Pinheirogustavo/Gustavo_TG_biomedica/README.md

# Gustavo_TG_biomedica
Este repositório se destina aos programas desenvolvidos durante a disciplina de Trabalho de Graduação em Engenharia Biomédica na Universidade Federal do ABC (UFABC). O tema do projeto é: Desenvolvimento de equipamento de análise de bioimpedância baseado em STM32
