Pinheirogustavo/Gustavo_TG_biomedica/Projetos das placas de circuito impresso/Kicad/Fonte de corrente monopolar/README.md

# Fonte de corrente monopolar

## Descrição Geral do projeto

Fonte de corrente controlada por tensão monopolar do tipo Howoland aperfeiçoada. O Sistema é excitado por um sinal senoidal e fornece uma corrente alternada de amplitude constante frente uma banda de resistências. Há um sistema de monitoramento da amplitude da corrente (Ampl1) que é implementado com um circuito de condicionamento dedicado.

Estágios Fonte de Corrente: Sinal de entrada(Sin1 ou SinA) &rarr; buffer &rarr; arquitetura fonte Howland &rarr; Resistor Sentinela//Amplificador de Instrumentação &rarr;  corrente I1.

Estágios monitoramento: Amplificador de Instrumentação &rarr; AmpOp &arrar; circuito de condicionamento &rarr; amplitude da corrente Ampl1.

## Componentes do circuito:

- Amplificador Operacional Dual AD826/828: Amplificador operacional duplo implementado como buffer na entrada do sistema e de acordo com a arquitetura da fonte Howland aperfeiçoada.
	>Amplificador 1: buffer.
	
	>Amplificador 2: arquitetura da fonte Howland aperfeiçoada.
- Resistor sentinela: Resistor de baixa resistência em série com a saída da fonte Howland. Implementado para monitorar a corrente gerada.
- Amplificador de Instrumentação INA: Amplificador de Instrumentação verifica a tensão sobre o resistor sentinela e aplica alto ganho fixo. A tensão de saída é condicionada e indica a amplitude da corrente (Ampl1).  Implementado para monitorar a corrente gerada. 
- Circuito de condicionamento: Condiciona o sinal para os limites do ADC do controlador (Selecionado com jumpers nos pinos "Vref" 3.3/5V). 

## Cuidados a serem tomados

## Estágios do circuito

#### Entrada do sinal de controle de corrente:

O sinal de entrada (Vin) determina a amplitude e frequência da corrente gerada. O sistema permite dois sinais de entrada, Sin1 e SinA, que são selecionados por uma chave gangorra kcd1.

A frequência da corrente é a mesma do sinal de entrada Vin. A amplitude da corrente é dada por:

$$ I = \frac{V_{in}}{R_6} $$

#### Buffer:

Buffer implementado na entrada do sistema com o amplificador operacional dual uma vez que o circuito do gerador de sinais foi projetado sem buffer em sua saída.

#### Arquitetura fonte Howland:

Fonte monopolar do tipo Howland aperfeiçoada.

#### Resistor sentinela e amplificador de instrumentação

#### Circuito de condicionamento

## Esquemático

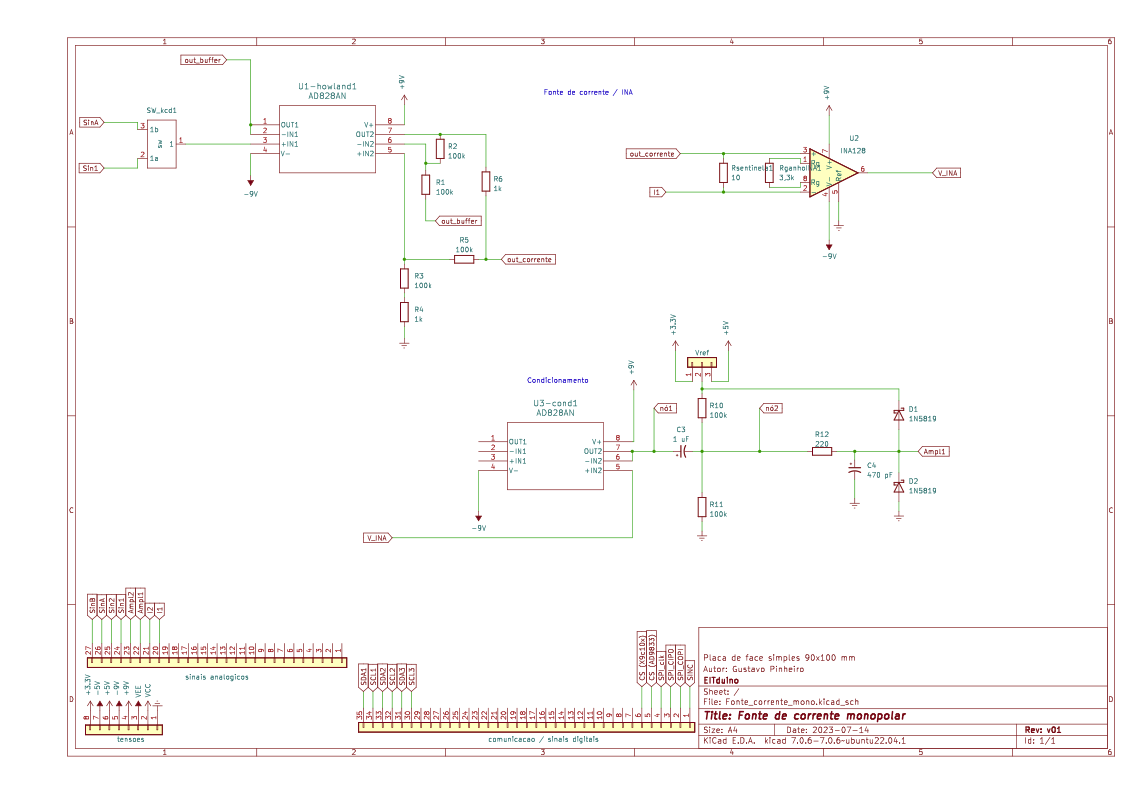
[picture p4: Projetos das placas de circuito impresso/Kicad/Fonte de corrente monopolar/prints/Fonte_corrente_monopolar_esquematico.png]
Fonte de corrente howland aperfeiçoada monopolar - Kicad


## PCB

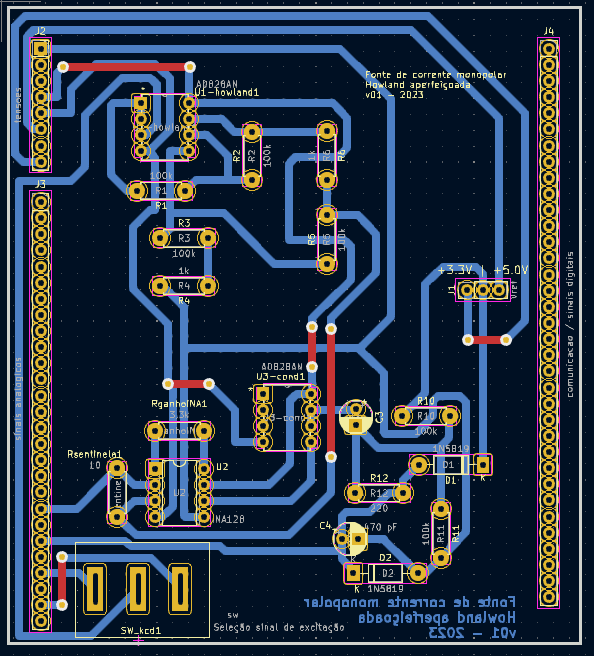
[picture p5: Projetos das placas de circuito impresso/Kicad/Fonte de corrente monopolar/prints/Fonte_corrente_monopolar_esquematico_PCB.png]
Fonte de corrente howland aperfeiçoada monopolar PCB - Kicad


## PCB-3D

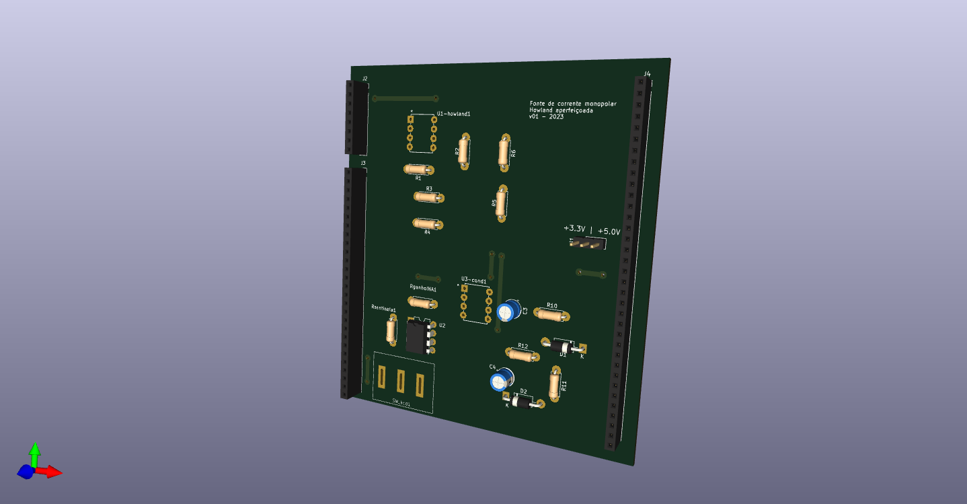
[picture p6: Projetos das placas de circuito impresso/Kicad/Fonte de corrente monopolar/prints/Fonte_corrente_mono_3D.png]
Fonte de corrente howland aperfeiçoada monopolar - PCB 3D Kicad


## PCB máscara

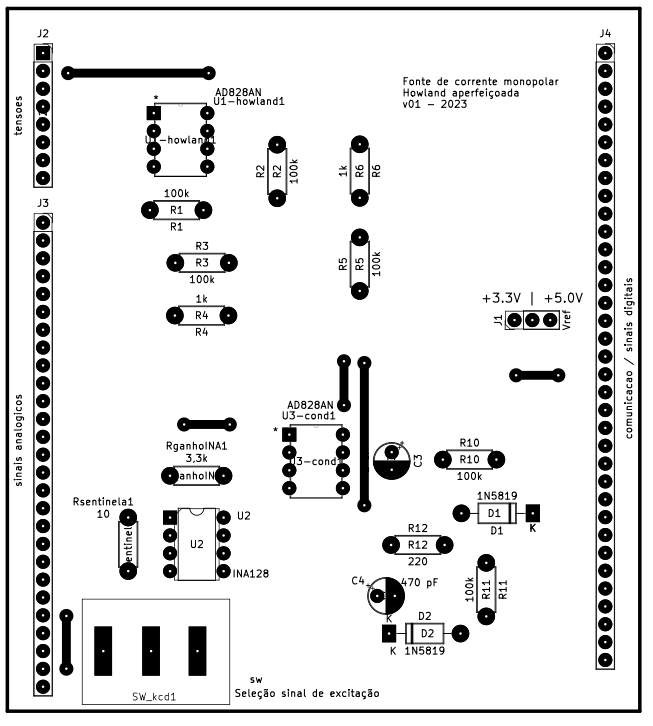
[picture p7: Projetos das placas de circuito impresso/Kicad/Fonte de corrente monopolar/prints/print_legenda.png]
Fonte de corrente howland aperfeiçoada monopolar - PCB máscara Kicad
