Pinheirogustavo/Gustavo_TG_biomedica/Projetos das placas de circuito impresso/Kicad/Gerador de sinais/README.md

# Gerador de Sinais

## Descrição Geral do projeto

Sistema que gera um sinal senoidal com controle de amplitude e frequência.

Estágios: Gerador de sinais ( CA@300mV + DC) &rarr; Filtro  passa-alta &rarr; SinA (CA@300mV) &rarr; buffer &rarr;  amplificador não-inversor &rarr; Sin1(CA@300mV-3V).

## Componentes do circuito:

- Arduino nano: controlador do sistema
- AD9833: gerador de sinais confeccionado em módulo. Gera uma onda senoidal de amplitude fixa de 300mA e offset
- Ad828: Amplificador operacional dedicado ao ganho de sinal. 
	>Amplificador 1 é buffer entre o filtro passa-alta e o circuito de ganho.
	>Amplificador 2 é um amplificador não inversor. Vout = (1+pot/R2)*Vin
- X9c10x: potenciometro digital dedicado ao ganho de sinal

## Cuidados a serem tomados

Para a comunicação SPI, o dispositivo a ser controlado (Chip Select) é selecionado quando o respectivo pino CS está em LOW. Nunca pode-se permitir que dois dispositivos estejam com CS em LOW ao mesmo tempo. Por isso, no programa é preciso garantir que as operações com o AD9833 (select_wave, freq+ e freq-)  após um delay tragam o sinal do CS(AD9833) para LOW e depois devolvam para HIGH. E que as operações com o X9110X (aumento de R, redução de R, guardar R) após um delay tragam o sinal do CS(X9c10X) para LOW e depois devolvam para HIGH.

Assim, primeiramente o programa deve liberar o AD9833 (gerador de sinais) para ocupar a comunicação SPI, após a geração de sinal, desligar sua comunicação (trazer seu CS para HIGH) e liberar a comunicação SPI para ser requisitada a partir dos botões referentes a cada dispositivo. 

## Estágios do circuito

#### Entradas e saídas digitais do arduino nano:

>D2:  cs (X9X104) - Saída digital. Sinal de Chip Select do potenciômetro digital - "The device is selected when the CS input is LOW." 

>D3: storage_R - Usado para armazenar o valor de resistência - Botão 4 - Pressionar o botão faz o sinal X9c10x_INC  ficar em HIGH e o sinal  cs(X9X104) passar de HIGH para LOW e retornar a HIGH

>D4:  cs (AD9833) - Sinal de Chip Select do gerador de sinais

>D5:  Up_pot - Aumenta a resistência do potenciômetro (aumenta o ganho do sistema) - Botão 5 - Pressionar o botão faz com que o sinal de cs(X9X104) passe de HIGH para LOW, que o sinal X9c10x_INC altere de HIGH para LOW e o sinal  X9c10x_U/D fique em HIGH. Ao liberar o botão, o sinal de cs(X9X104) deve retornar para HIGH.
	 
>D6:  Down_pot - Reduz a resistência do potenciômetro (reduz o ganho do sistema) - Botão 6 - Pressionar o botão faz com que o sinal de cs(X9X104) passe de HIGH para LOW, X9c10x_INC altere de HIGH para LOW e o sinal  X9c10x_U/D fique em LOW. Ao liberar o botão, o sinal de cs(X9X104) deve retornar para HIGH.

>D7:  X9c10x_INC - Saída digital. Responsável pelo disparo do sinal que habilita o incremento e o decremento da resistência. Alterado pelos sinais em Up_pot/Down_pot.

>D8:  X9c10x_U/D -  Saída digital. Responsável pela seleção do sinal de incremento ou decremento da resistência. Controlado pelos sinais em Up_pot/Down_pot.

>D9:  freq+   - Incrementa a frequência do sinal (a definir o tamanho do incremento) - Botão 2 - Ainda não implementado no programa.

>D10: freq-   - Decrementa a frequência do sinal (a definir o tamanho do decremento) - Botão 3 - Ainda não implementado no programa.

>D11: SPI_COPI - Saída digital. Sinal de controle do arduino para a entrada SDATA do gerador de sinais.

>D12: S_wave - Seleciona a forma de onda desejada (seno, triangular ou quadrada) - Botão 1 - Ainda não implementado no programa.

>D13: SPI_clk - Saída digital. Sinal de clock entre o arduino e o gerador de sinais

#### O potenciômetro digital

- Programa baseado em: https://www.electroniclinic.com/digital-potentiometer-x9c103s-arduino-circuit-and-programming/

- Pin Descriptions - X9c10x:

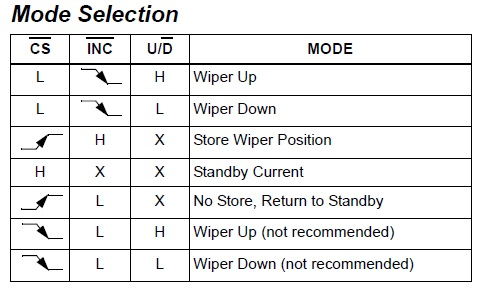
[picture p8: Projetos das placas de circuito impresso/Kicad/Gerador de sinais/Datasheets/Digital-Potentiometer-X9C103s-Mode-selection.jpg]
Pin Descriptions - X9c10x


#### O Gerador de sinais

- Programa baseado em: https://www.electroniclinic.com/ad9833-programmable-waveform-generator-using-arduino/
- Biblioteca necessária: https://github.com/Billwilliams1952/AD9833-Library-Arduino

## Esquemático

Esquemático Gerador de sinais - Kicad

## PCB

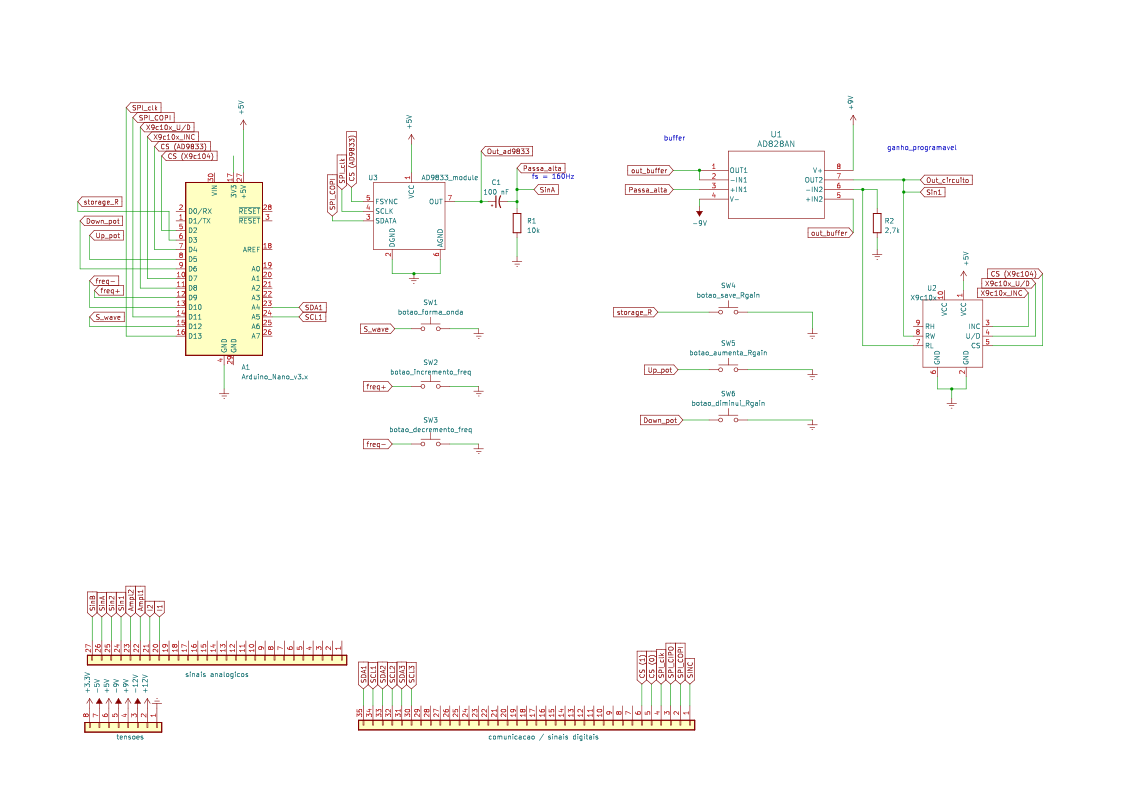
[picture p9: Projetos das placas de circuito impresso/Kicad/Gerador de sinais/print/Gerador_sinais_AD9833_esquematico.png]
Gerador de sinais AD9833 PCB - Kicad


## PCB-3D

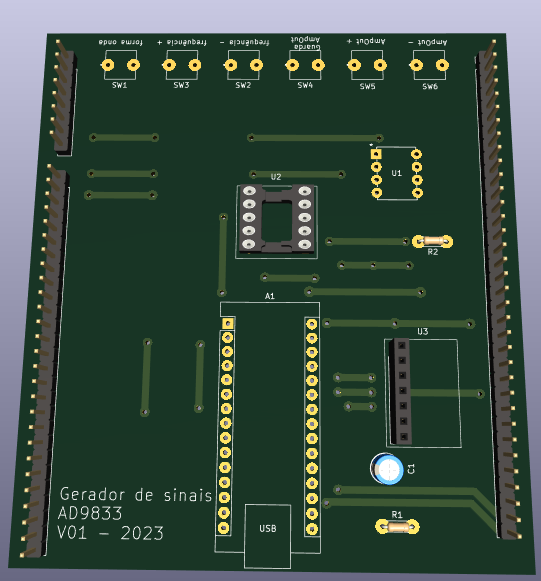
[picture p10: Projetos das placas de circuito impresso/Kicad/Gerador de sinais/print/Gerador_sinais_AD9833_PCB_3D.png]
Gerador de sinais AD9833 PCB 3D - Kicad


## PCB Máscara

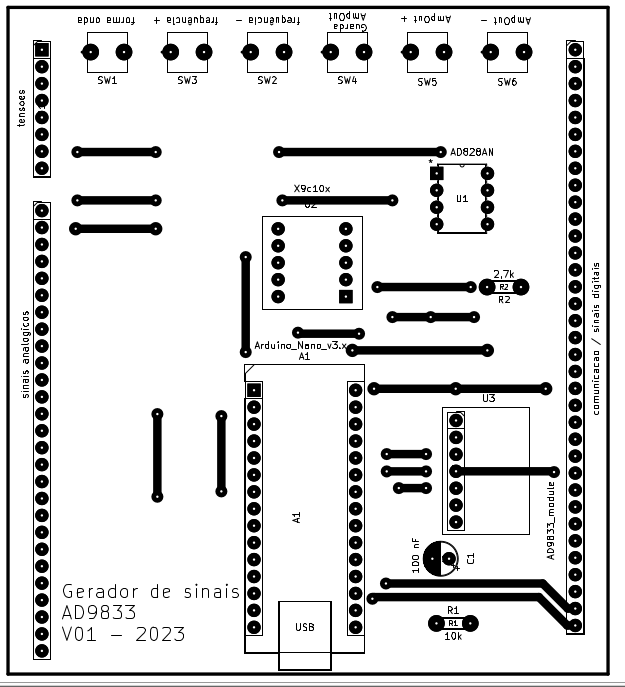
[picture p11: Projetos das placas de circuito impresso/Kicad/Gerador de sinais/print/print_mascara.png]
Gerador de sinais AD9833 PCB Máscara - Kicad
