Pinheirogustavo/Gustavo_TG_biomedica/Projetos das placas de circuito impresso/Kicad/Barramento/V03/README.md

# V02

- Diversos pontos de terras, separados em terras dos sinais analógicos (AGND) e terras dos sinais digitais (DGND).
- As alimentações dos circuitos analógicos foram separadas das alimentações dos circuitos digitais.

# Esquemático

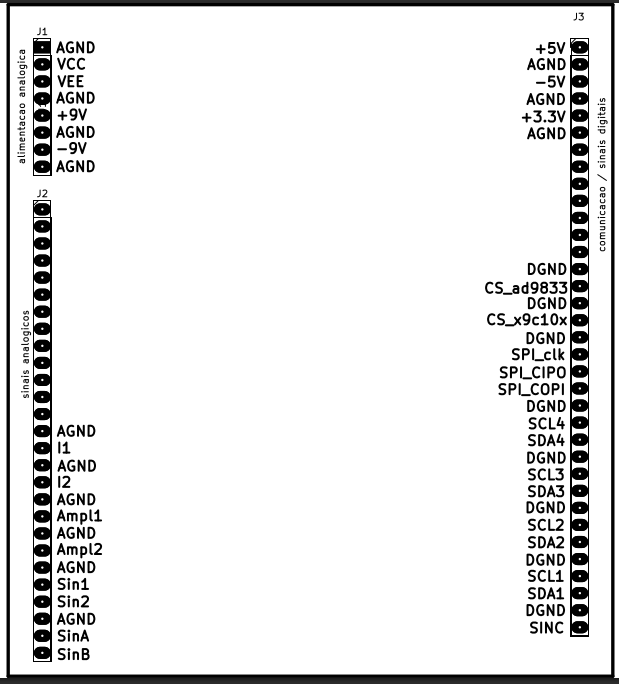
[picture p12: Projetos das placas de circuito impresso/Kicad/Barramento/V03/print/barramento_v02.png]
Barramento EITduino V02 preto e branco - Kicad


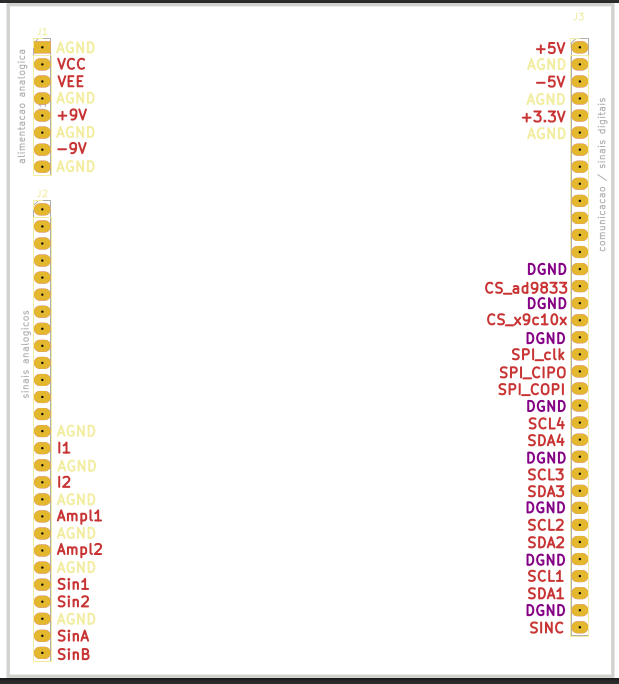
[picture p13: Projetos das placas de circuito impresso/Kicad/Barramento/V03/print/barramento_v02_colorido.png]
Barramento EITduino V02 colorido - Kicad
