Pinheirogustavo/Gustavo_TG_biomedica/Projetos das placas de circuito impresso/Kicad/Fonte de tensão/Fonte_tensao_LM675_v03/README.md

# Fonte de tensão - Versão 03

## Esquemático

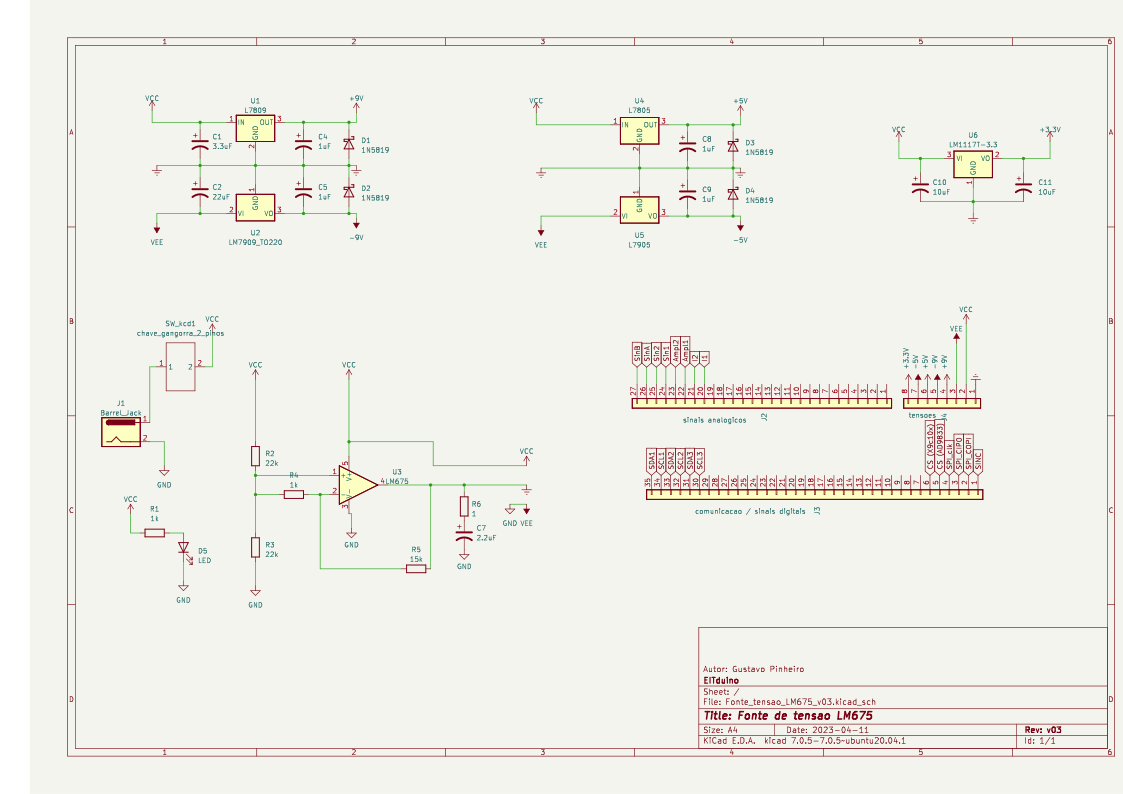
[picture p14: Projetos das placas de circuito impresso/Kicad/Fonte de tensão/Fonte_tensao_LM675_v03/print/Fonte_tensao_v03_esquematico.png]
Legenda Esquematico- Kicad


## PCB

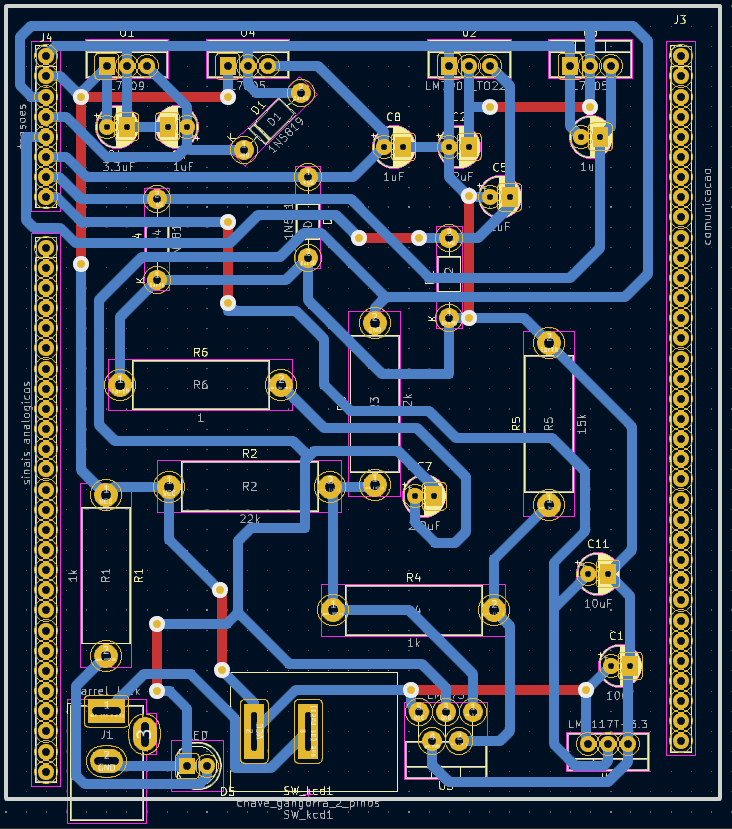
[picture p15: Projetos das placas de circuito impresso/Kicad/Fonte de tensão/Fonte_tensao_LM675_v03/print/Fonte_tensao_PCB_v03.png]
Legenda PCB- Kicad


## PCB-3D

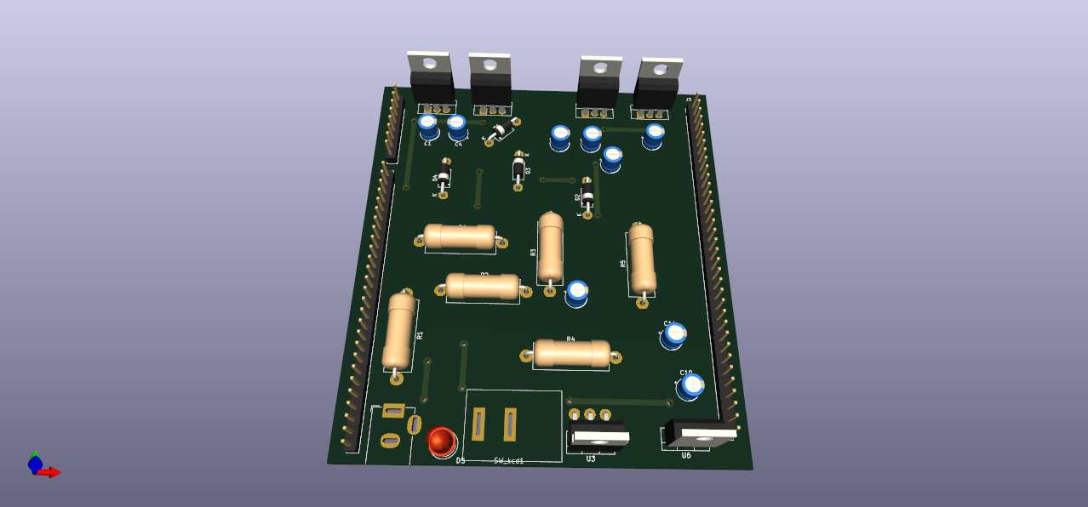
[picture p16: Projetos das placas de circuito impresso/Kicad/Fonte de tensão/Fonte_tensao_LM675_v03/print/Fonte_tensao_PCB_3D_v03.png]
legenda PCB 3D - Kicad


## PCB Máscara

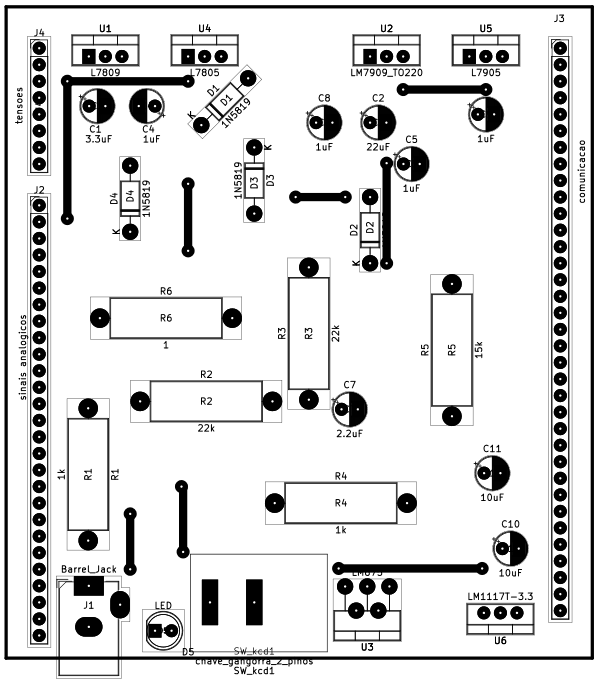
[picture p17: Projetos das placas de circuito impresso/Kicad/Fonte de tensão/Fonte_tensao_LM675_v03/print/Fonte_tensao_PCB_Mascara_v03.png]
legenda PCB Máscara - Kicad
