Pinheirogustavo/Gustavo_TG_biomedica/Projetos das placas de circuito impresso/Kicad/Barramento/V01/README.md

# V01

Único ponto de terra.

# Esquemático

Barramento EITduino V01 preto e branco- Kicad

---------------------------------------------------------------------------------------------------------

Barramento EITduino V01 colorido- Kicad
