Pinheirogustavo/Gustavo_TG_biomedica/Projetos das placas de circuito impresso/Kicad/Fonte de tensão/Fonte_tensao_LM675_v01/README.md

# Fonte de tensão

## Descrição Geral do projeto

XXX.

Estágios:

## Componentes do circuito:

- xx
- xx
	>xx
	
##Cuidados a serem tomados

xx
## Estágios do circuito

#### xx

>xx

>xx

#### xx

- xx

- xx

## Esquemático

Legenda Esquematico- Kicad

## PCB

Legenda PCB- Kicad

## PCB-3D

legenda PCB 3D - Kicad

## PCB Máscara

legenda PCB Máscara - Kicad
