Pinheirogustavo/Gustavo_TG_biomedica/apresentacao/barramento.png

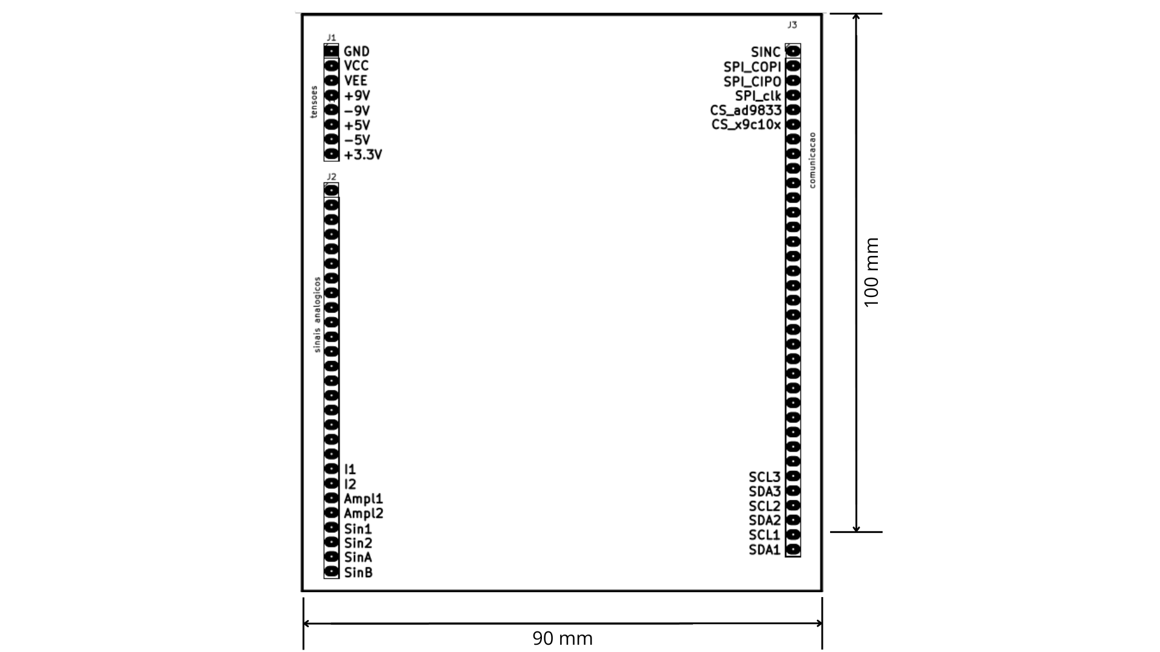
apresentacao/barramento.png
