Pinheirogustavo/Gustavo_TG_biomedica/apresentacao/Completo_1.jpeg

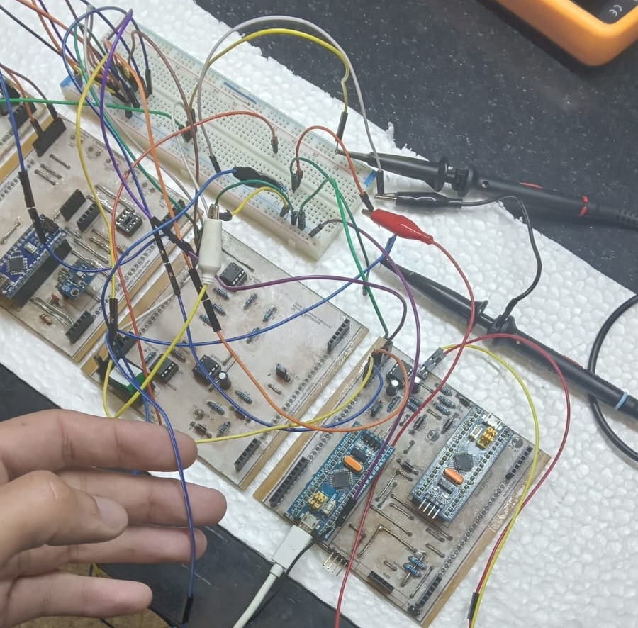
apresentacao/Completo_1.jpeg
