Pinheirogustavo/Gustavo_TG_biomedica/apresentacao/Completo_2.jpeg

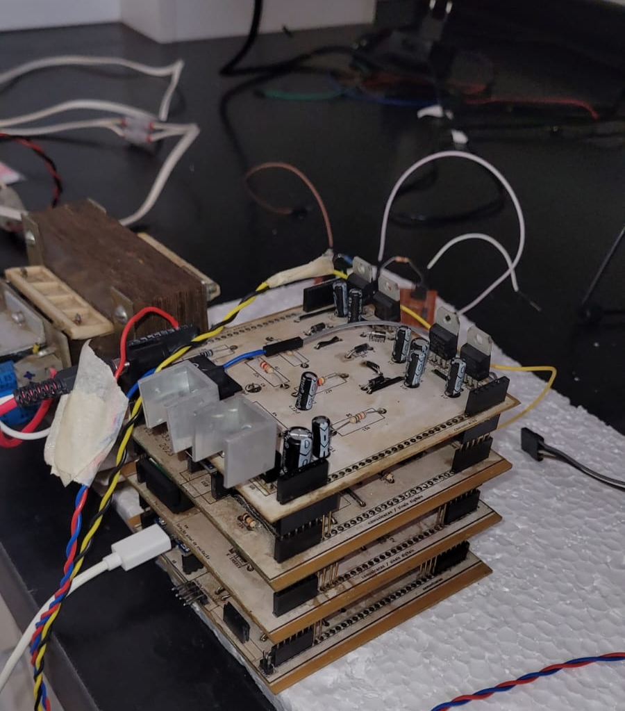
apresentacao/Completo_2.jpeg
