Pinheirogustavo/Gustavo_TG_biomedica/apresentacao/Completo_3.jpeg

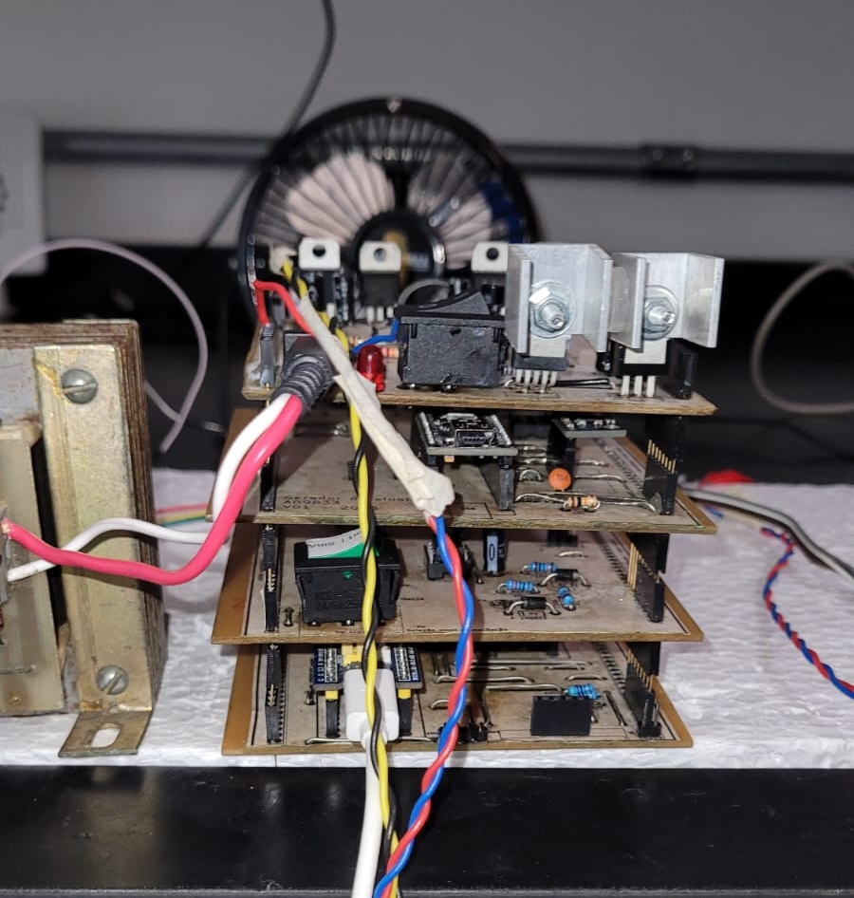
apresentacao/Completo_3.jpeg
