Pinheirogustavo/Gustavo_TG_biomedica/apresentacao/Completo_4.jpeg

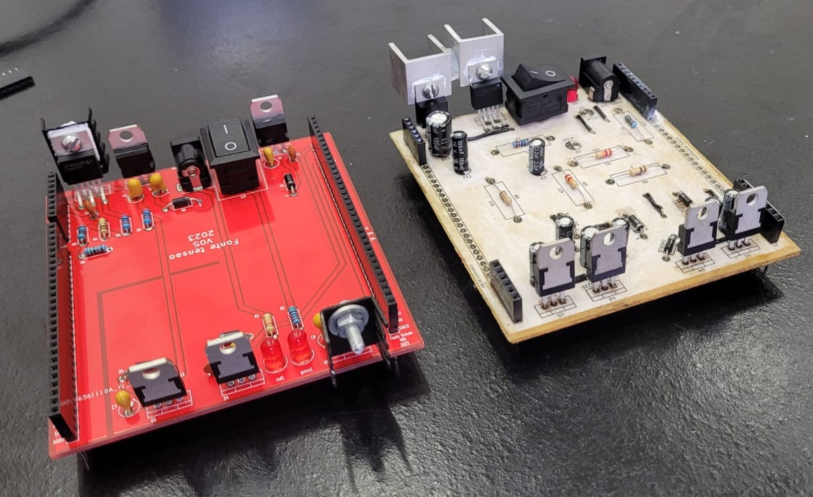
apresentacao/Completo_4.jpeg
