Pinheirogustavo/Gustavo_TG_biomedica/apresentacao/CompletoX.png

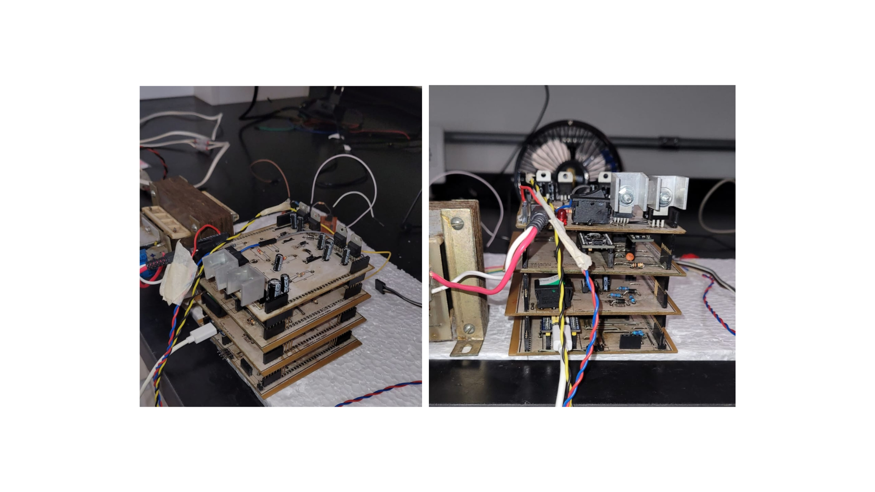
apresentacao/CompletoX.png
