Pinheirogustavo/Gustavo_TG_biomedica/apresentacao/FFM_1.png

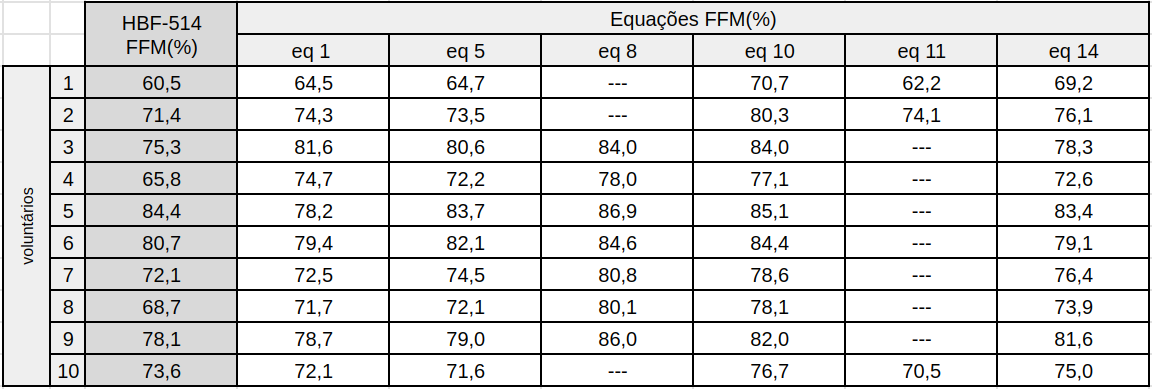
apresentacao/FFM_1.png
