Pinheirogustavo/Gustavo_TG_biomedica/apresentacao/FFM_homens.png

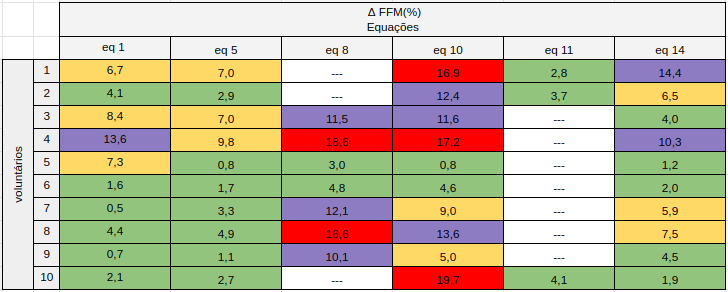
apresentacao/FFM_homens.png
