Pinheirogustavo/Gustavo_TG_biomedica/apresentacao/FFM_mulheres.png

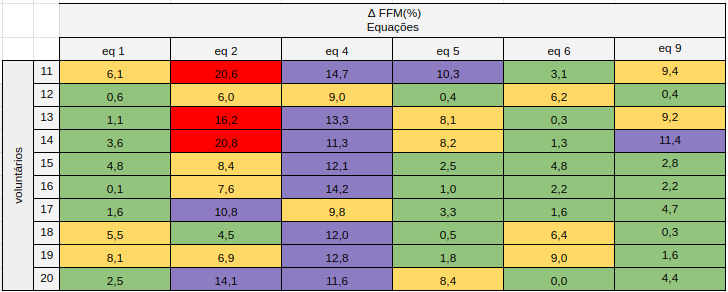
apresentacao/FFM_mulheres.png
