Pinheirogustavo/Gustavo_TG_biomedica/apresentacao/Fonte_tensao_comparacao_baixo.jpeg

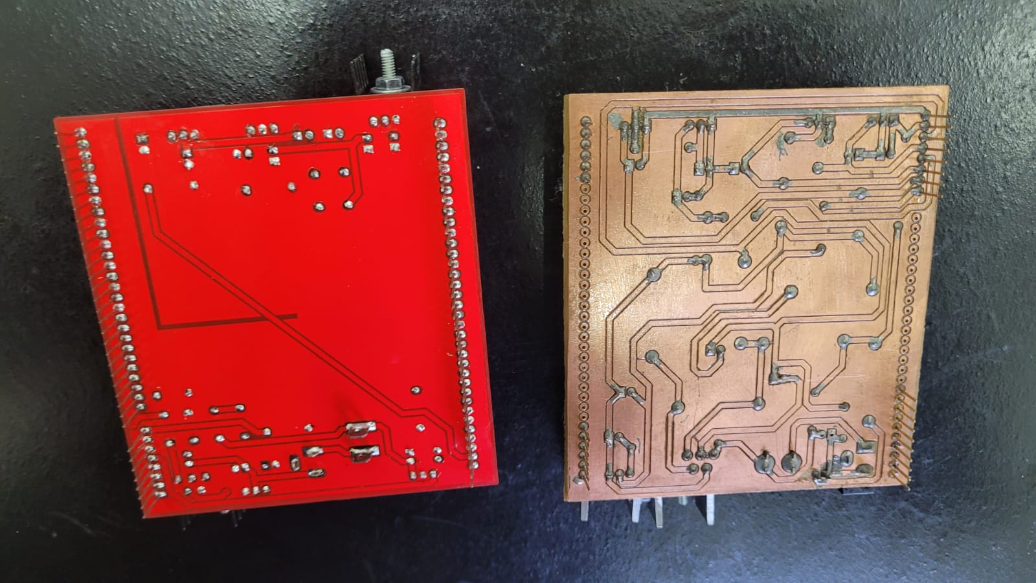
apresentacao/Fonte_tensao_comparacao_baixo.jpeg
