Pinheirogustavo/Gustavo_TG_biomedica/apresentacao/Fonte_tensao_comparacao_cima.jpeg

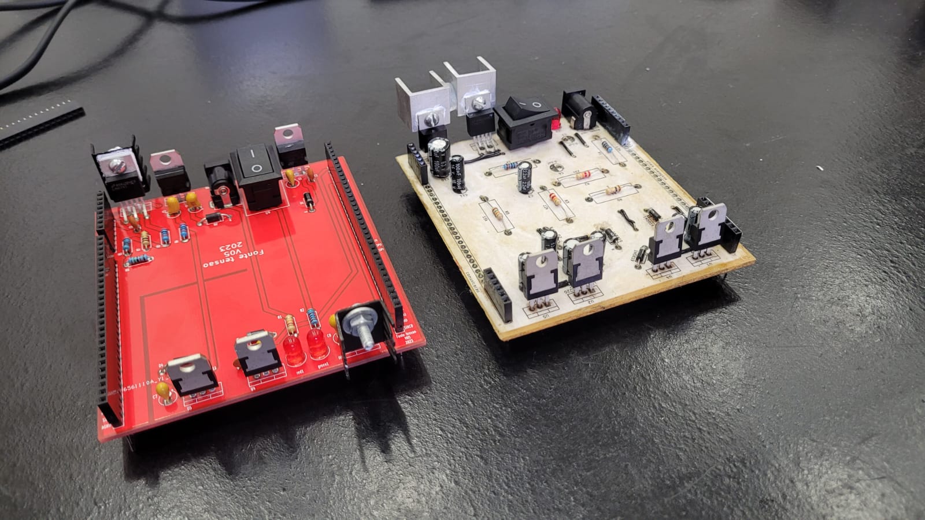
apresentacao/Fonte_tensao_comparacao_cima.jpeg
