Pinheirogustavo/Gustavo_TG_biomedica/apresentacao/largura_banda_ampOps.png

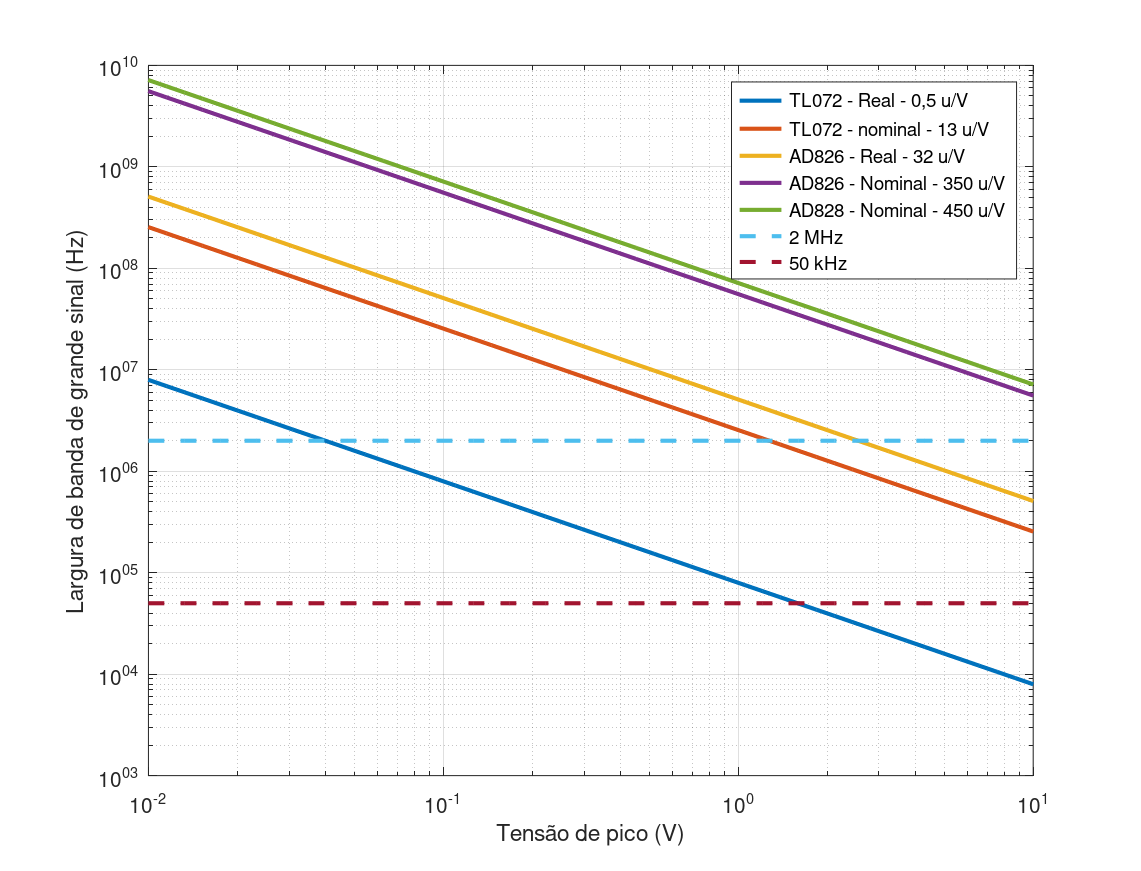
apresentacao/largura_banda_ampOps.png
