Pinheirogustavo/Gustavo_TG_biomedica/apresentacao/largura_banda_sr.jpg

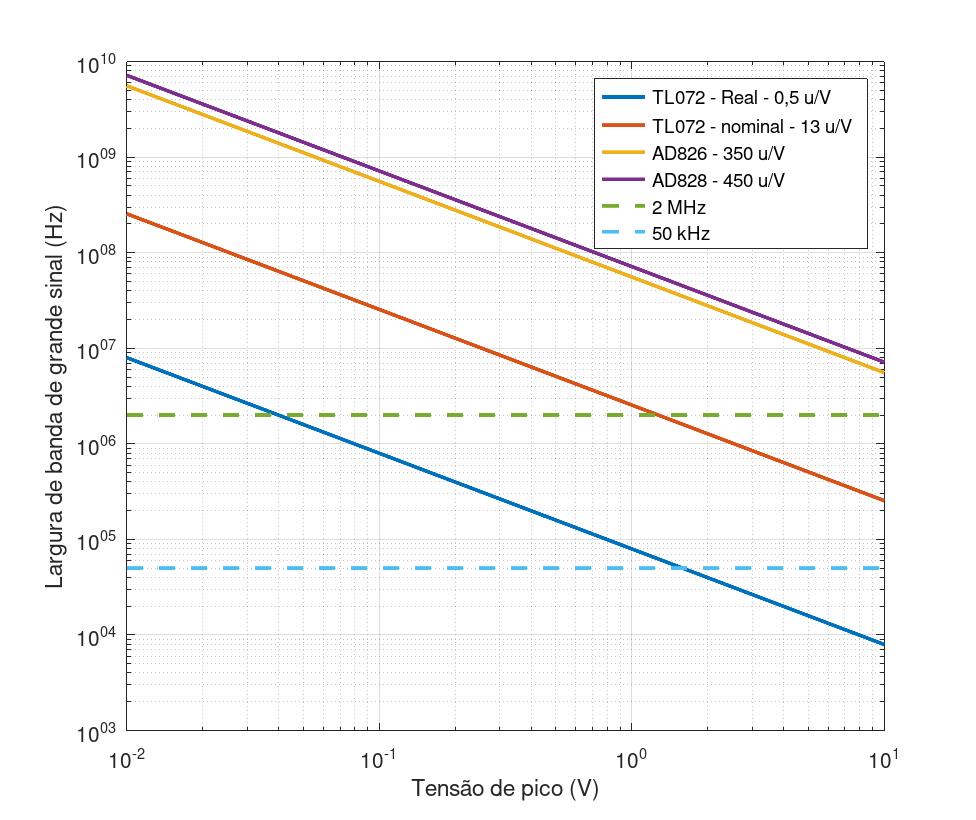
apresentacao/largura_banda_sr.jpg
