Pinheirogustavo/Gustavo_TG_biomedica/apresentacao/resumo.jpg

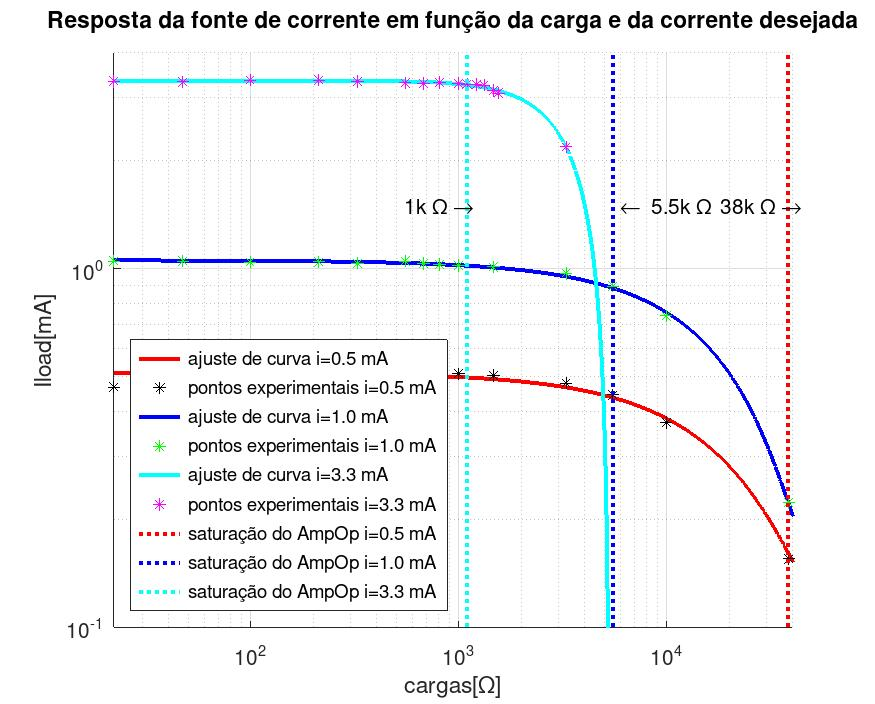
apresentacao/resumo.jpg
