Pinheirogustavo/Gustavo_TG_biomedica/apresentacao/TBW_2.png

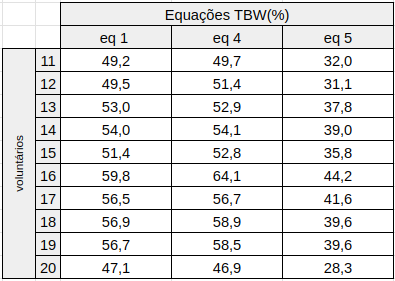
apresentacao/TBW_2.png
