Pinheirogustavo/Gustavo_TG_biomedica/apresentacao/temp/Condicionamento_geral.png

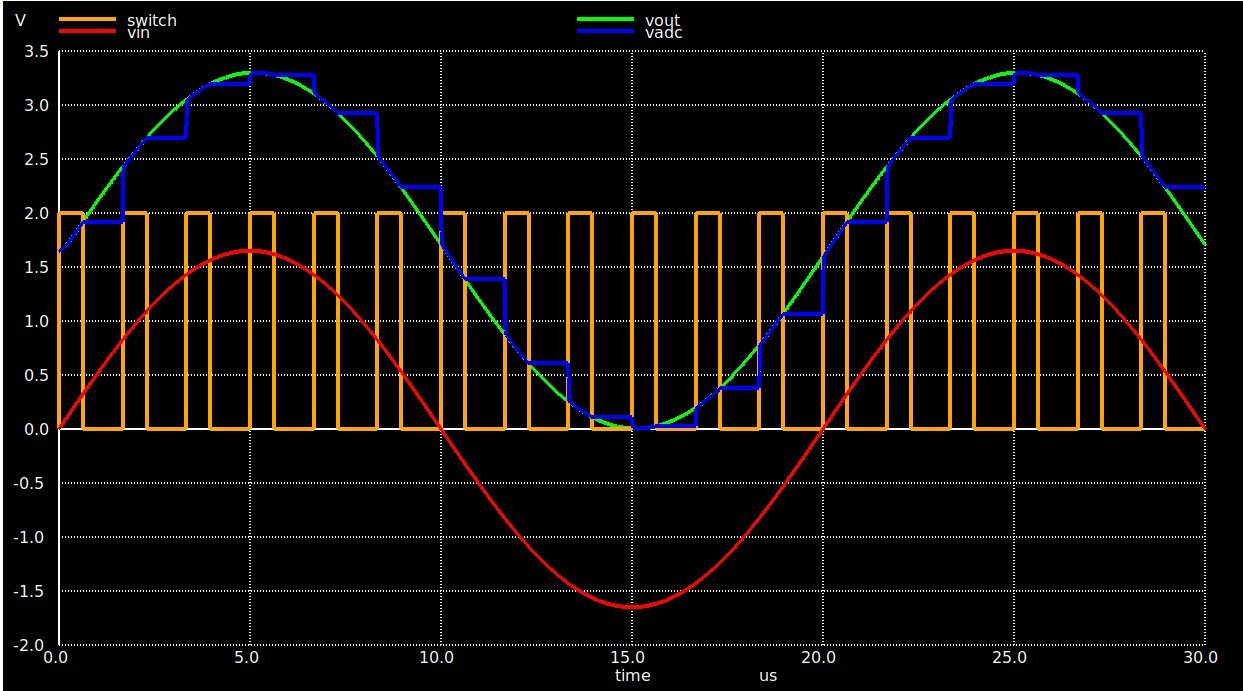
apresentacao/temp/Condicionamento_geral.png
