Pinheirogustavo/Gustavo_TG_biomedica/apresentacao/temp/Condicionamento_geral_invertido.png

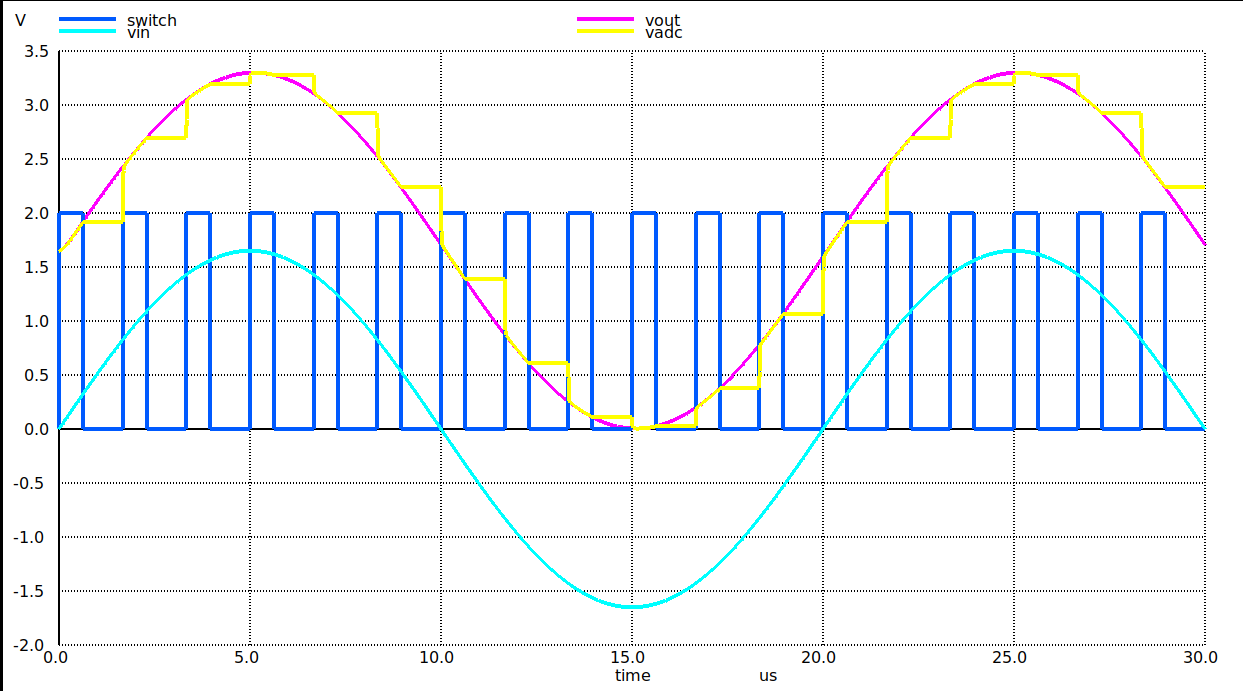
apresentacao/temp/Condicionamento_geral_invertido.png
