Pinheirogustavo/Gustavo_TG_biomedica/apresentacao/temp/Erro_adc.png

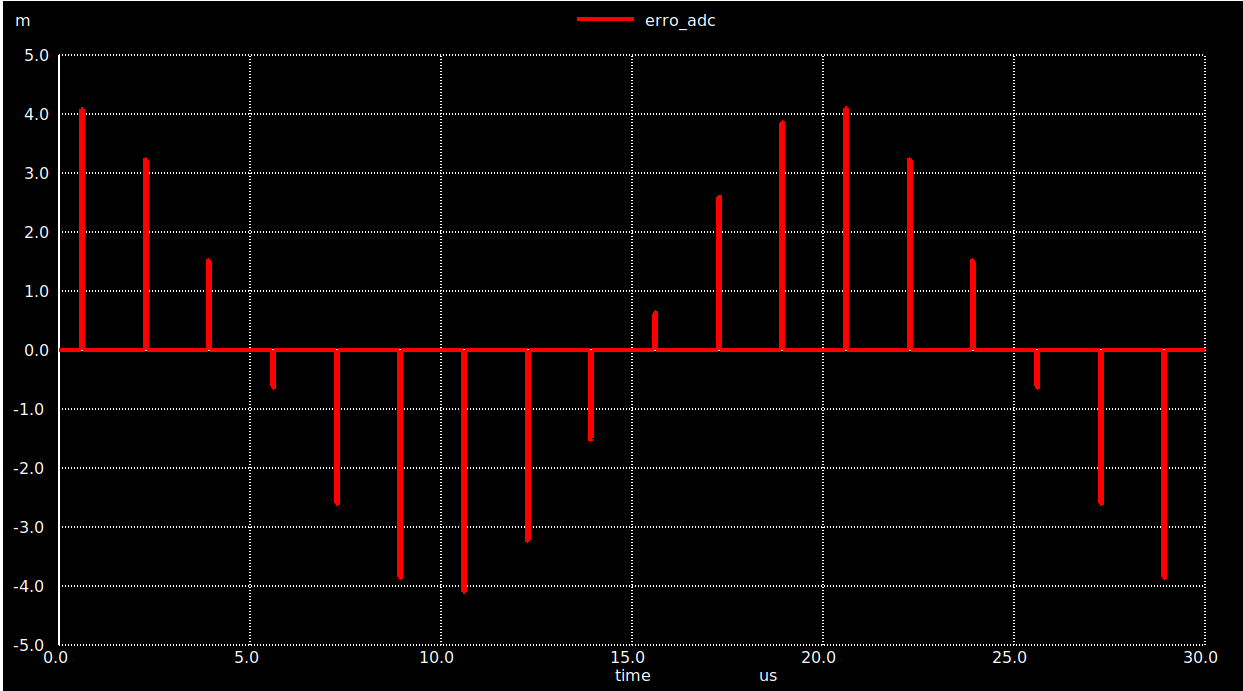
apresentacao/temp/Erro_adc.png
