Pinheirogustavo/Gustavo_TG_biomedica/apresentacao/temp/Erro_buffer.png

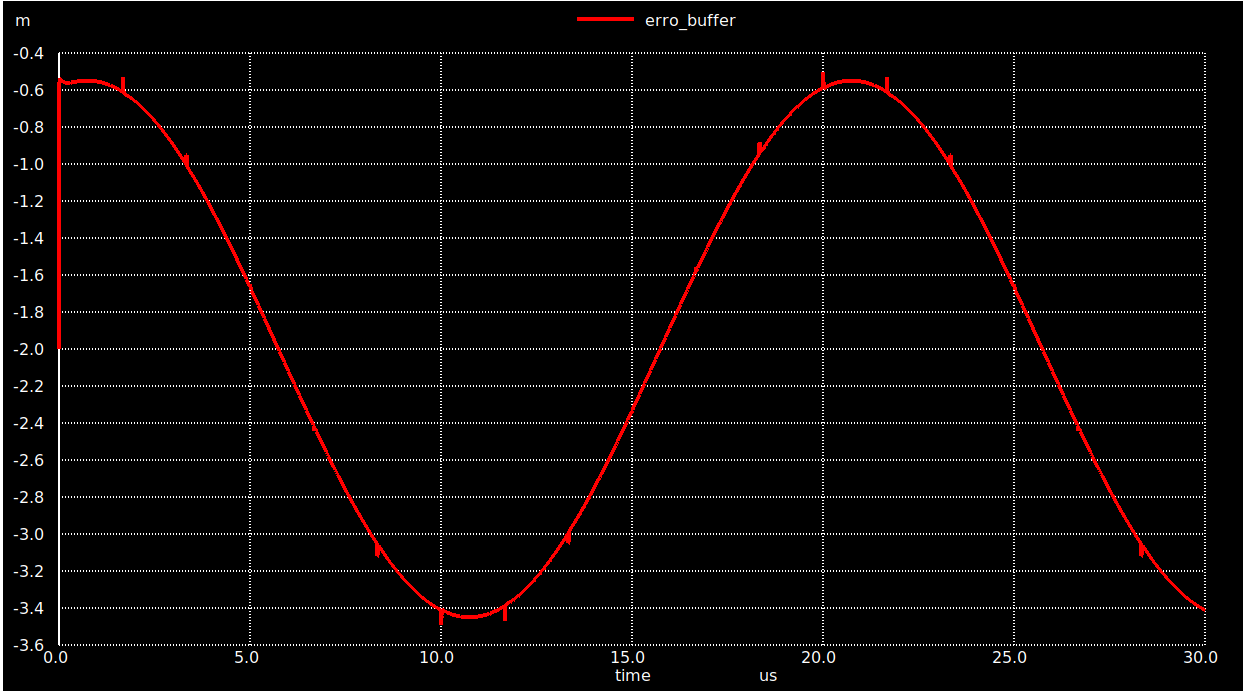
apresentacao/temp/Erro_buffer.png
