Pinheirogustavo/Gustavo_TG_biomedica/apresentacao/temp/Erro_fpb.png

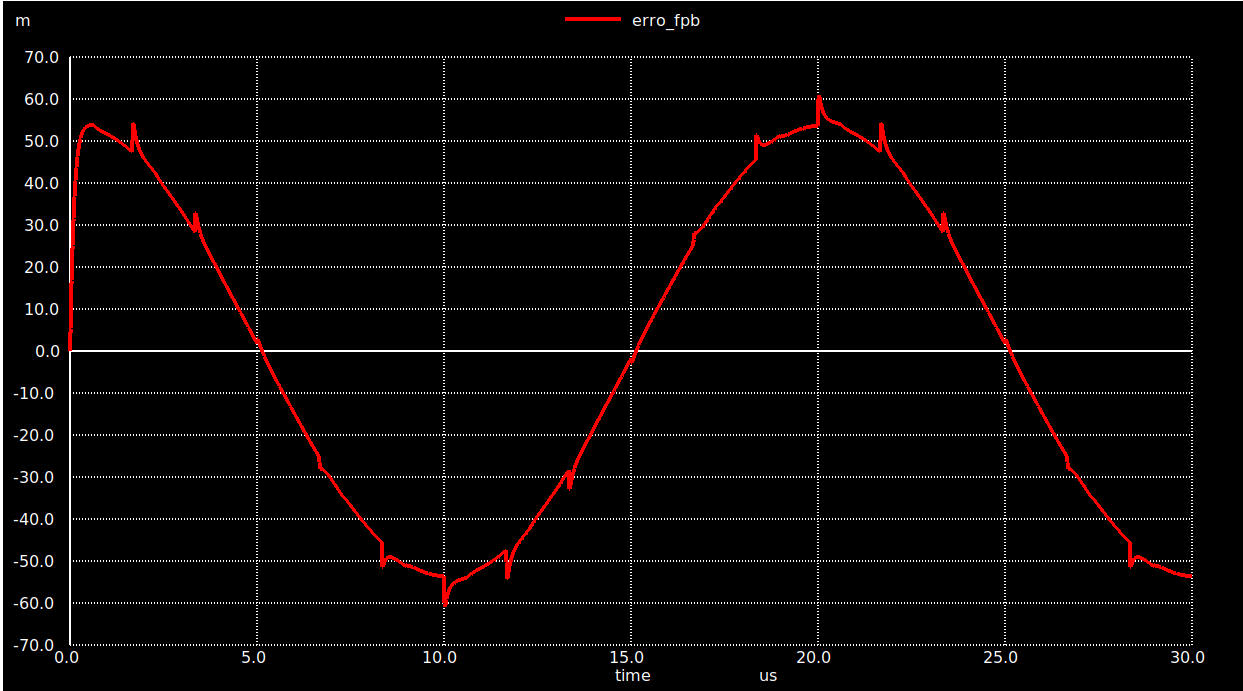
apresentacao/temp/Erro_fpb.png
