Pinheirogustavo/Gustavo_TG_biomedica/apresentacao/temp/Erro_os.png

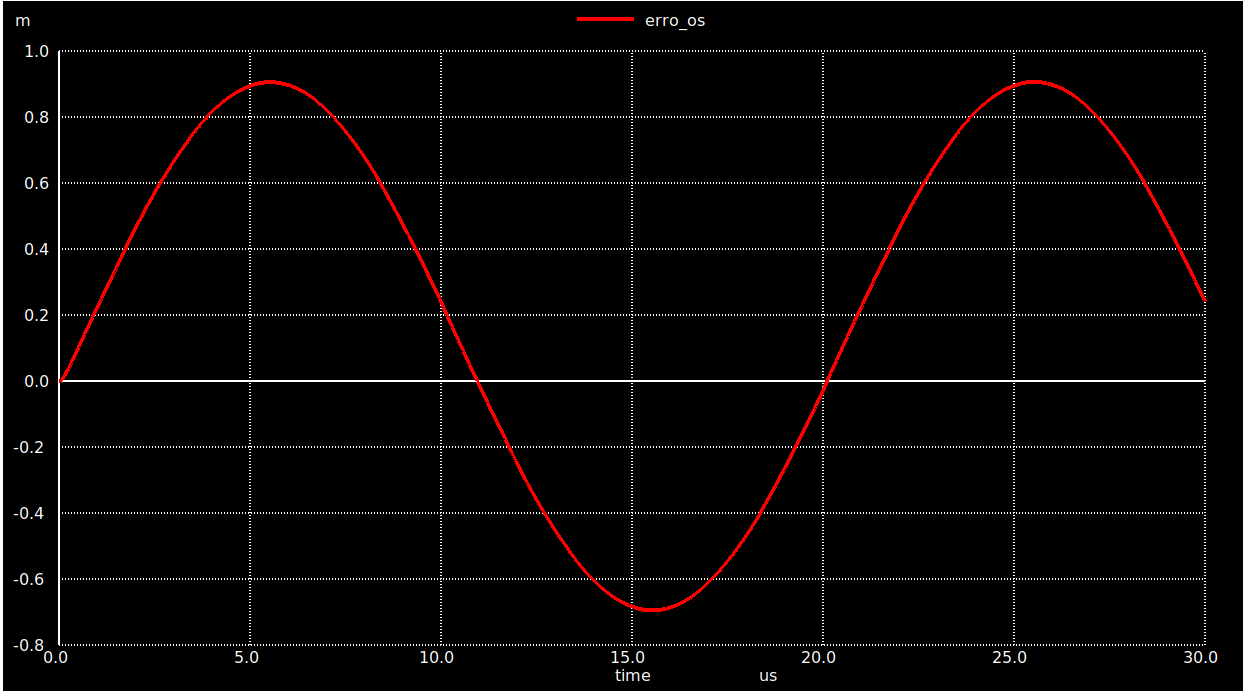
apresentacao/temp/Erro_os.png
