Pinheirogustavo/Gustavo_TG_biomedica/apresentacao/temp/Erros_todos.png

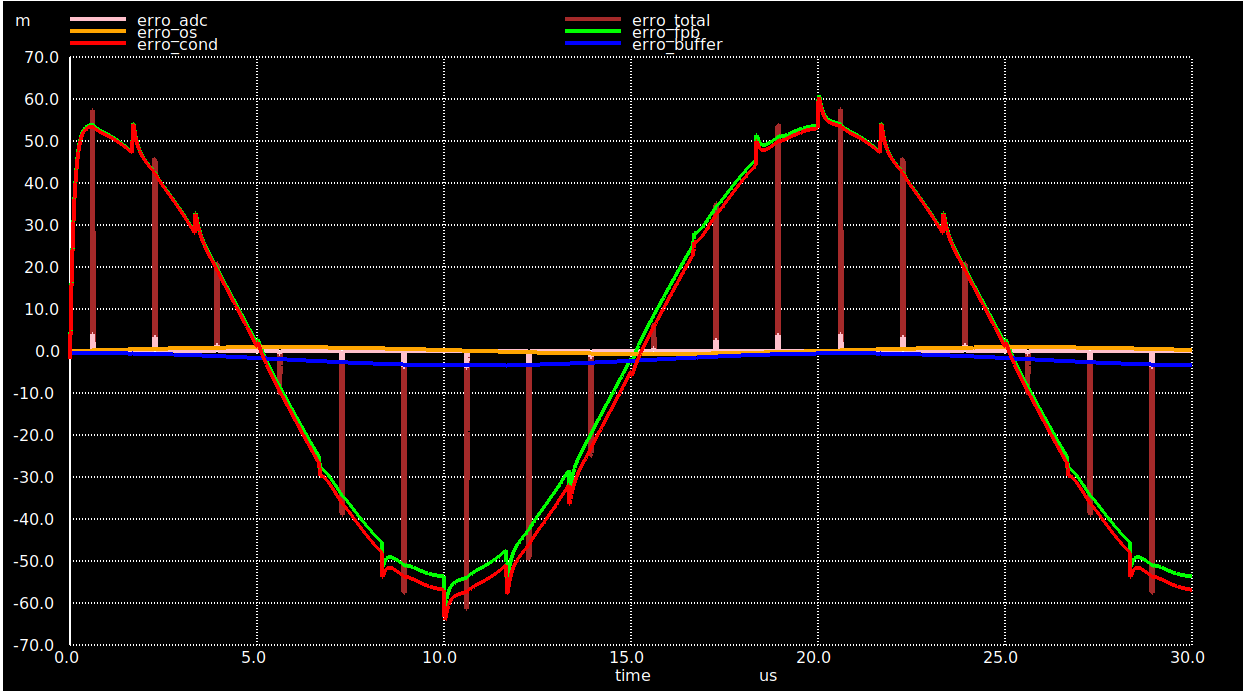
apresentacao/temp/Erros_todos.png
