Pinheirogustavo/Gustavo_TG_biomedica/apresentacao/temp/invertido/Condicionamento_geral.png

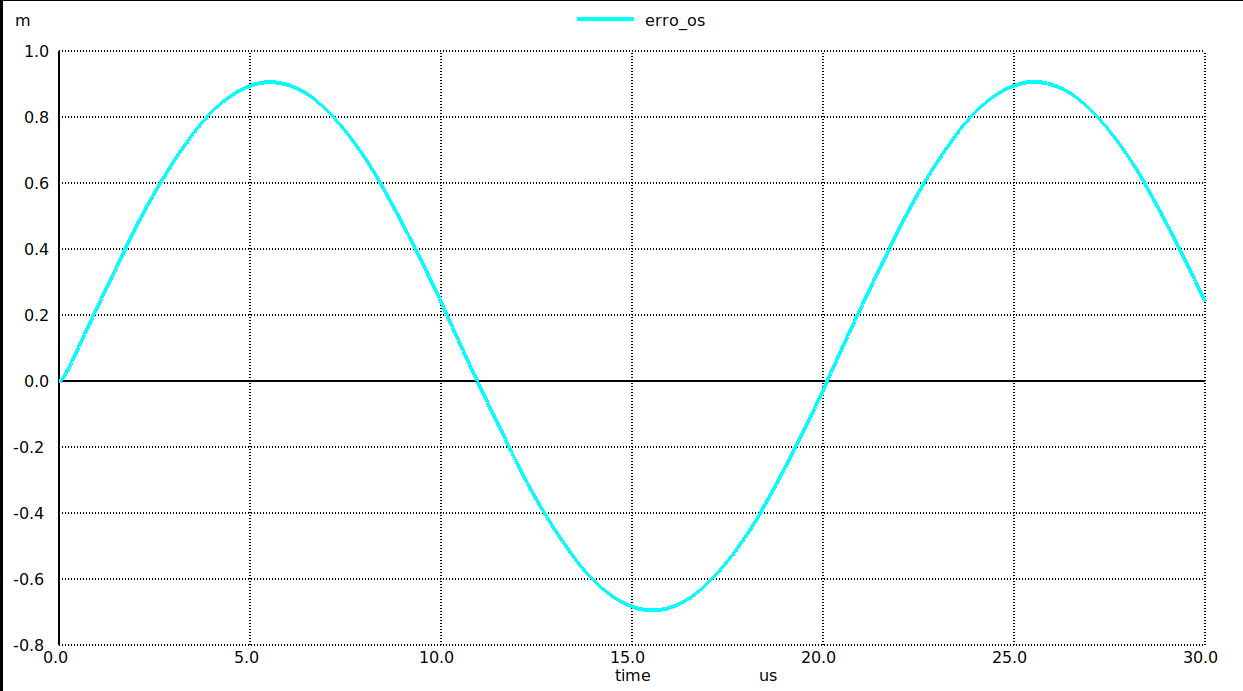
apresentacao/temp/invertido/Condicionamento_geral.png
