Pinheirogustavo/Gustavo_TG_biomedica/apresentacao/temp/invertido/Erro_adc.png

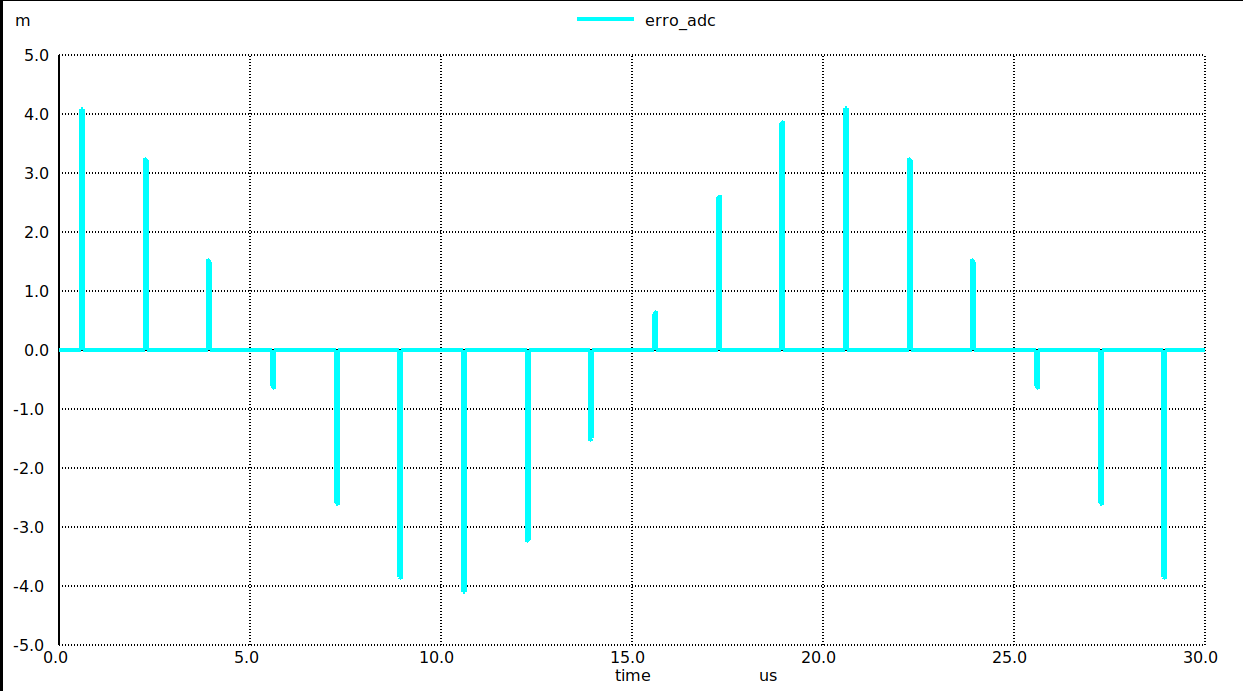
apresentacao/temp/invertido/Erro_adc.png
