Pinheirogustavo/Gustavo_TG_biomedica/apresentacao/temp/invertido/Erro_buffer.png

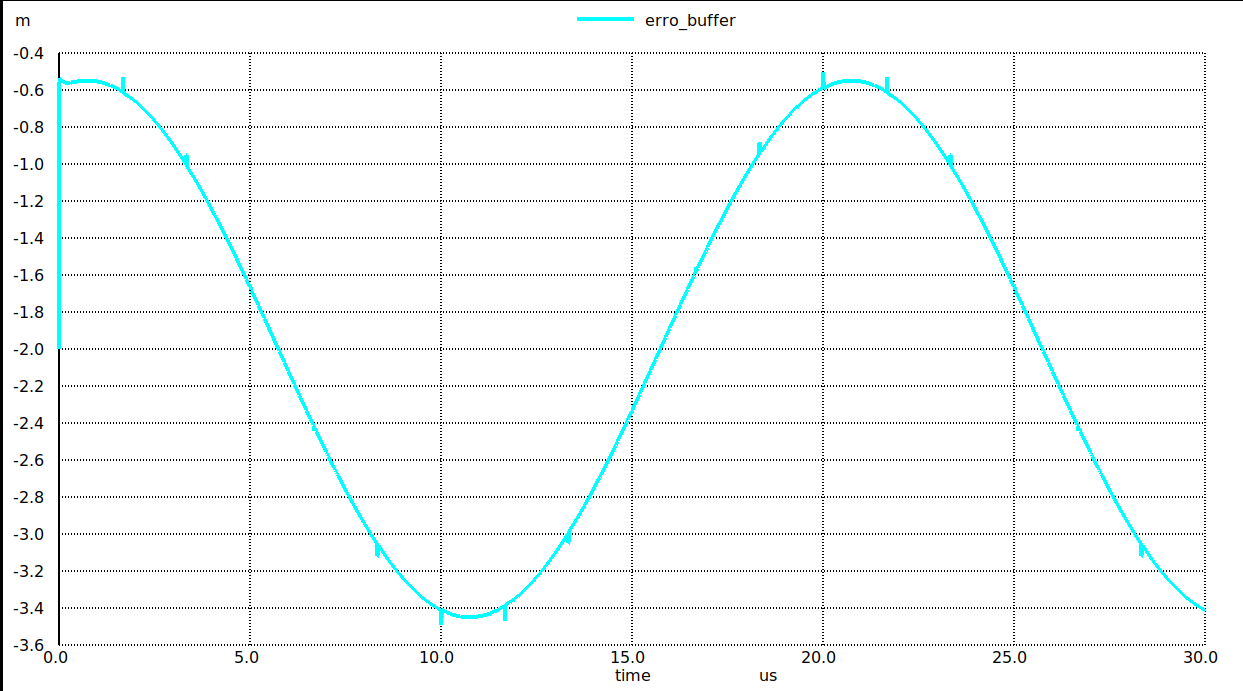
apresentacao/temp/invertido/Erro_buffer.png
