Pinheirogustavo/Gustavo_TG_biomedica/apresentacao/temp/invertido/Erro_fpb.png

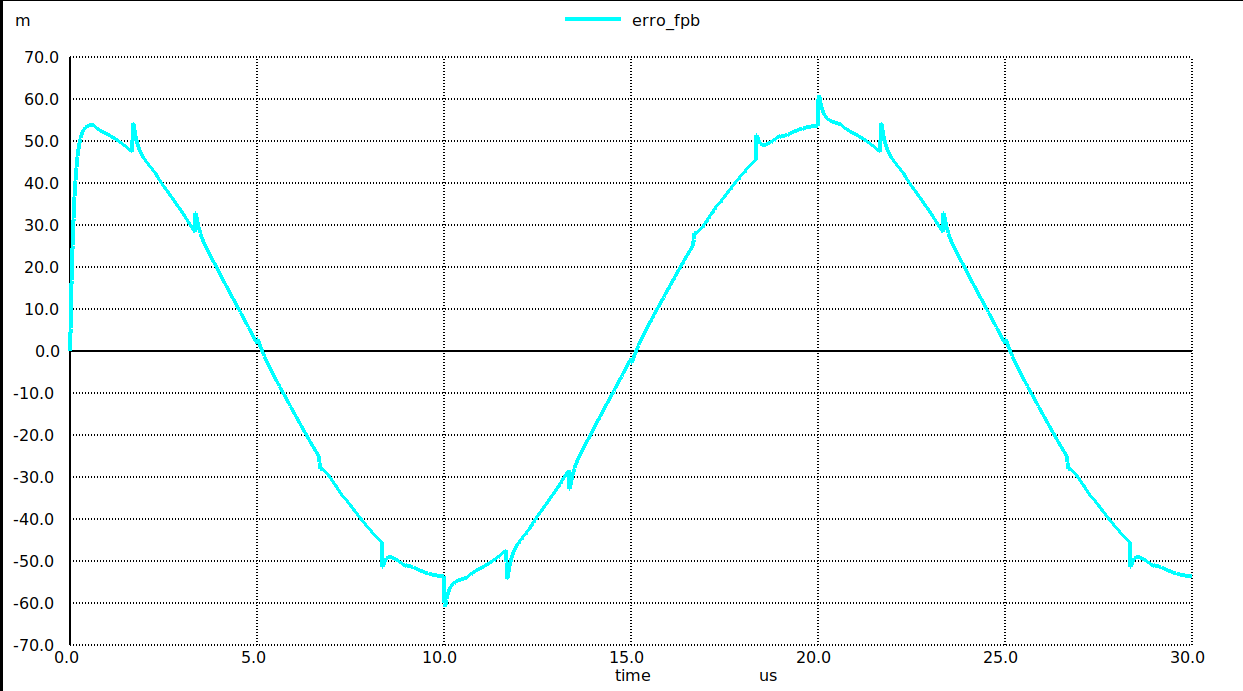
apresentacao/temp/invertido/Erro_fpb.png
