Pinheirogustavo/Gustavo_TG_biomedica/apresentacao/temp/invertido/Erro_total.png

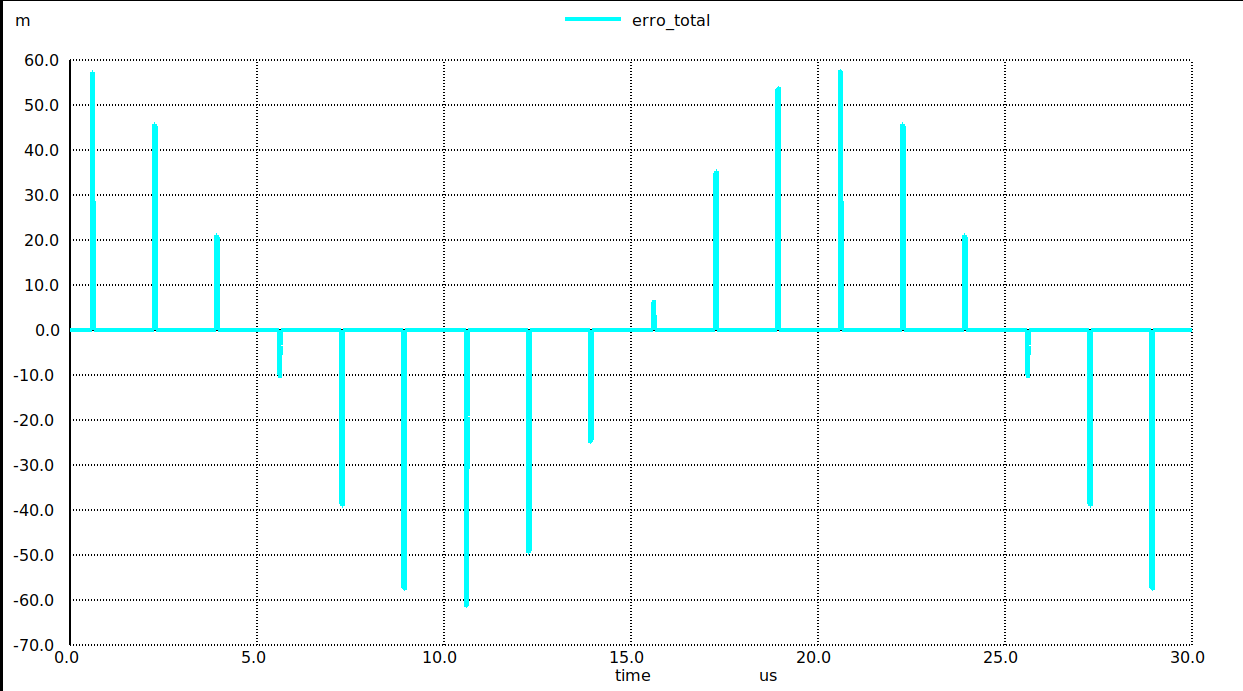
apresentacao/temp/invertido/Erro_total.png
