Pinheirogustavo/Gustavo_TG_biomedica/apresentacao/temp/invertido/Erros_todos.png

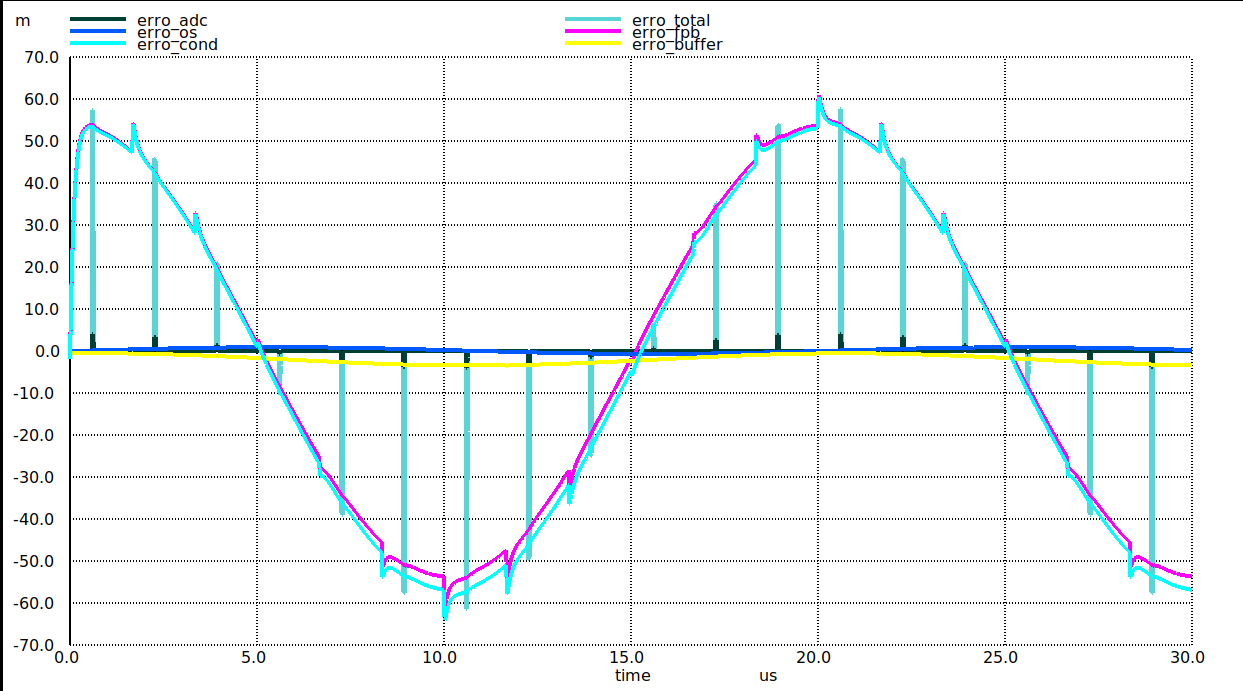
apresentacao/temp/invertido/Erros_todos.png
