Pinheirogustavo/Gustavo_TG_biomedica/Dados/correlacao_FFM_homens.png

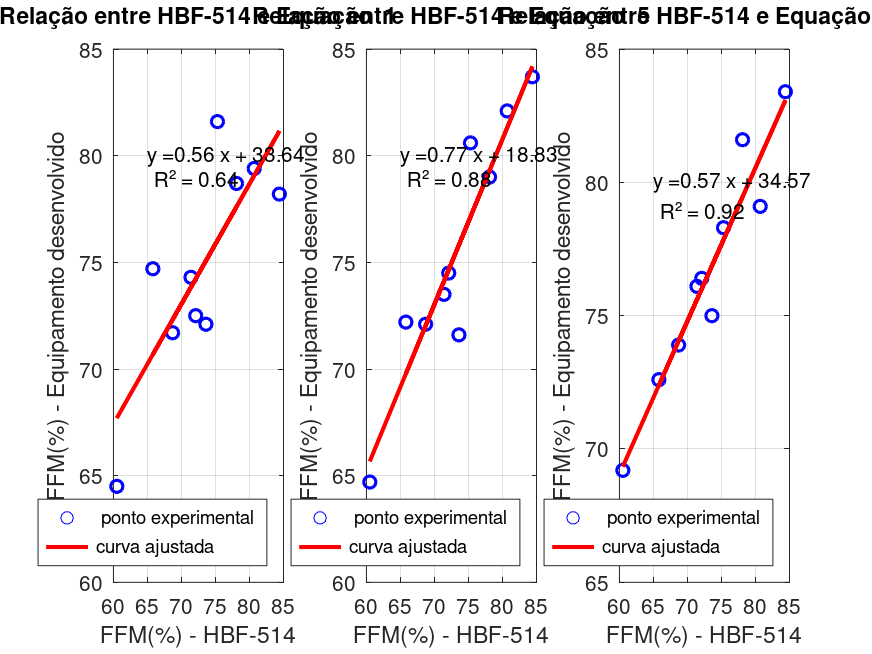
Dados/correlacao_FFM_homens.png
