Pinheirogustavo/Gustavo_TG_biomedica/Dados/correlacao_FFM_mulheres.png

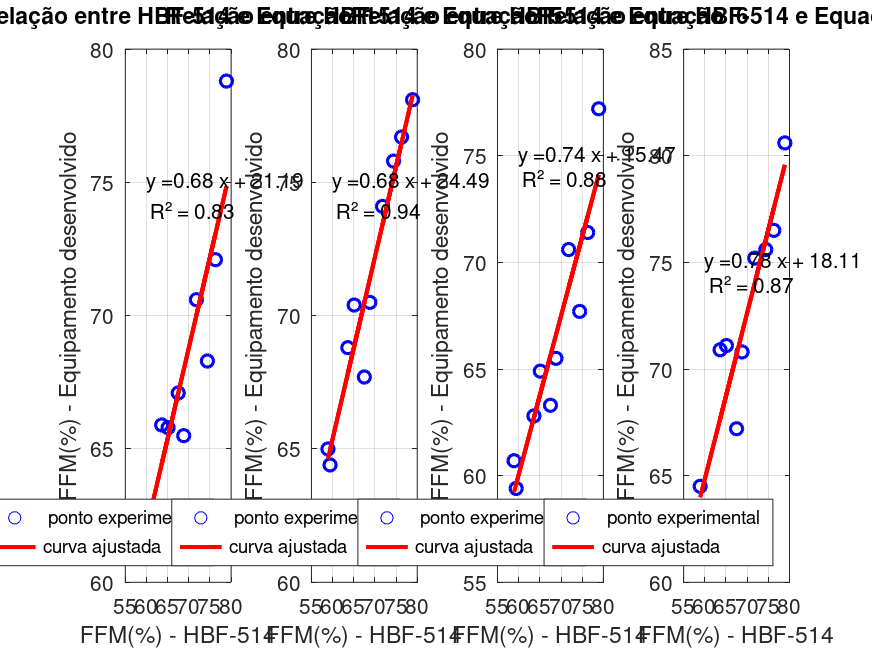
Dados/correlacao_FFM_mulheres.png
