Pinheirogustavo/Gustavo_TG_biomedica/Dados/Zc.png

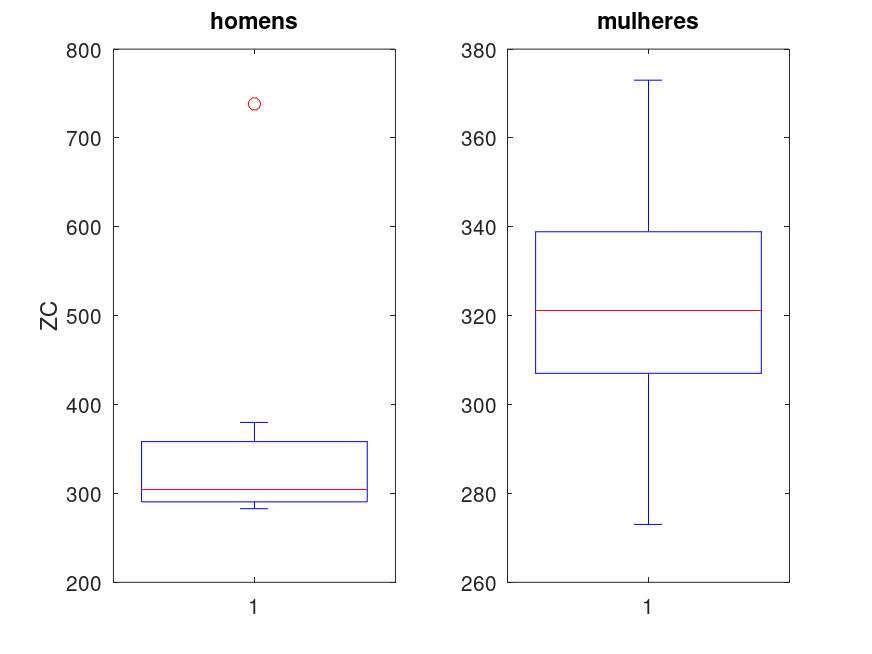
Dados/Zc.png
