Pinheirogustavo/Gustavo_TG_biomedica/hardware/condicionamento/Condicionamento_entrada_unica_741/Simulação/condicionamento_circuito_segmentos.png

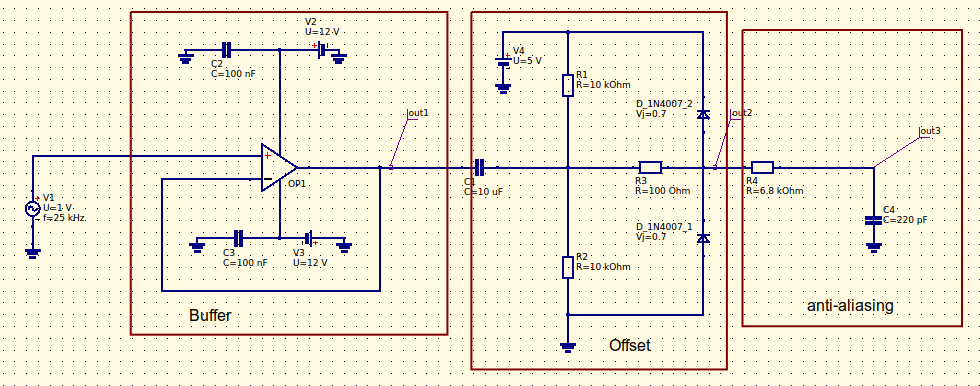
hardware/condicionamento/Condicionamento_entrada_unica_741/Simulação/condicionamento_circuito_segmentos.png
