Pinheirogustavo/Gustavo_TG_biomedica/hardware/condicionamento/Condicionamento_entrada_unica_741/Simulação/condicionamento_resposta_tempo_offset.png

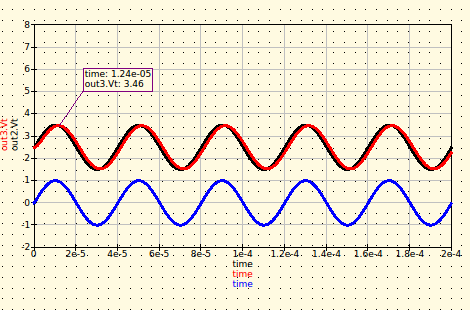
hardware/condicionamento/Condicionamento_entrada_unica_741/Simulação/condicionamento_resposta_tempo_offset.png
