Pinheirogustavo/Gustavo_TG_biomedica/hardware/fonte de corrente monopolar/simulação/circuito_fonte_corrente_circuito.png

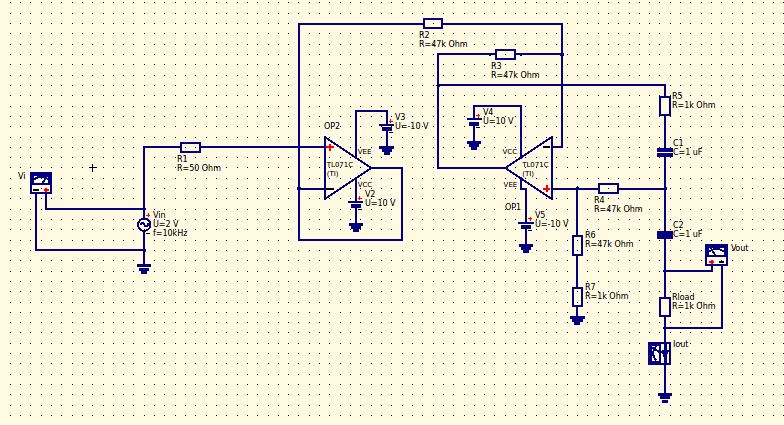
hardware/fonte de corrente monopolar/simulação/circuito_fonte_corrente_circuito.png
