Pinheirogustavo/Gustavo_TG_biomedica/hardware/fonte de corrente monopolar/simulação/fonte_corrente_2_4mA.png

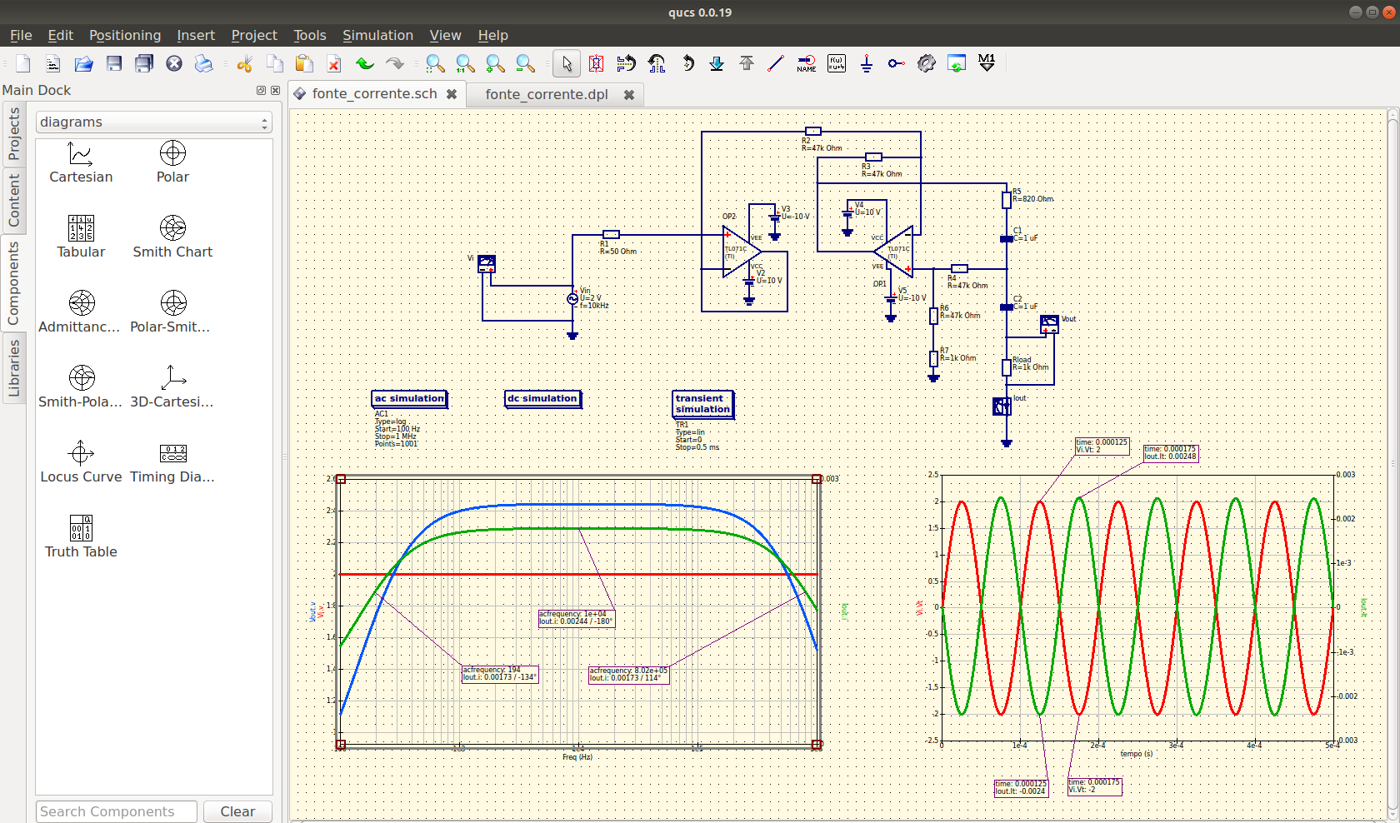
hardware/fonte de corrente monopolar/simulação/fonte_corrente_2_4mA.png
