Pinheirogustavo/Gustavo_TG_biomedica/hardware/fonte de corrente monopolar/simulação/fonte_corrente_resposta_frequencia.png

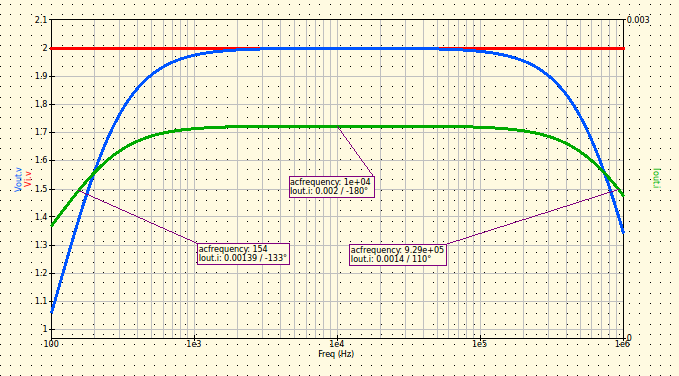
hardware/fonte de corrente monopolar/simulação/fonte_corrente_resposta_frequencia.png
