Pinheirogustavo/Gustavo_TG_biomedica/hardware/fonte de tensão simétrica/Terra_virtual_AmpOp/Simulação/vg.png

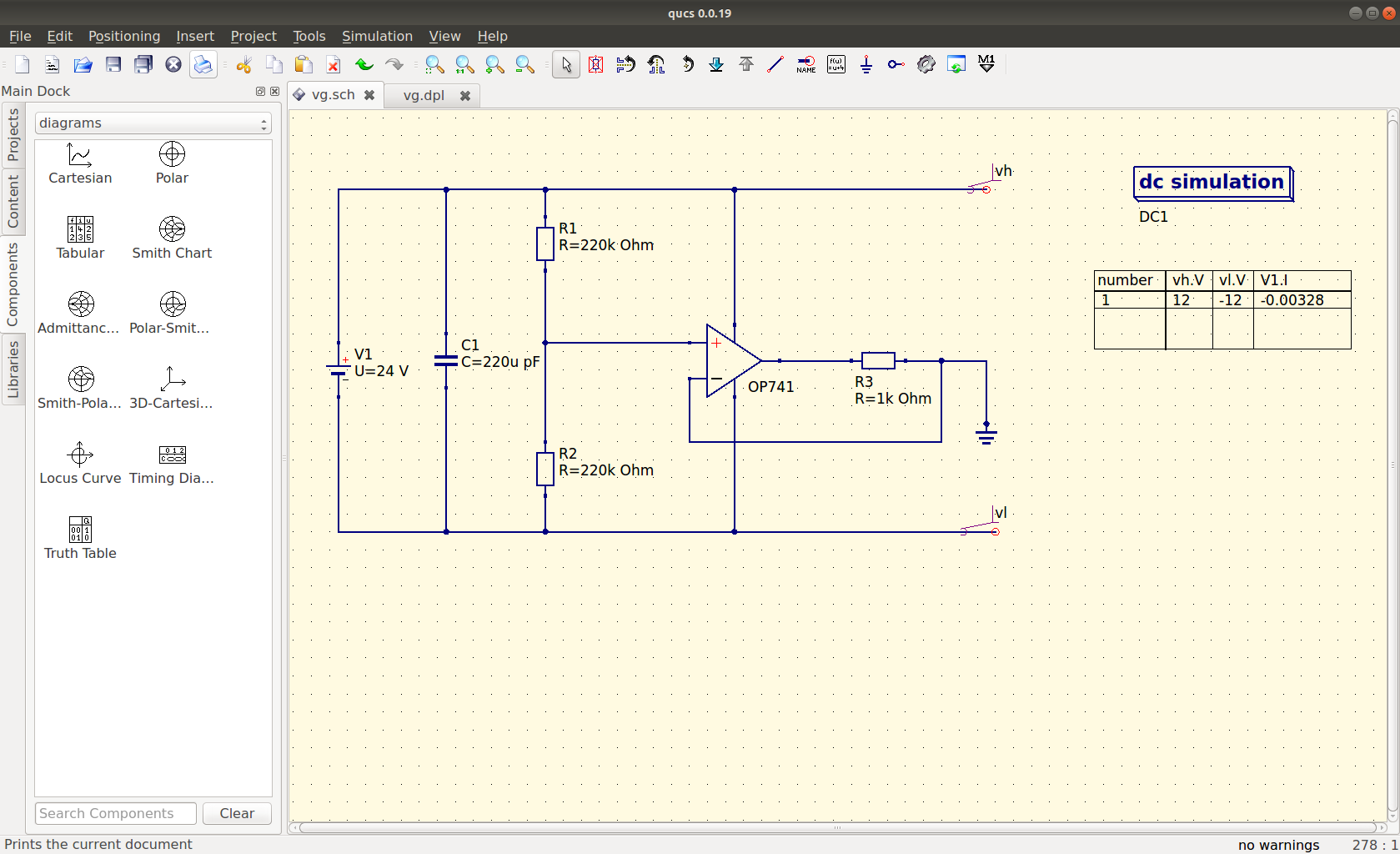
hardware/fonte de tensão simétrica/Terra_virtual_AmpOp/Simulação/vg.png
