Pinheirogustavo/Gustavo_TG_biomedica/hardware/suporte stm32/PCB/print/SMT32_etch_copper_bottom.pdf

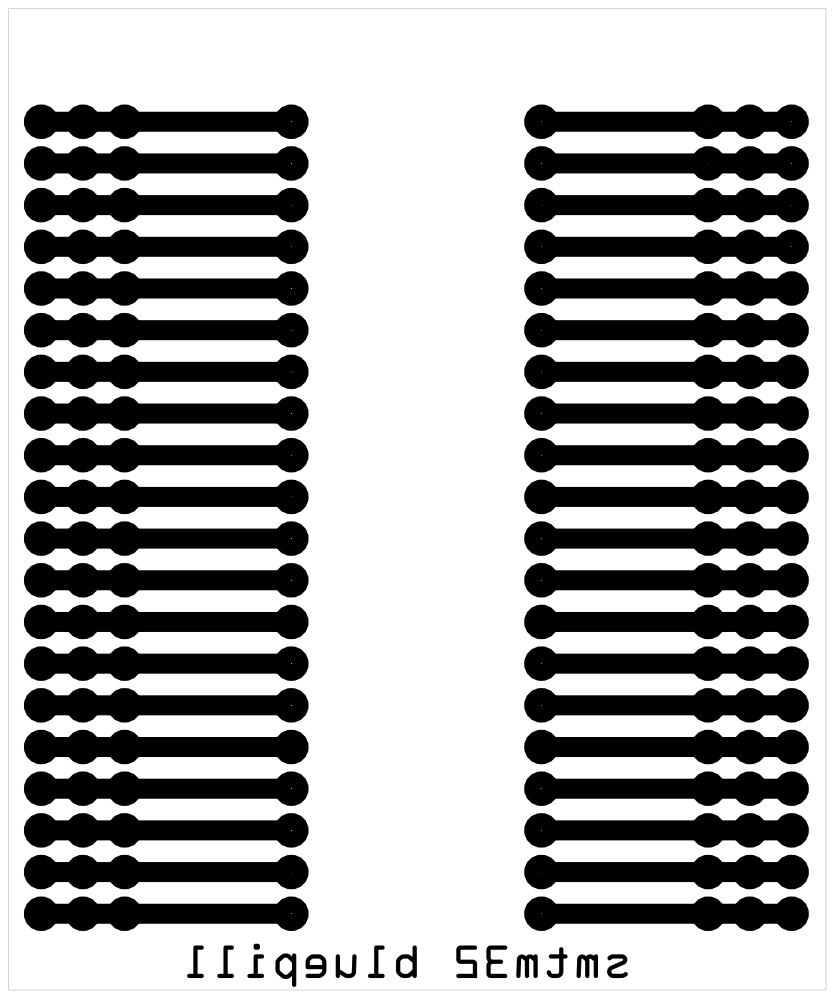
[picture p62: page 1]
