Pinheirogustavo/Gustavo_TG_biomedica/hardware/suporte stm32/PCB/print/SMT32_etch_copper_bottom_mirror.pdf

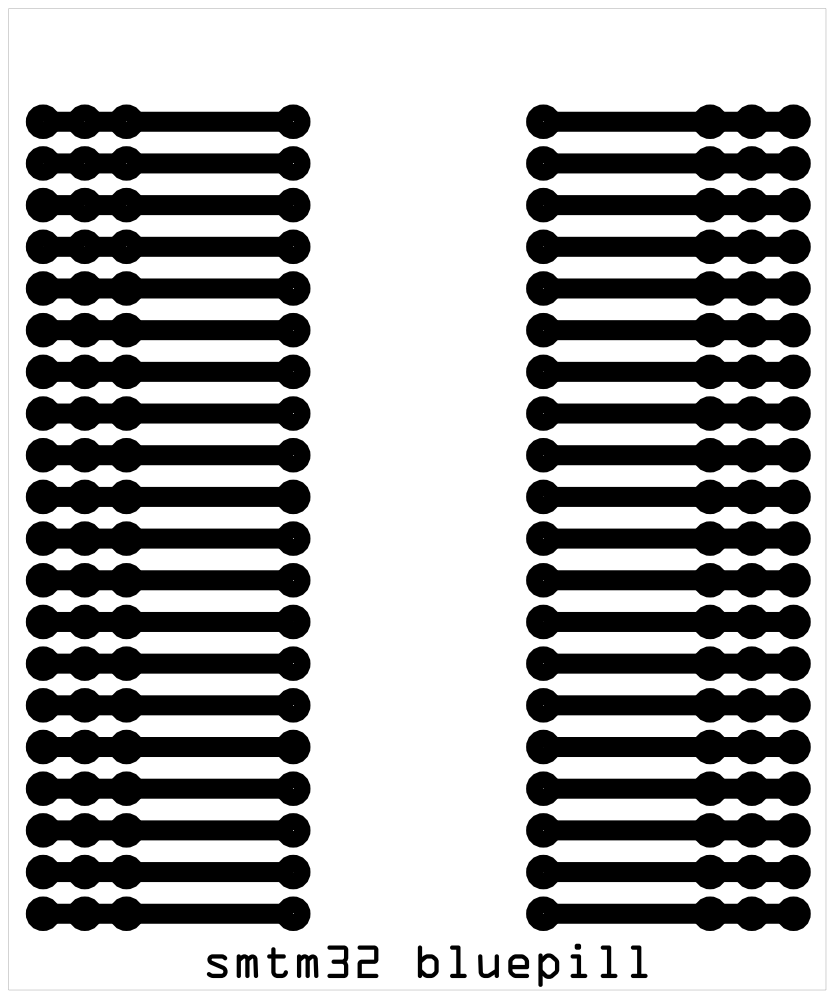
[picture p63: page 1]
