Pinheirogustavo/Gustavo_TG_biomedica/hardware/suporte stm32/PCB/print/SMT32_etch_mask_bottom.pdf

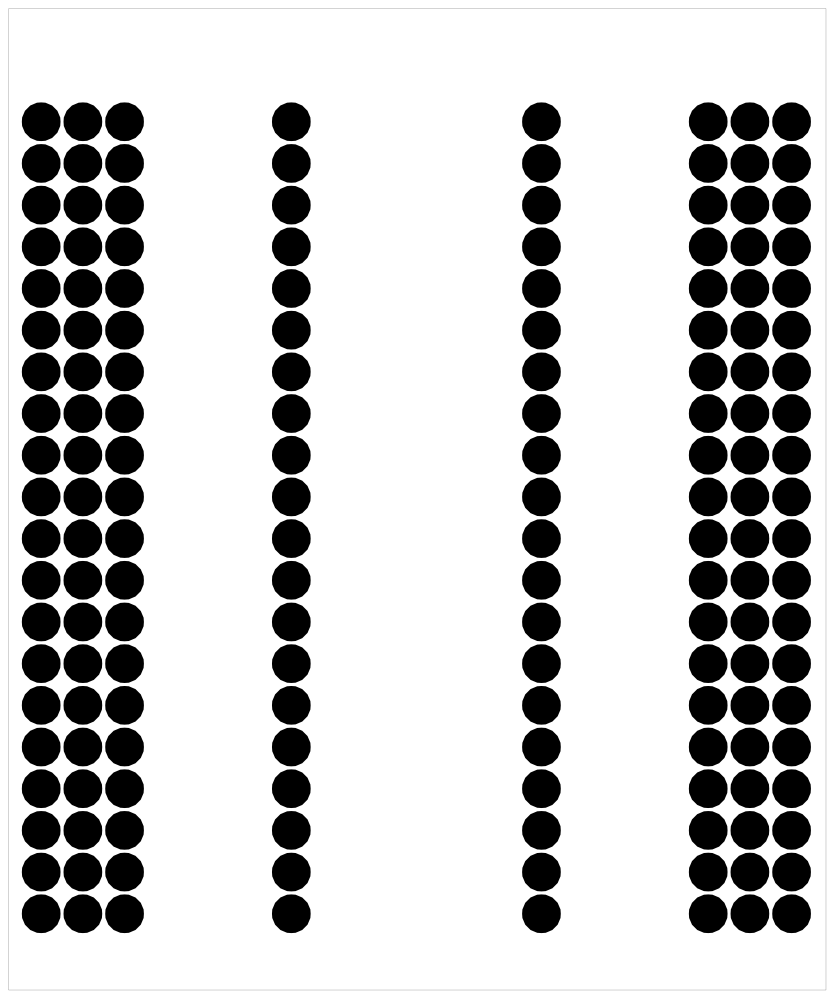
[picture p64: page 1]
