Pinheirogustavo/Gustavo_TG_biomedica/hardware/suporte stm32/PCB/print/SMT32_etch_mask_bottom_mirror.pdf

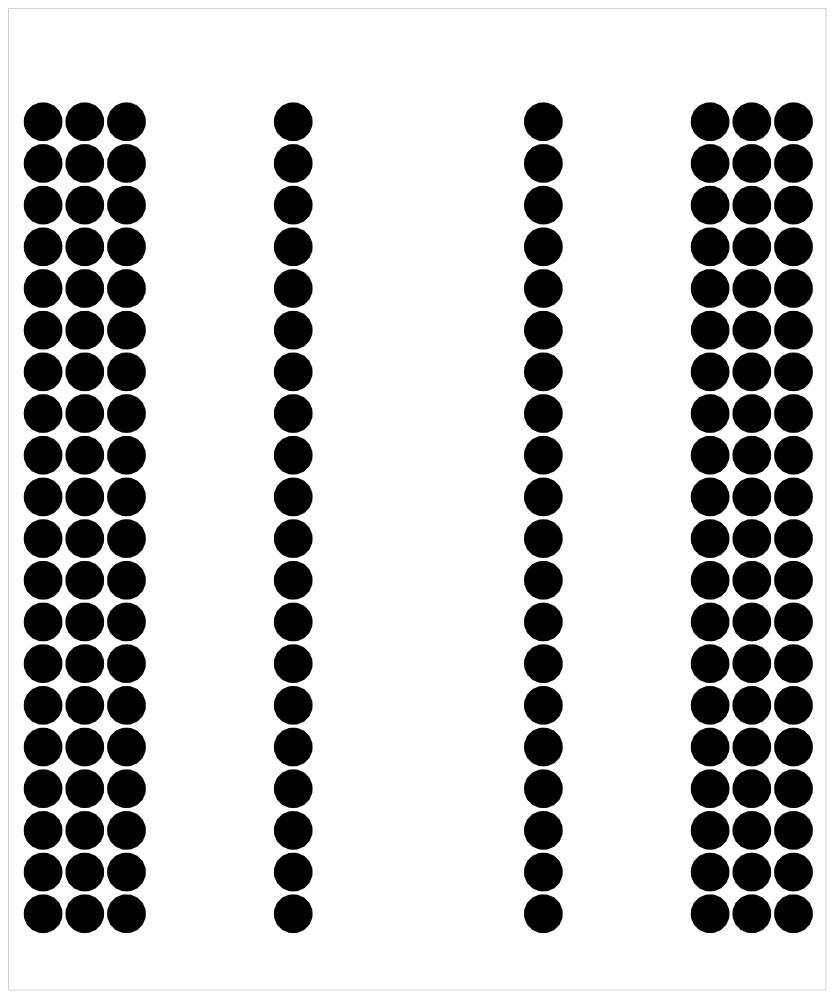
[picture p65: page 1]
