Pinheirogustavo/Gustavo_TG_biomedica/hardware/suporte stm32/PCB/print/SMT32_etch_silk_bottom.pdf

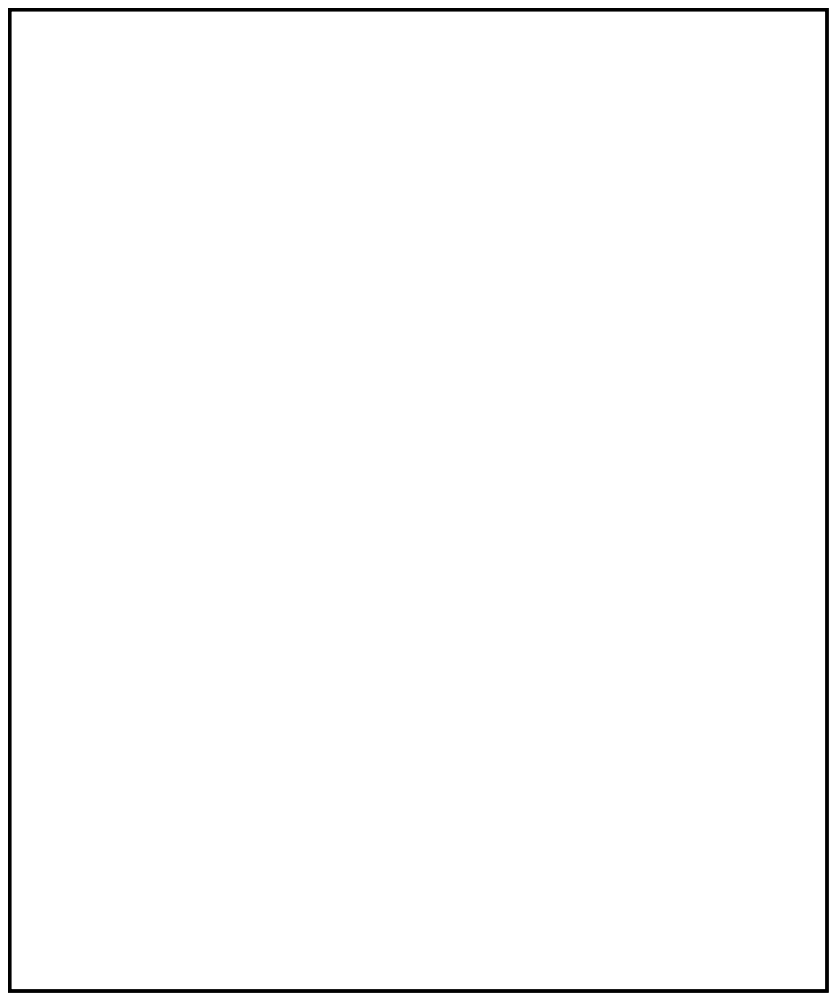
[picture p66: page 1]
