Pinheirogustavo/Gustavo_TG_biomedica/hardware/fonte de tensão simétrica/Terra_virtual_LM_675/PCB/Print_Fonte_tensao_baseado_lm675/tensao_baseado_lm675_etch_copper_bottom_mirror.pdf

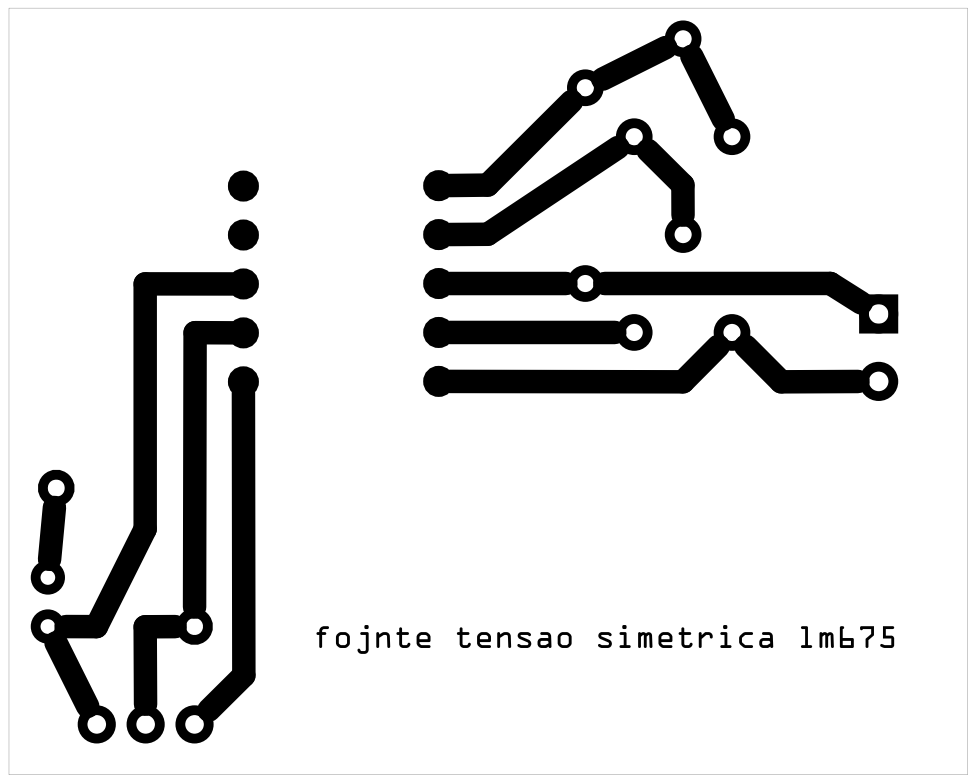
[picture p68: page 1]
