Pinheirogustavo/Gustavo_TG_biomedica/hardware/condicionamento/Condicionamento_entrada_unica_741/PCB/Print_Condicionamento_entrada_unica_741/condicionamento_pcb_etch_mask_bottom_mirror.pdf

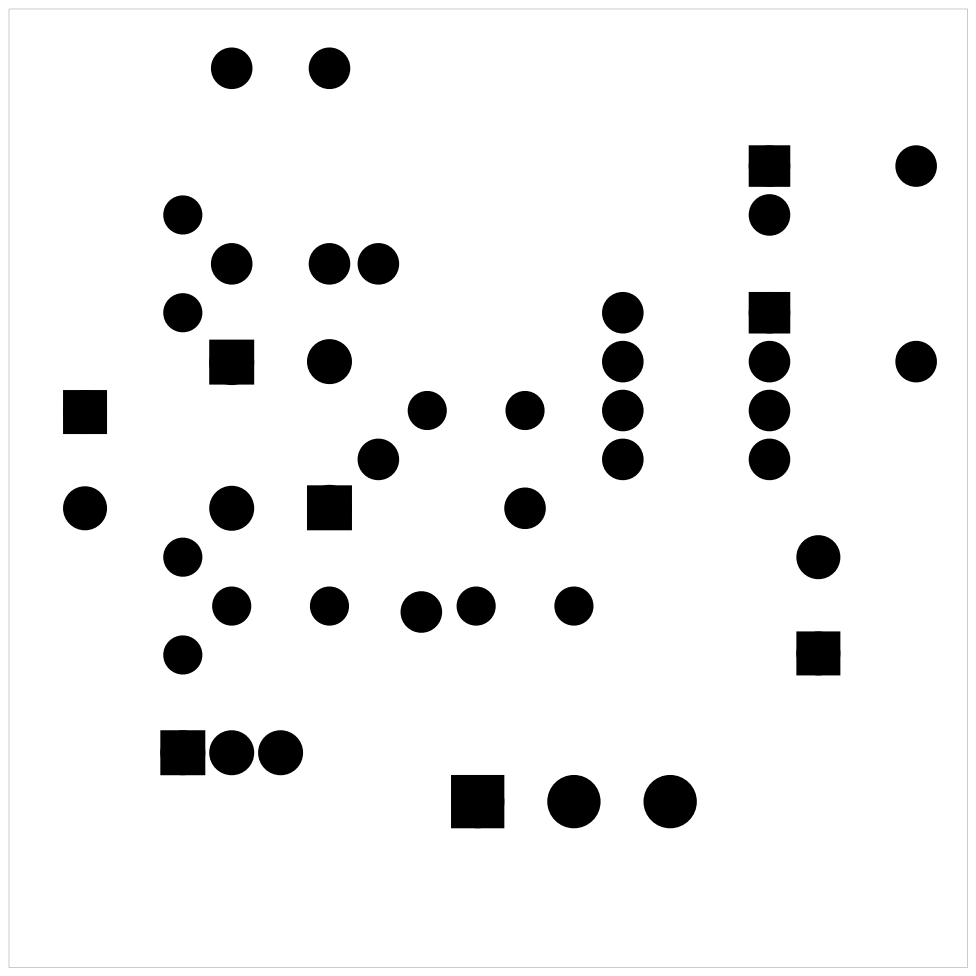
[picture p79: page 1]
