Pinheirogustavo/Gustavo_TG_biomedica/hardware/fonte de corrente monopolar/PCB/Print_fonte_corrente/plano_terra/fonte_corrente (copy)_etch_copper_bottom.pdf

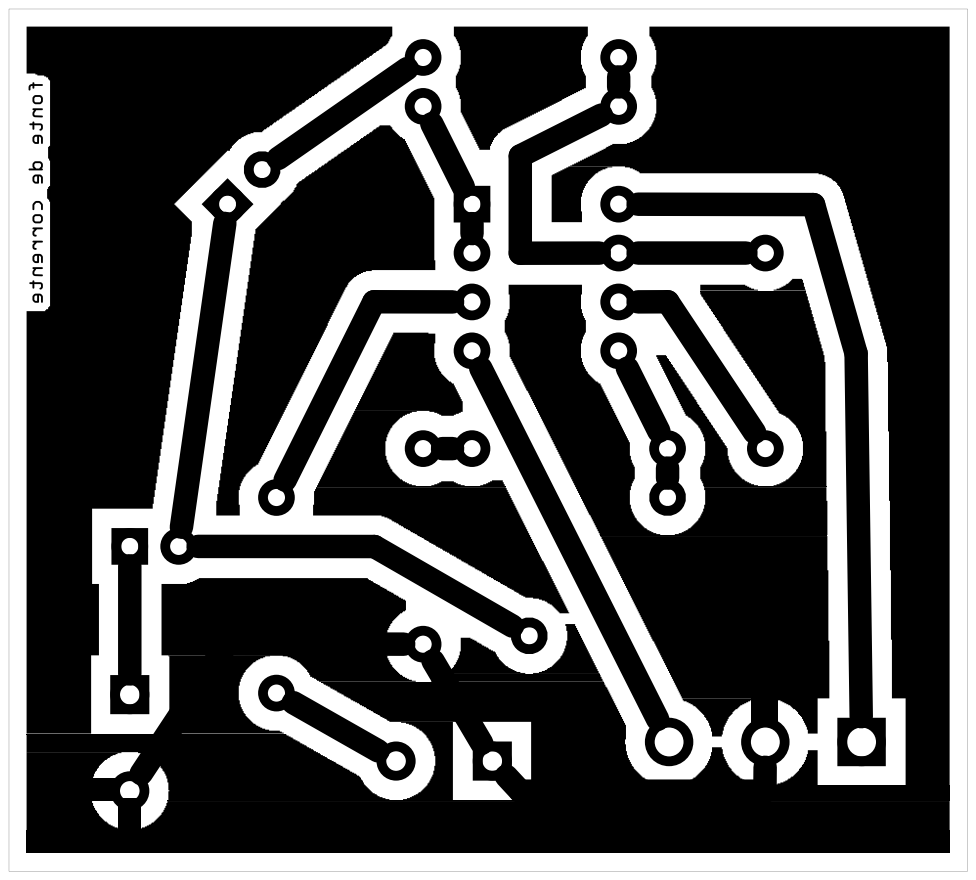
[picture p82: page 1]
