Pinheirogustavo/Gustavo_TG_biomedica/hardware/fonte de corrente monopolar/PCB/Print_fonte_corrente/plano_terra/fonte_corrente (copy)_etch_mask_bottom_mirror.pdf

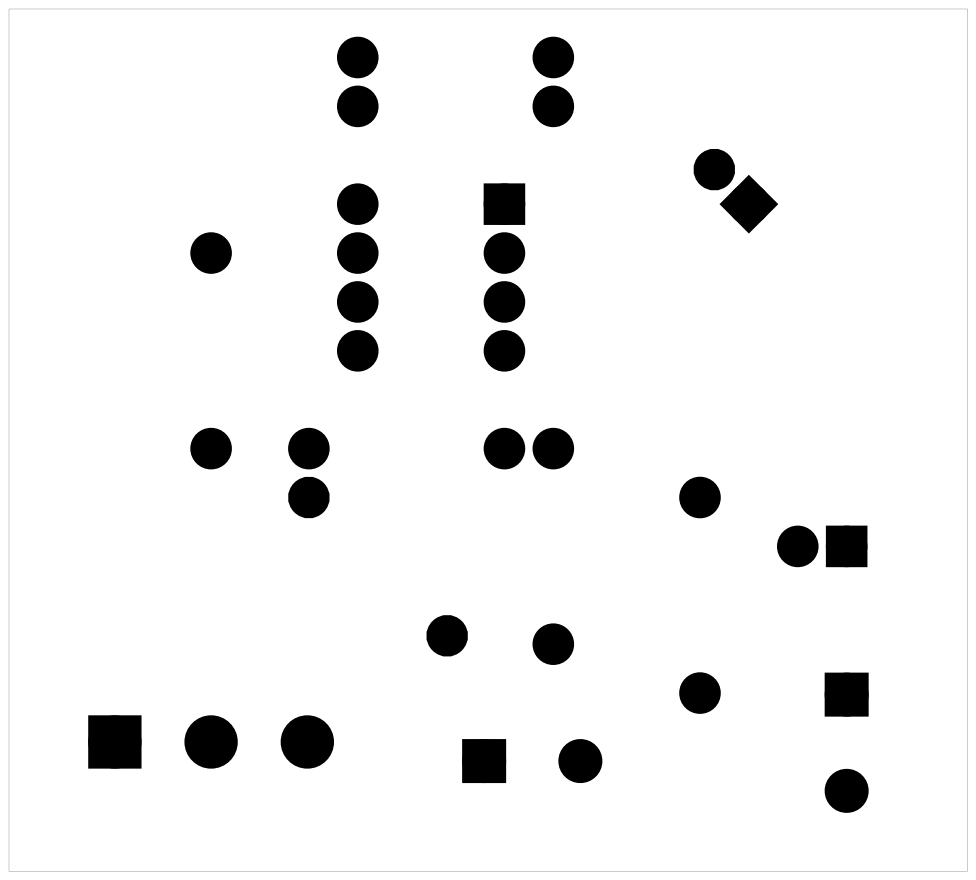
[picture p85: page 1]
