Pinheirogustavo/Gustavo_TG_biomedica/hardware/fonte de corrente monopolar/PCB/Print_fonte_corrente/plano_terra/fonte_corrente (copy)_etch_silk_bottom.pdf

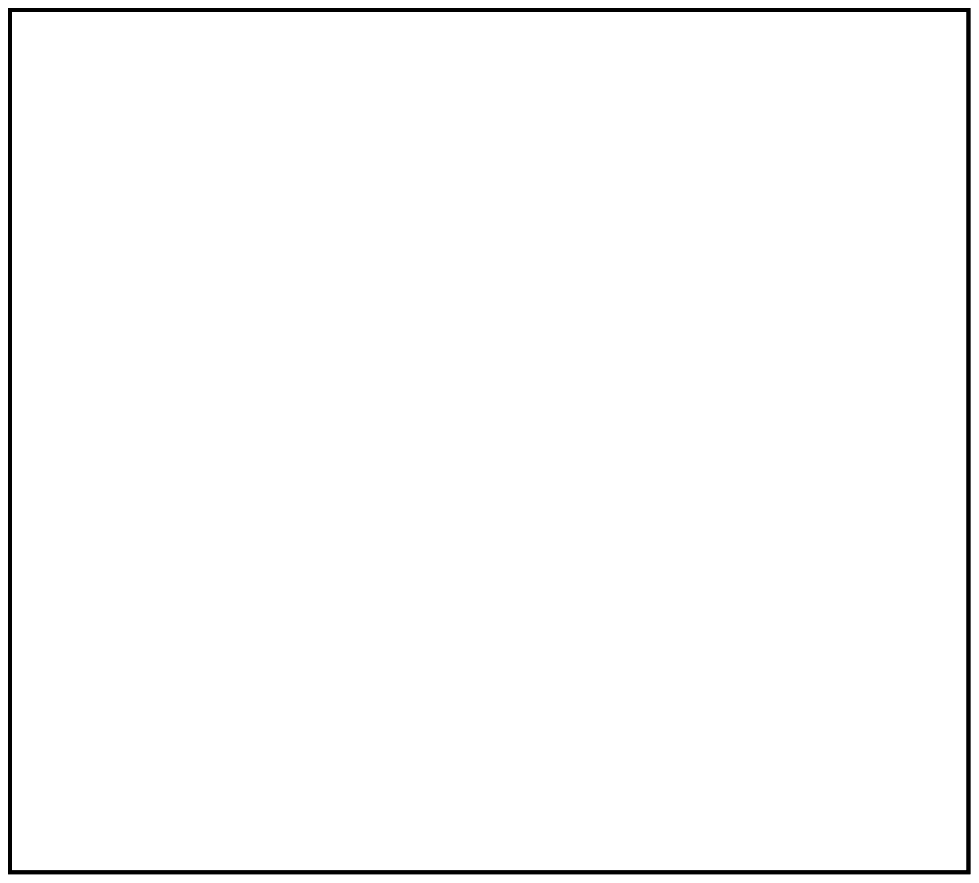
[picture p86: page 1]
