Pinheirogustavo/Gustavo_TG_biomedica/hardware/fonte de corrente monopolar/PCB/Print_fonte_corrente/trilha/fonte_corrente (copy)_etch_copper_bottom.pdf

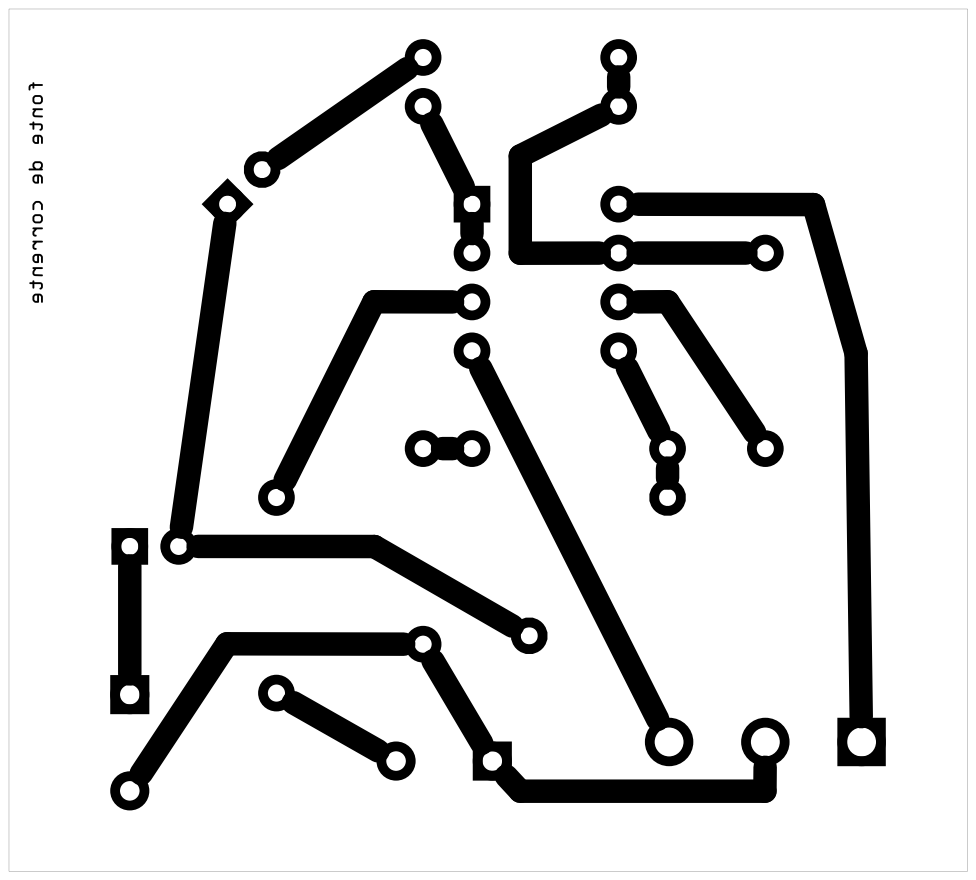
[picture p88: page 1]
