Pinheirogustavo/Gustavo_TG_biomedica/hardware/fonte de corrente monopolar/PCB/Print_fonte_corrente/trilha/fonte_corrente (copy)_etch_copper_bottom_mirror.pdf

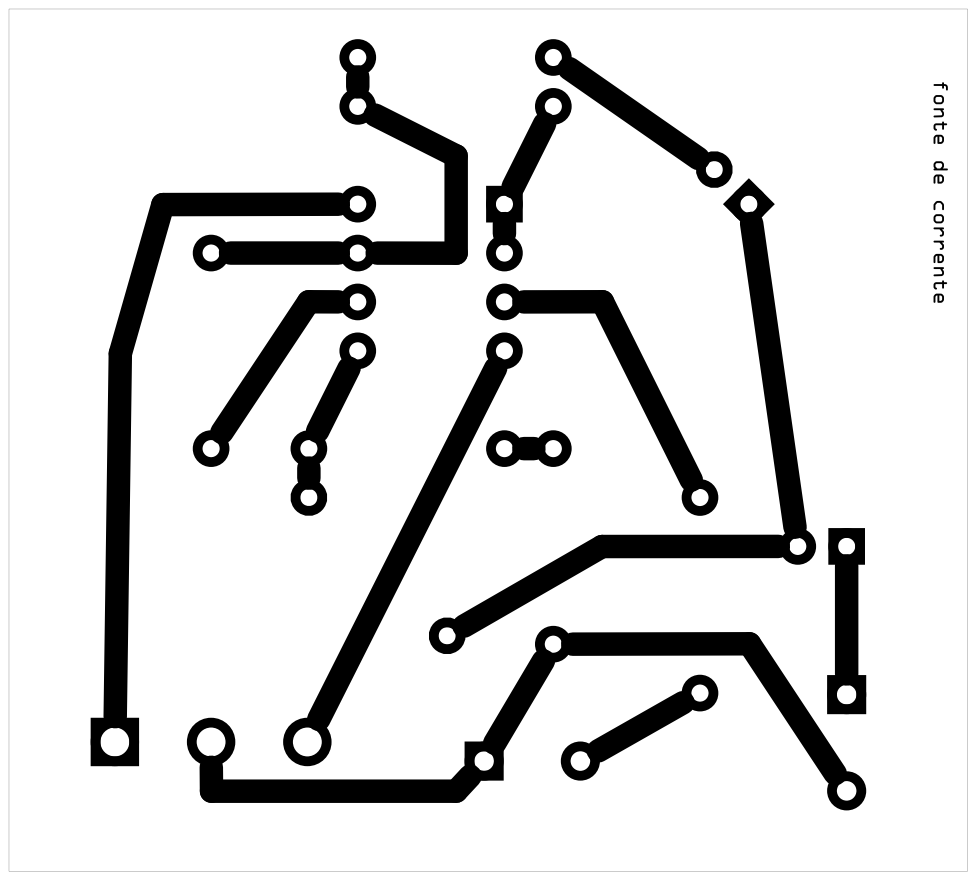
[picture p89: page 1]
