Pinheirogustavo/Gustavo_TG_biomedica/hardware/condicionamento/Condicionamento_entrada_dupla_AD826/PCB/Print_Condicionamento_entrada_dupla_AD826/pdf/condicionamento_pcb_baseado_ad826_etch_mask_bottom.pdf

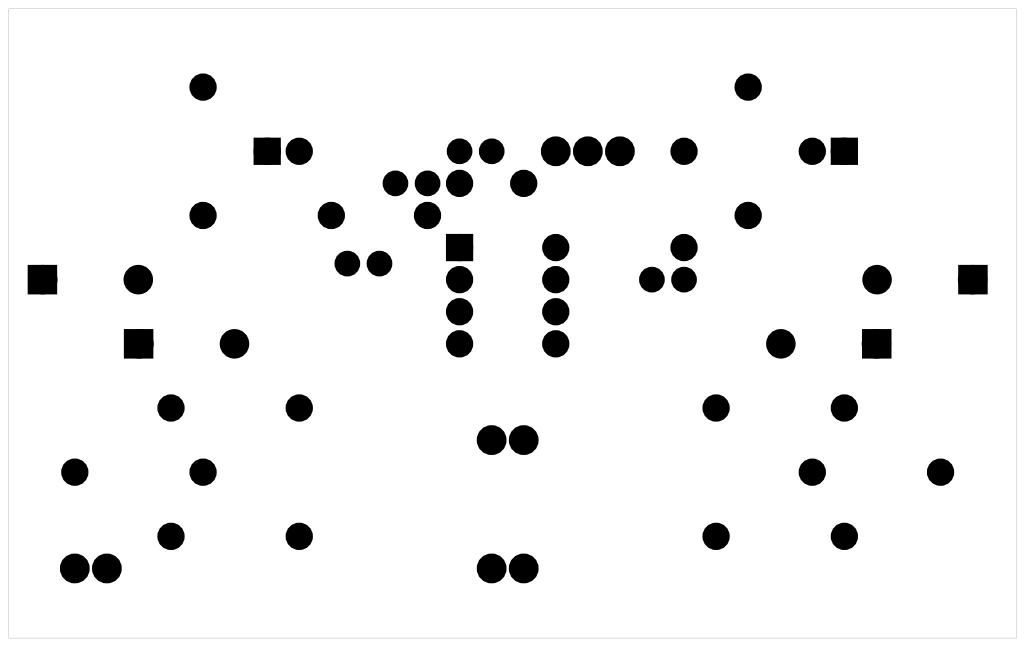
[picture p94: page 1]
