Pinheirogustavo/Gustavo_TG_biomedica/hardware/fonte de tensão simétrica/Terra_virtual_AmpOp/PCB/Print_fonte_tensao_741/ground/fonte_tensão (copy)_etch_copper_bottom.pdf

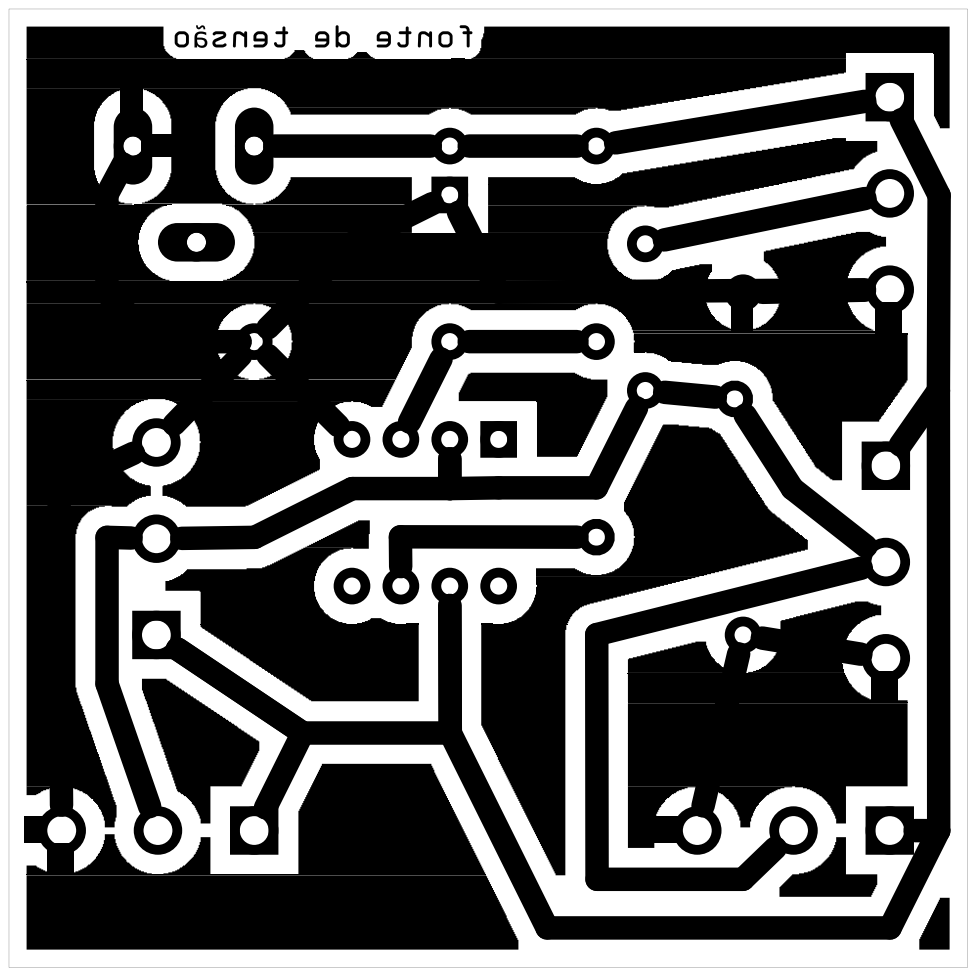
[picture p100: page 1]
