Pinheirogustavo/Gustavo_TG_biomedica/hardware/fonte de tensão simétrica/Terra_virtual_AmpOp/PCB/Print_fonte_tensao_741/ground/fonte_tensão (copy)_etch_copper_bottom_mirror.pdf

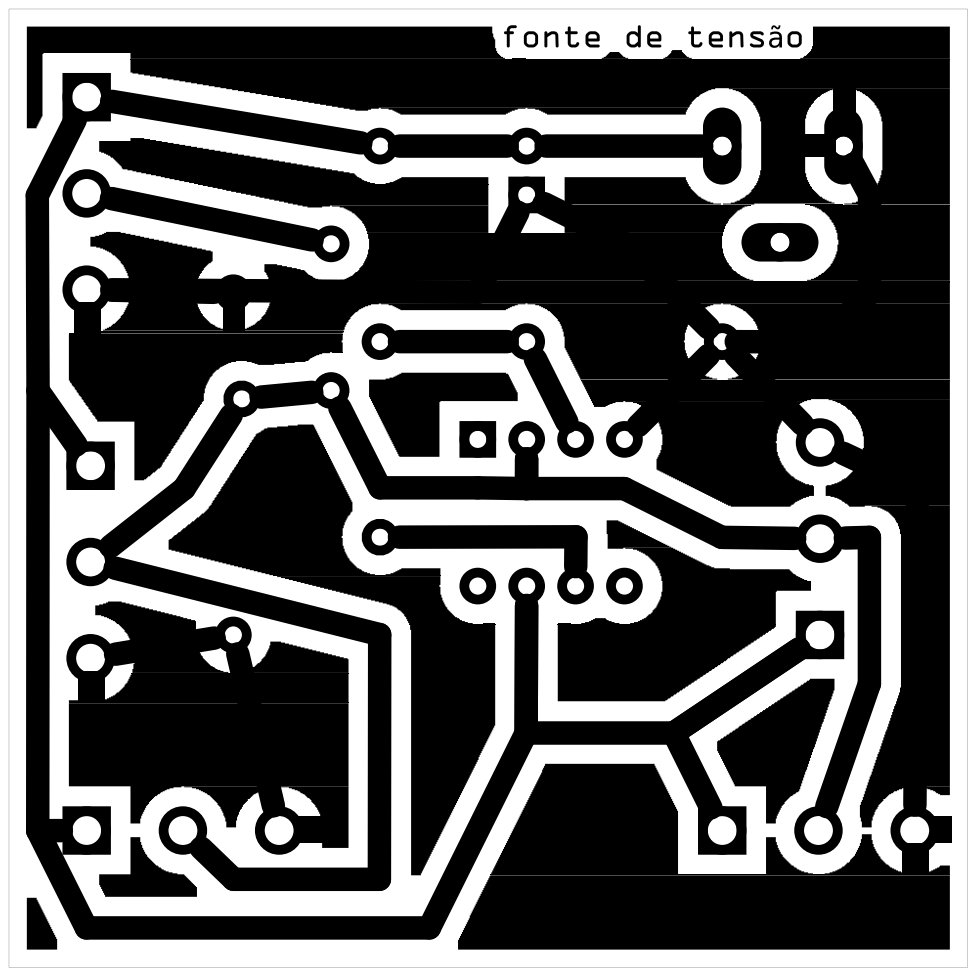
[picture p101: page 1]
