Pinheirogustavo/Gustavo_TG_biomedica/(list of files, drawings)

Other design files:
hardware/condicionamento/Condicionamento_entrada_dupla_AD826/PCB/Condicionamento_entrada_dupla_AD826.fzz
hardware/condicionamento/Condicionamento_entrada_unica_741/PCB/Condicionamento_entrada_unica_741.fzz
hardware/fonte de corrente monopolar/PCB/fonte_corrente.fzz
hardware/fonte de tensão simétrica/Suporte_para_diversas_saidas/PCB/Suporte_para_diversas_saidas.fzz
hardware/fonte de tensão simétrica/Suporte_para_diversas_saidas/PCB/Suporte_para_diversas_saidas_compacto.fzz
hardware/fonte de tensão simétrica/Terra_virtual_AmpOp/PCB/fonte_tensao_741.fzz
hardware/fonte de tensão simétrica/Terra_virtual_LM_675/PCB/Fonte_tensao_baseado_lm675.fzz
hardware/gerador de sinais baseado em ad9833/Gerador_AD9833_ganho_trimpot/PCB/Gerador_AD9833_ganho_trimpot.fzz
hardware/gerador de sinais baseado em ad9833/Gerador_ad9833_sem_ganho/PCB/gerador_ad9833_sem_ganho.fzz
hardware/resistor sentinela/PCB/resistor_sentinela.fzz
hardware/suporte stm32/PCB/SMT32.fzz
old/hardware/condicionamento/Condicionamento_entrada_dupla_AD826/PCB/Condicionamento_entrada_dupla_AD826.fzz
old/hardware/condicionamento/Condicionamento_entrada_unica_741/PCB/Condicionamento_entrada_unica_741.fzz
old/hardware/fonte de corrente monopolar/PCB/fonte_corrente.fzz
old/hardware/fonte de tensão simétrica/Suporte_para_diversas_saidas/PCB/Suporte_para_diversas_saidas.fzz
old/hardware/fonte de tensão simétrica/Suporte_para_diversas_saidas/PCB/Suporte_para_diversas_saidas_compacto.fzz
old/hardware/fonte de tensão simétrica/Terra_virtual_AmpOp/PCB/fonte_tensao_741.fzz
old/hardware/fonte de tensão simétrica/Terra_virtual_LM_675/PCB/Fonte_tensao_baseado_lm675.fzz
old/hardware/gerador de sinais baseado em ad9833/Gerador_AD9833_ganho_trimpot/PCB/Gerador_AD9833_ganho_trimpot.fzz
old/hardware/gerador de sinais baseado em ad9833/Gerador_ad9833_sem_ganho/PCB/gerador_ad9833_sem_ganho.fzz
old/hardware/resistor sentinela/PCB/resistor_sentinela.fzz
old/hardware/suporte stm32/PCB/SMT32.fzz
