Pinheirogustavo/Gustavo_TG_biomedica/Projetos das placas de circuito impresso/Kicad/Barramento/V02/Barramento_EITduino_V02.kicad_pcb

## KiCad design Projetos das placas de circuito impresso/Kicad/Barramento/V02/Barramento_EITduino_V02.kicad_pcb (2023-11-22, an earlier design)

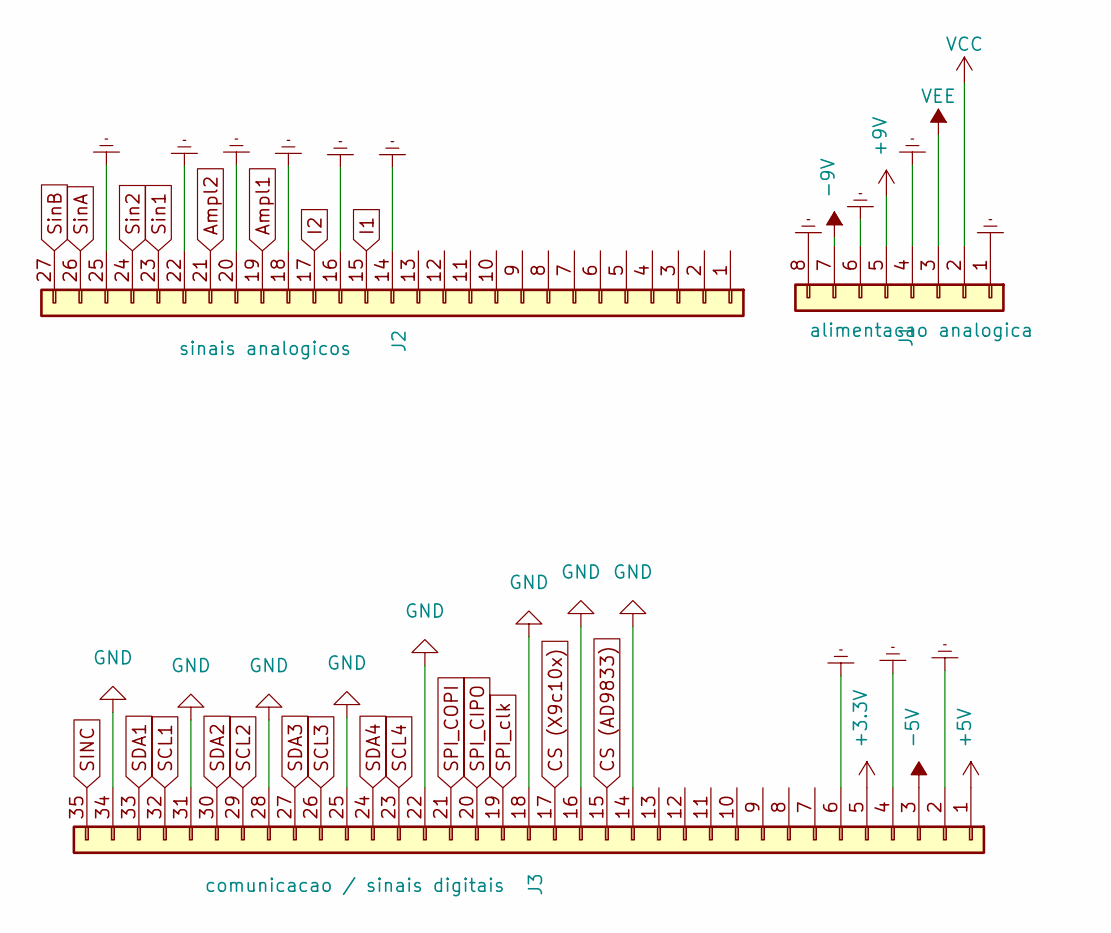
[picture p103: schematic Barramento_EITduino_V02.kicad_sch, Fonte de tensao LM675]

Parts:
J1: alimentacao analogica; PinHeader_1x08_P2.54mm_Vertical
J2: sinais analogicos; PinHeader_1x27_P2.54mm_Vertical
J3: comunicacao / sinais digitais; PinHeader_1x35_P2.54mm_Vertical

Connections:
+3.3V: J3.5
+5V: J3.1
+9V: J1.5
-5V: J3.3
-9V: J1.7
Ampl1: J2.19
Ampl2: J2.21
CS (AD9833): J3.15
CS (X9c10x): J3.17
Earth: J1.1, J1.4, J1.6, J1.8, J2.14, J2.16, J2.18, J2.20, J2.22, J2.25, J3.2, J3.4, J3.6
GND: J3.14, J3.16, J3.18, J3.22, J3.25, J3.28, J3.31, J3.34
I1: J2.15
I2: J2.17
SCL1: J3.32
SCL2: J3.29
SCL3: J3.26
SCL4: J3.23
SDA1: J3.33
SDA2: J3.30
SDA3: J3.27
SDA4: J3.24
SINC: J3.35
SPI_CIPO: J3.20
SPI_COPI: J3.21
SPI_clk: J3.19
Sin1: J2.23
Sin2: J2.24
SinA: J2.26
SinB: J2.27
VCC: J1.2
VEE: J1.3

Board: 2 copper layers, 3 parts (0 on the bottom side), 2 nets, no tracks yet.
