Pinheirogustavo/Gustavo_TG_biomedica/Projetos das placas de circuito impresso/Kicad/Barramento/V03/Barramento_EITduino_V03.kicad_pcb

## KiCad design Projetos das placas de circuito impresso/Kicad/Barramento/V03/Barramento_EITduino_V03.kicad_pcb (2023-11-22)

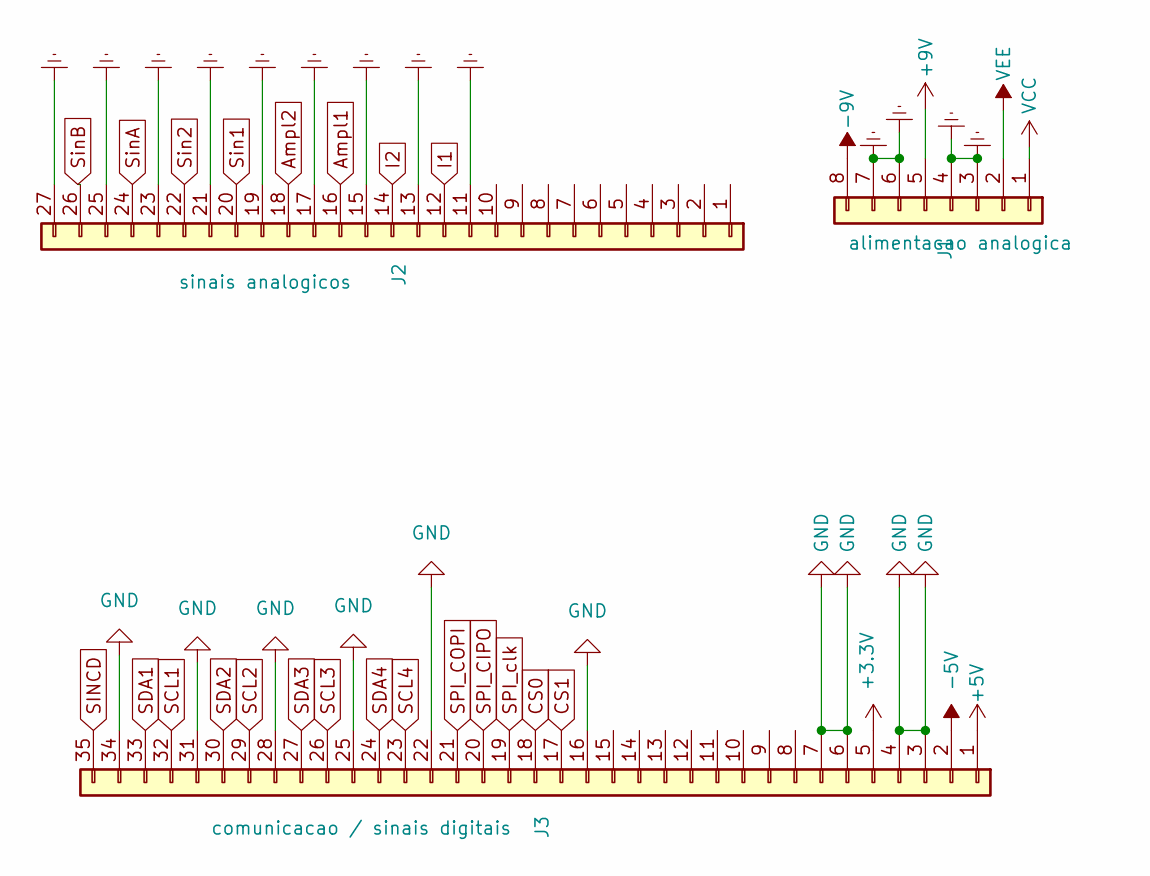
[picture p104: schematic Barramento_EITduino_V03.kicad_sch, Fonte de tensao LM675]

Parts:
J1: alimentacao analogica; PinHeader_1x08_P2.54mm_Vertical
J2: sinais analogicos; PinHeader_1x27_P2.54mm_Vertical
J3: comunicacao / sinais digitais; PinHeader_1x35_P2.54mm_Vertical

Connections:
+3.3V: J3.5
+5V: J3.1
+9V: J1.5
-5V: J3.2
-9V: J1.8
Ampl1: J2.16
Ampl2: J2.18
CS0: J3.18
CS1: J3.17
Earth: J1.3, J1.4, J1.6, J1.7, J2.11, J2.13, J2.15, J2.17, J2.19, J2.21, J2.23, J2.25, J2.27
GND: J3.3, J3.4, J3.6, J3.7, J3.16, J3.22, J3.25, J3.28, J3.31, J3.34
I1: J2.12
I2: J2.14
SCL1: J3.32
SCL2: J3.29
SCL3: J3.26
SCL4: J3.23
SDA1: J3.33
SDA2: J3.30
SDA3: J3.27
SDA4: J3.24
SINCD: J3.35
SPI_CIPO: J3.20
SPI_COPI: J3.21
SPI_clk: J3.19
Sin1: J2.20
Sin2: J2.22
SinA: J2.24
SinB: J2.26
VCC: J1.1
VEE: J1.2

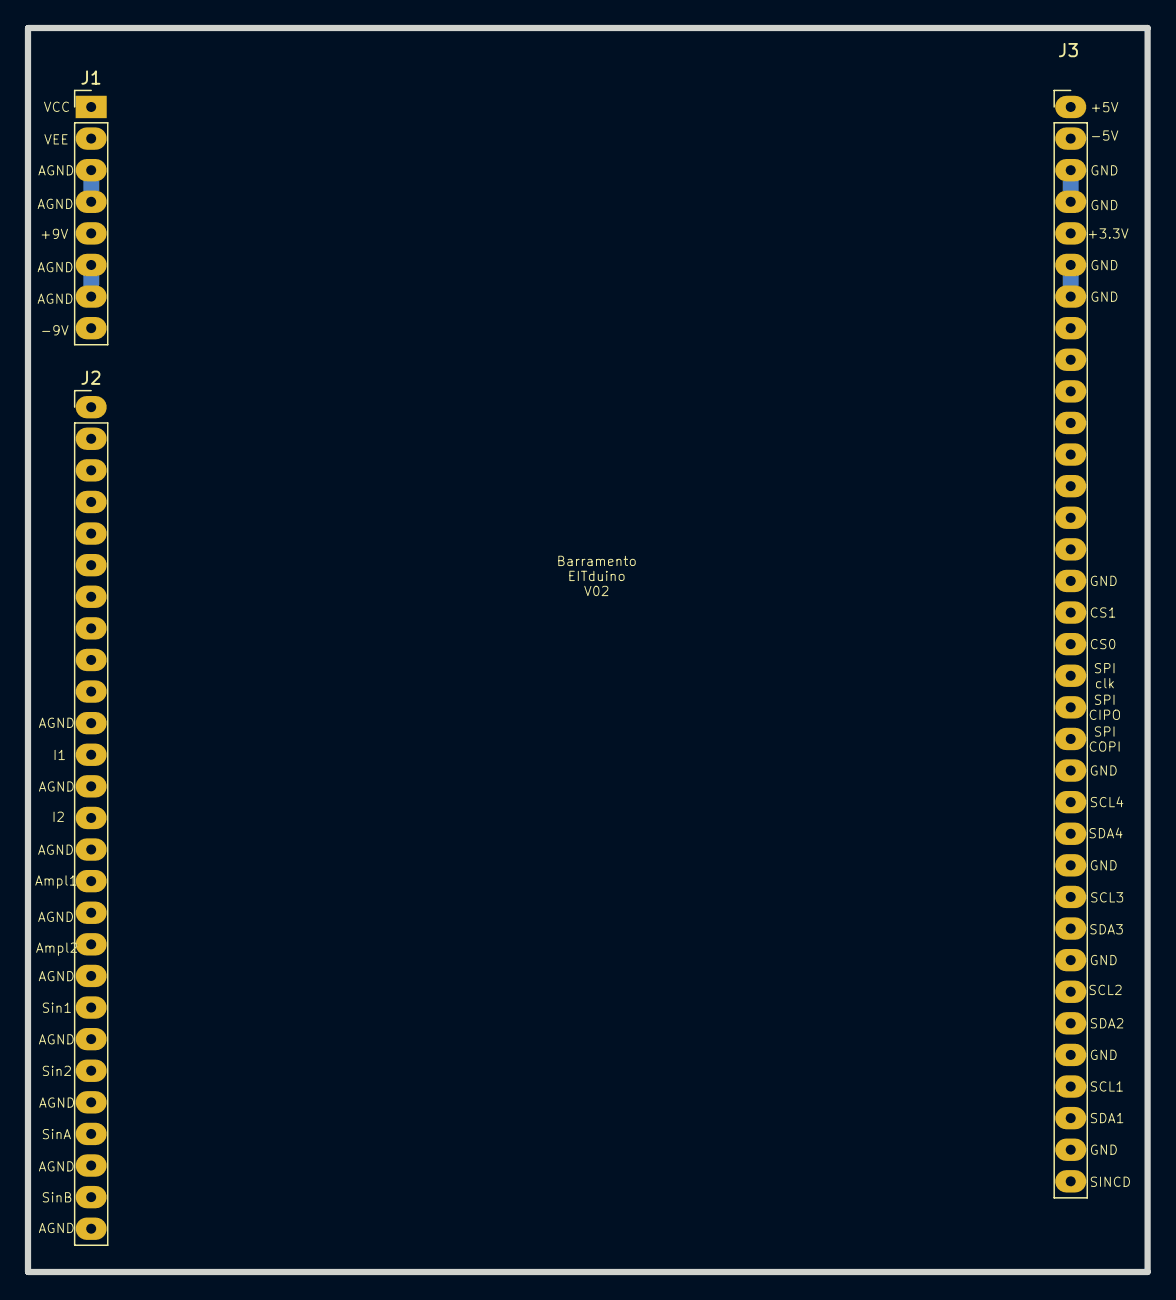
[picture p105: board Barramento_EITduino_V03.kicad_pcb from above]

Board: 2 copper layers, 90.0 x 100.0 mm, 3 parts (0 on the bottom side), 2 nets.
