Pinheirogustavo/Gustavo_TG_biomedica/Projetos das placas de circuito impresso/Kicad/Condicionamento de sinais e integração dos microcontroladores/condicionamento_BIA_v01.kicad_pcb

## KiCad design Projetos das placas de circuito impresso/Kicad/Condicionamento de sinais e integração dos microcontroladores/condicionamento_BIA_v01.kicad_pcb (2023-11-22)

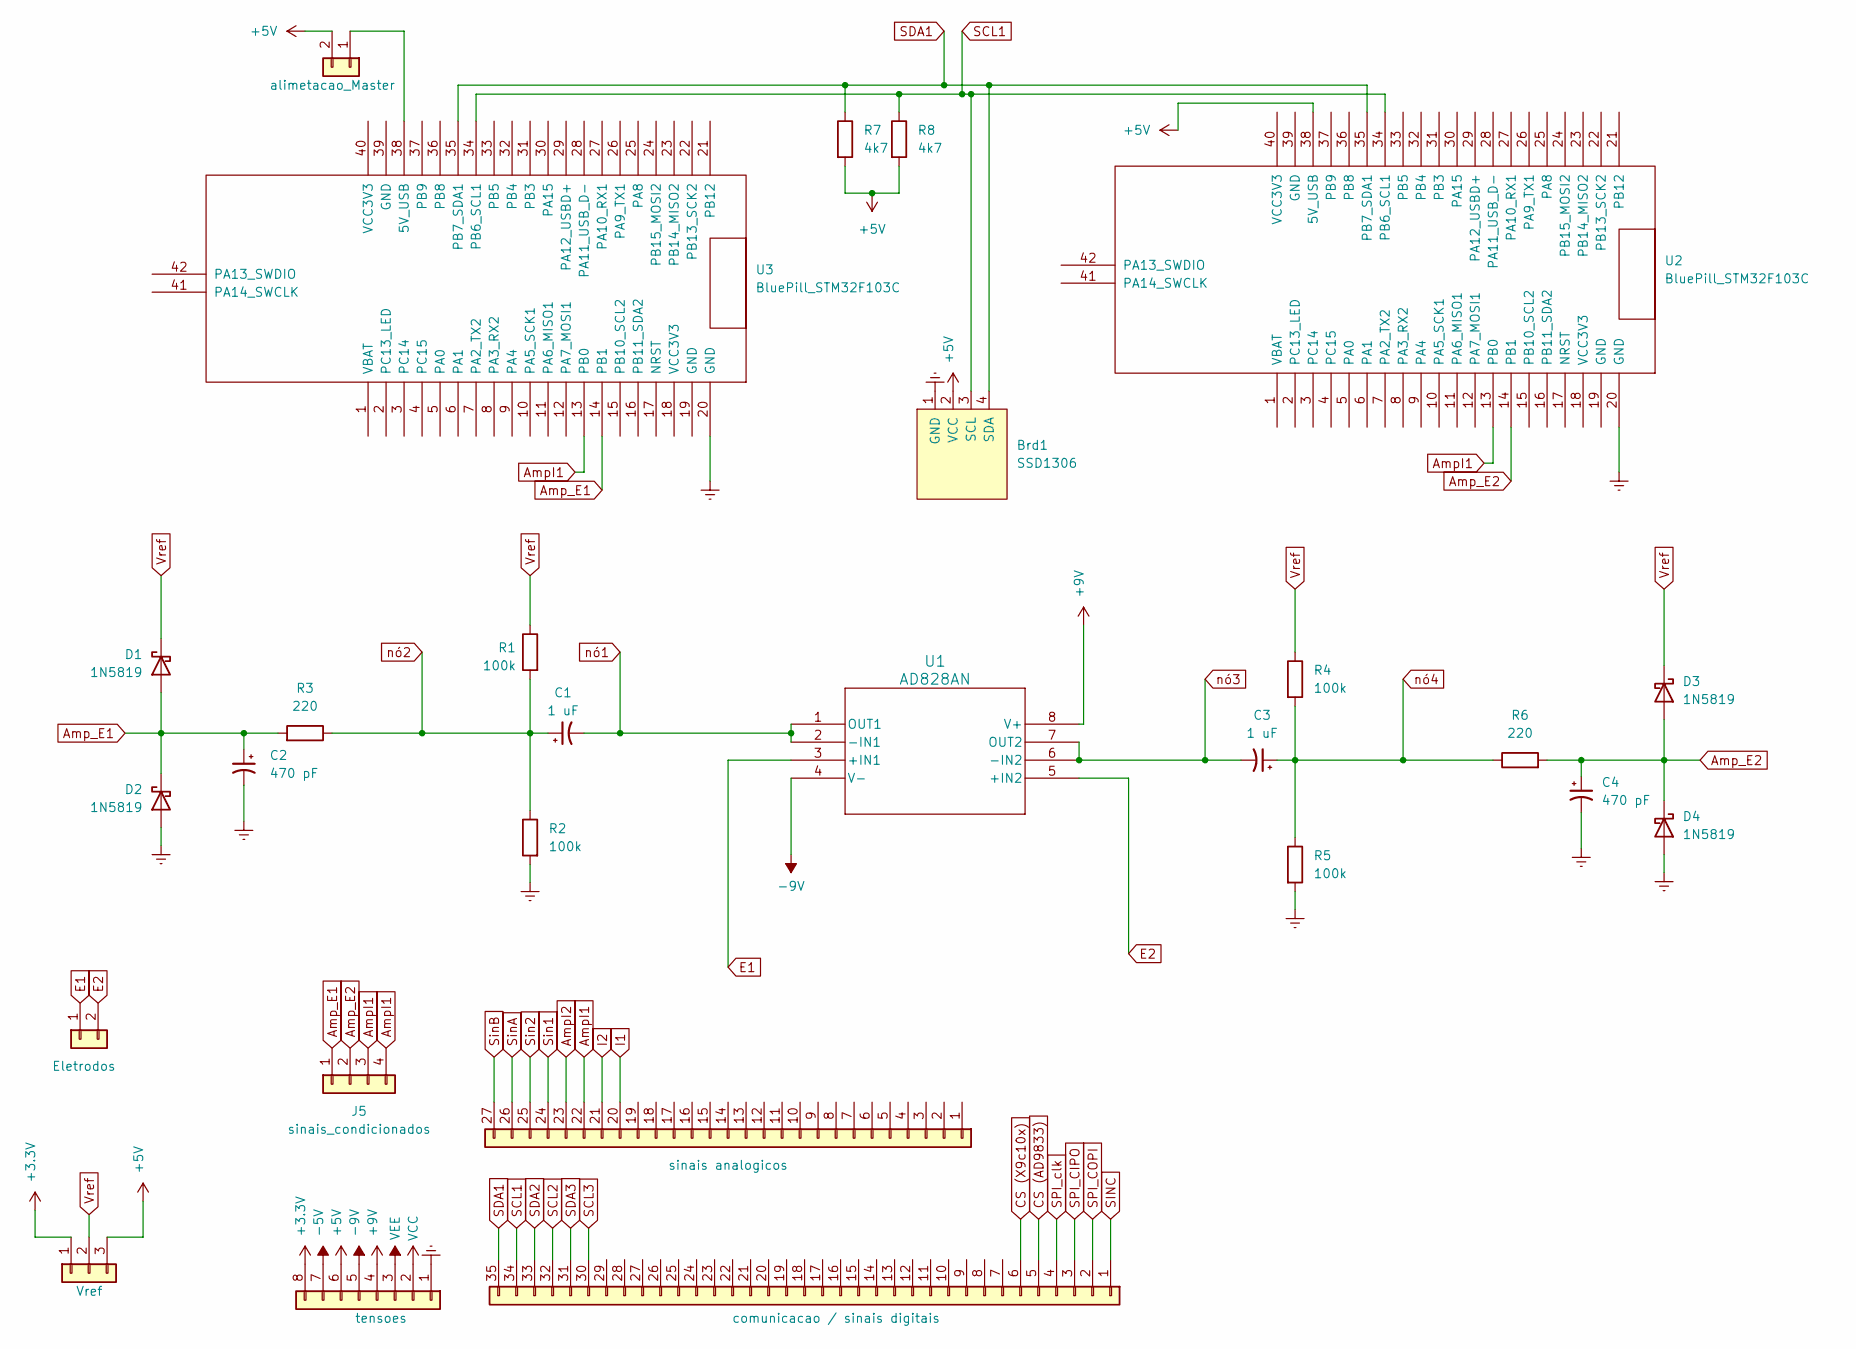
[picture p106: schematic condicionamento_BIA_v01.kicad_sch, Condicionamento 2 canais]

Parts:
Brd1: SSD1306; 128x64OLED
C1, C3: 1 uF; CP_Radial_D5.0mm_P2.50mm
C2, C4: 470 pF; CP_Radial_D5.0mm_P2.50mm
D1, D2, D3, D4: 1N5819; D_DO-41_SOD81_P10.16mm_Horizontal
J1: Vref; PinHeader_1x03_P2.54mm_Vertical
J2: tensoes; PinHeader_1x08_P2.54mm_Vertical
J3: sinais analogicos; PinHeader_1x27_P2.54mm_Vertical
J4: comunicacao / sinais digitais; PinHeader_1x35_P2.54mm_Vertical
J5: sinais_condicionados; PinHeader_1x04_P2.54mm_Horizontal
J6: alimetacao_Master; PinHeader_1x02_P2.54mm_Vertical
J7: Eletrodos; PinHeader_1x02_P2.54mm_Horizontal
R1, R2, R4, R5: 100k; R_Axial_DIN0207_L6.3mm_D2.5mm_P7.62mm_Horizontal
R3, R6: 220; R_Axial_DIN0207_L6.3mm_D2.5mm_P7.62mm_Horizontal
R7, R8: 4k7; R_Axial_DIN0207_L6.3mm_D2.5mm_P7.62mm_Horizontal
U1: AD828AN; N_8_ADI
U2, U3: BluePill_STM32F103C

Connections:
+3.3V: J1.1, J2.8
+5V: Brd1.2 (VCC), J1.3, J2.6, J6.2, R7.2, R8.2, U2.38 (5V_USB)
+9V: J2.4, U1.8 (V+)
-5V: J2.7
-9V: J2.5, U1.4 (V-)
AmpI1: J3.22, J5.3, J5.4, U2.13 (PB0), U3.13 (PB0)
AmpI2: J3.23
Amp_E1: C2.1, D1.2 (A), D2.1 (K), J5.1, R3.2, U3.14 (PB1)
Amp_E2: C4.1, D3.2 (A), D4.1 (K), J5.2, R6.2, U2.14 (PB1)
CS (AD9833): J4.5
CS (X9c10x): J4.6
E1: J7.1, U1.3 (+IN1)
E2: J7.2, U1.5 (+IN2)
Earth: Brd1.1 (GND), C2.2, C4.2, D2.2 (A), D4.2 (A), J2.1, R2.2, R5.2, U2.20 (GND), U3.20 (GND)
I1: J3.20
I2: J3.21
unnamed: J6.1, U3.38 (5V_USB)
SCL1: Brd1.3 (SCL), J4.34, R8.1, U2.34 (PB6_SCL1), U3.34 (PB6_SCL1)
SCL2: J4.32
SCL3: J4.30
SDA1: Brd1.4 (SDA), J4.35, R7.1, U2.35 (PB7_SDA1), U3.35 (PB7_SDA1)
SDA2: J4.33
SDA3: J4.31
SINC: J4.1
SPI_CIPO: J4.3
SPI_COPI: J4.2
SPI_clk: J4.4
Sin1: J3.24
Sin2: J3.25
SinA: J3.26
SinB: J3.27
VCC: J2.2
VEE: J2.3
Vref: D1.1 (K), D3.1 (K), J1.2, R1.1, R4.1
nó1: C1.2, U1.1 (OUT1), U1.2 (-IN1)
nó2: C1.1, R1.2, R2.1, R3.1
nó3: C3.2, U1.6 (-IN2), U1.7 (OUT2)
nó4: C3.1, R4.2, R5.1, R6.1

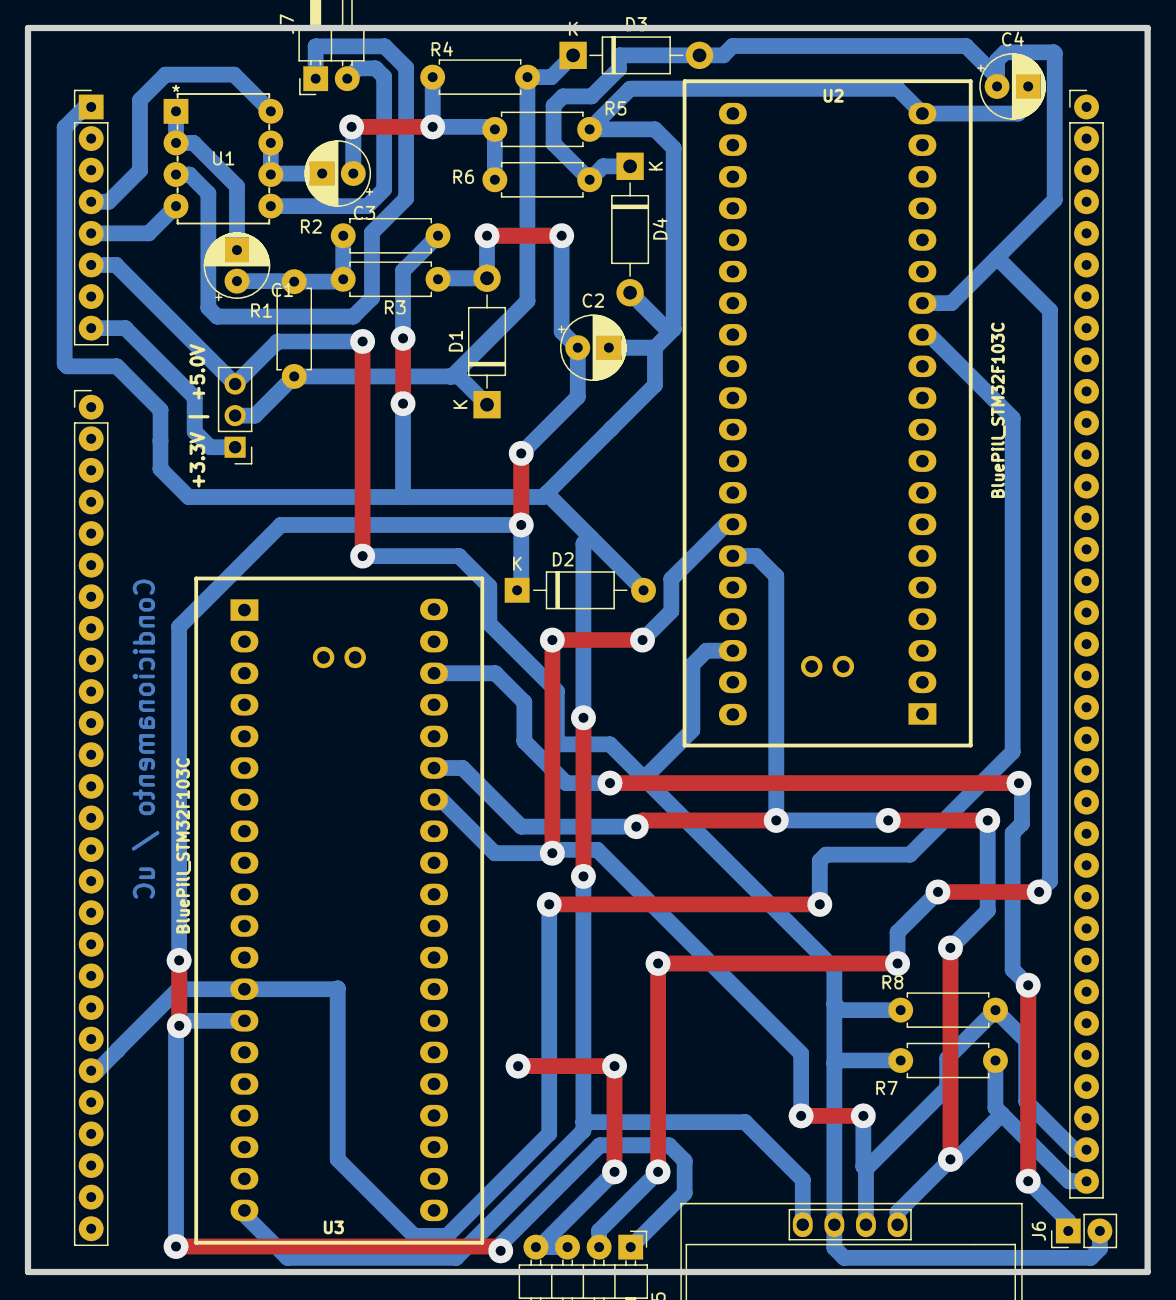
[picture p107: board condicionamento_BIA_v01.kicad_pcb from above]

Board: 2 copper layers, 90.0 x 100.0 mm, 27 parts (0 on the bottom side), 18 nets.
