Pinheirogustavo/Gustavo_TG_biomedica/Projetos das placas de circuito impresso/Kicad/Fonte de corrente monopolar/Fonte_corrente_mono.kicad_pcb

## KiCad design Projetos das placas de circuito impresso/Kicad/Fonte de corrente monopolar/Fonte_corrente_mono.kicad_pcb (2023-11-22)

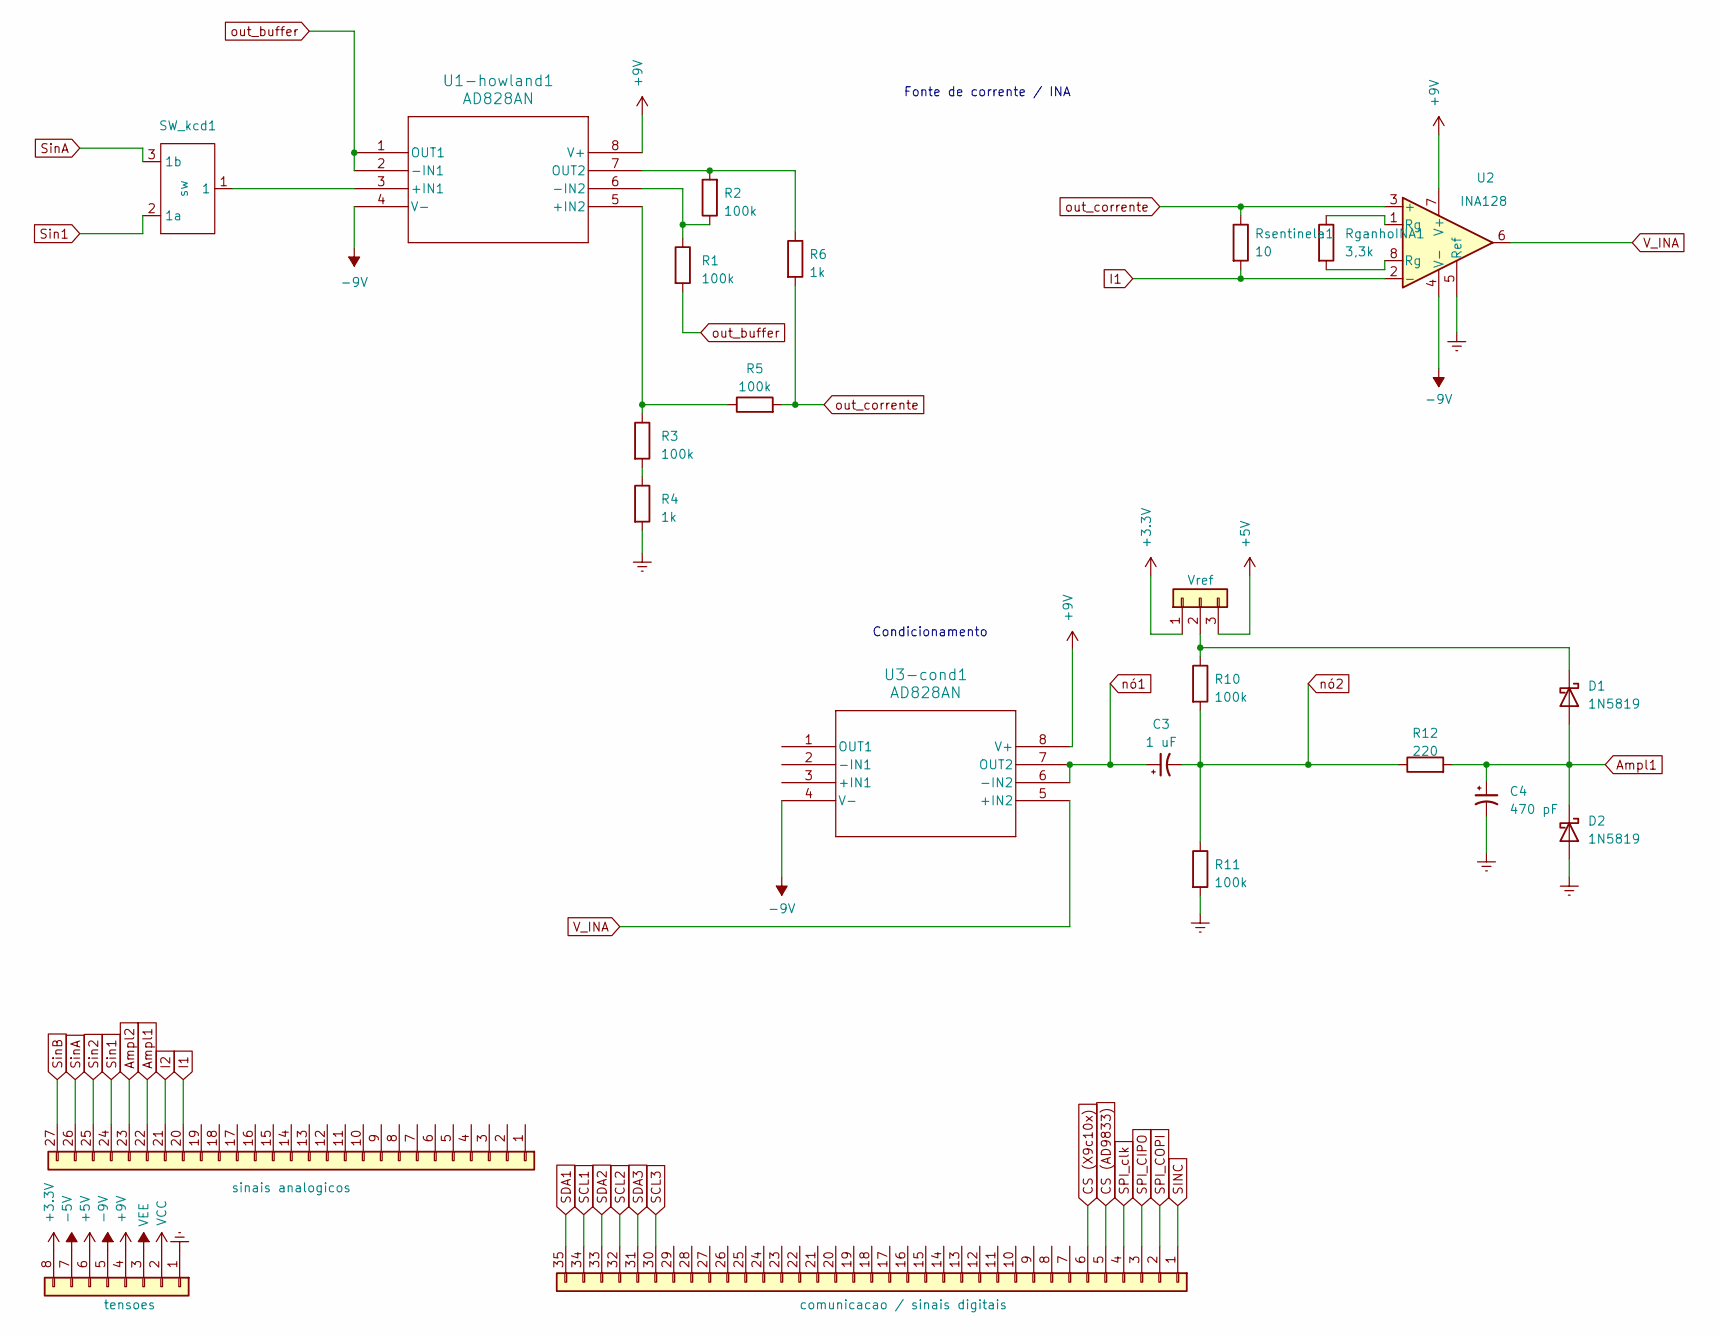
[picture p108: schematic Fonte_corrente_mono.kicad_sch, Fonte de corrente monopolar]

Parts:
C3: 1 uF; CP_Radial_D5.0mm_P2.50mm
C4: 470 pF; CP_Radial_D5.0mm_P2.50mm
D1, D2: 1N5819; D_DO-41_SOD81_P10.16mm_Horizontal
J1: Vref; PinHeader_1x03_P2.54mm_Vertical
J2: tensoes; PinSocket_1x08_P2.54mm_Vertical
J3: sinais analogicos; PinSocket_1x27_P2.54mm_Vertical
J4: comunicacao / sinais digitais; PinSocket_1x35_P2.54mm_Vertical
R1, R2, R3, R5, R10, R11: 100k; R_Axial_DIN0207_L6.3mm_D2.5mm_P7.62mm_Horizontal
R4, R6: 1k; R_Axial_DIN0207_L6.3mm_D2.5mm_P7.62mm_Horizontal
R12: 220; R_Axial_DIN0207_L6.3mm_D2.5mm_P7.62mm_Horizontal
RganhoINA1: 3,3k; R_Axial_DIN0207_L6.3mm_D2.5mm_P7.62mm_Horizontal
Rsentinela1: 10; R_Axial_DIN0207_L6.3mm_D2.5mm_P7.62mm_Horizontal
SW_kcd1: sw; chave gangorra 3 pinos
U1-howland1, U3-cond1: AD828AN; N_8_ADI
U2: INA128; DIP-8_W7.62mm

Connections:
+3.3V: J1.1, J2.8
+5V: J1.3, J2.6
+9V: J2.4, U1-howland1.8 (V+), U2.7 (V+), U3-cond1.8 (V+)
-5V: J2.7
-9V: J2.5, U1-howland1.4 (V-), U2.4 (V-), U3-cond1.4 (V-)
Ampl1: C4.1, D1.2 (A), D2.1 (K), J3.22, R12.2
Ampl2: J3.23
CS (AD9833): J4.5
CS (X9c10x): J4.6
Earth: C4.2, D2.2 (A), J2.1, R4.2, R11.2, U2.5 (Ref)
I1: J3.20, Rsentinela1.2, U2.2 (-)
I2: J3.21
unnamed: D1.1 (K), J1.2, R10.1
unnamed: R3.2, R4.1
unnamed: RganhoINA1.1, U2.1 (Rg)
unnamed: RganhoINA1.2, U2.8 (Rg)
unnamed: SW_kcd1.1, U1-howland1.3 (+IN1)
unnamed: R3.1, R5.1, U1-howland1.5 (+IN2)
unnamed: R1.1, R2.1, U1-howland1.6 (-IN2)
unnamed: R2.2, R6.1, U1-howland1.7 (OUT2)
SCL1: J4.34
SCL2: J4.32
SCL3: J4.30
SDA1: J4.35
SDA2: J4.33
SDA3: J4.31
SINC: J4.1
SPI_CIPO: J4.3
SPI_COPI: J4.2
SPI_clk: J4.4
Sin1: J3.24, SW_kcd1.2 (1a)
Sin2: J3.25
SinA: J3.26, SW_kcd1.3 (1b)
SinB: J3.27
VCC: J2.2
VEE: J2.3
V_INA: U2.6, U3-cond1.5 (+IN2)
nó1: C3.1, U3-cond1.6 (-IN2), U3-cond1.7 (OUT2)
nó2: C3.2, R10.2, R11.1, R12.1
out_buffer: R1.2, U1-howland1.1 (OUT1), U1-howland1.2 (-IN1)
out_corrente: R5.2, R6.2, Rsentinela1.1, U2.3 (+)

Notes on the sheet:
Fonte de corrente / INA
Condicionamento

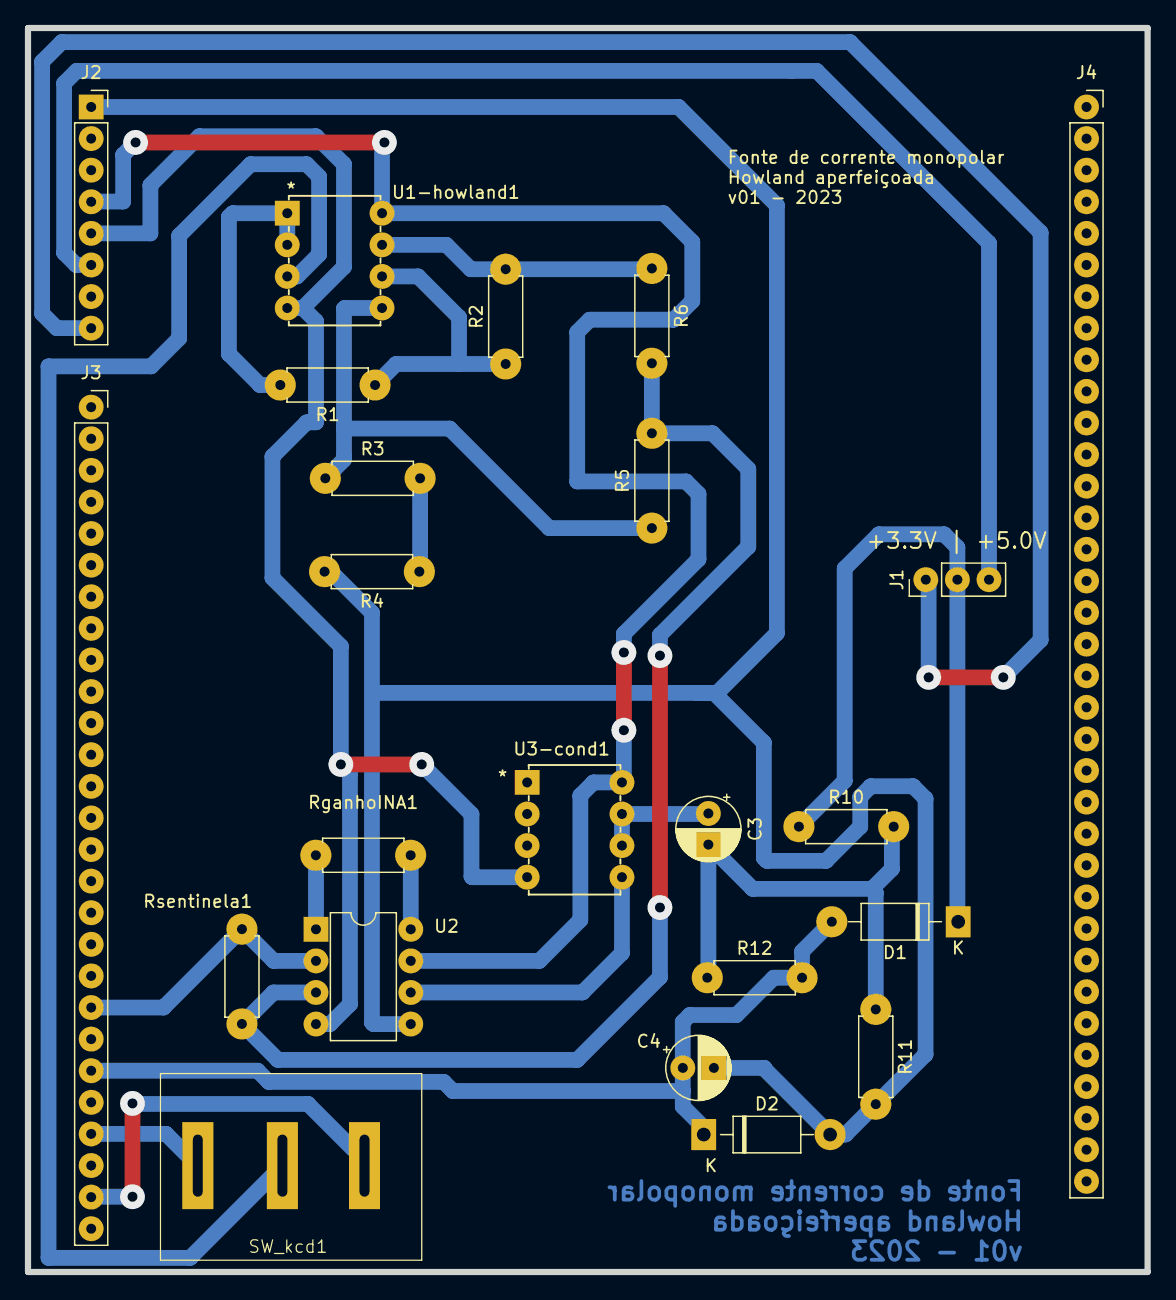
[picture p109: board Fonte_corrente_mono.kicad_pcb from above]

Board: 2 copper layers, 90.0 x 100.0 mm, 23 parts (0 on the bottom side), 22 nets.
