Pinheirogustavo/Gustavo_TG_biomedica/Projetos das placas de circuito impresso/Kicad/Fonte de tensão/Fonte_tensao_LM675_v03/Fonte_tensao_LM675_v03.kicad_pcb

## KiCad design Projetos das placas de circuito impresso/Kicad/Fonte de tensão/Fonte_tensao_LM675_v03/Fonte_tensao_LM675_v03.kicad_pcb (2023-11-22)

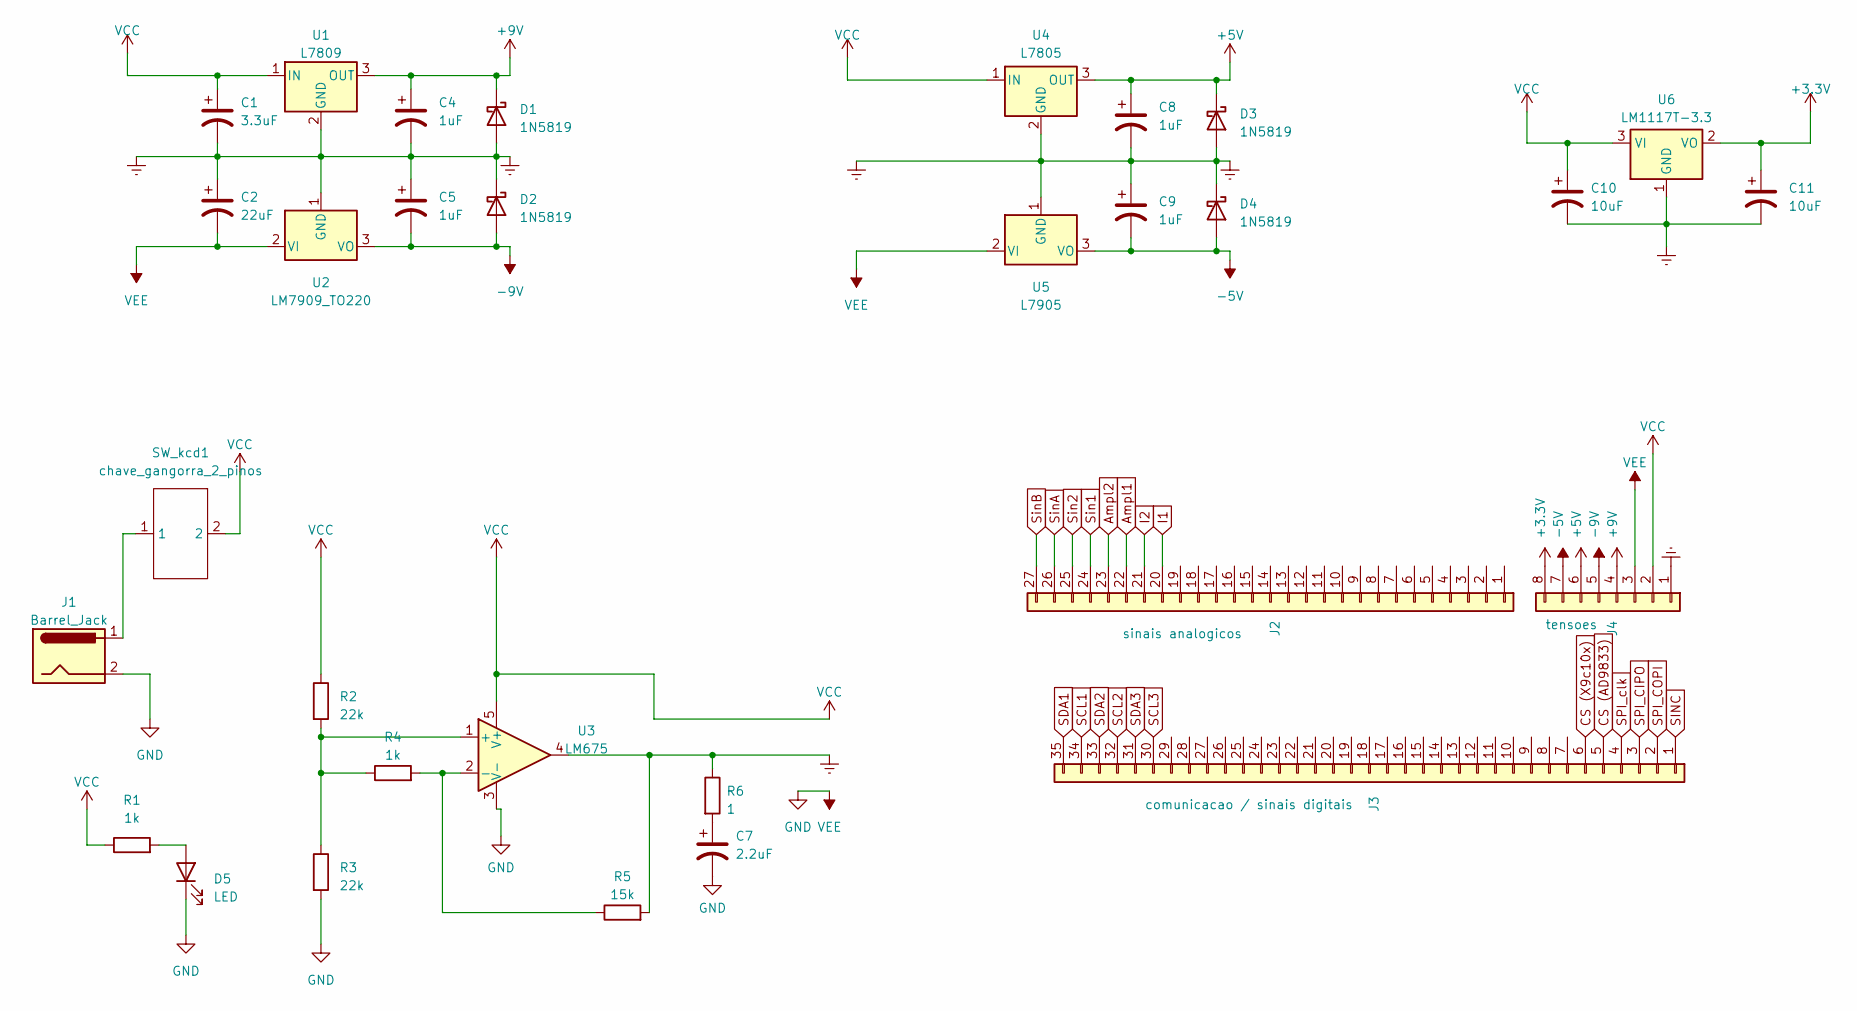
[picture p110: schematic Fonte_tensao_LM675_v03.kicad_sch, Fonte de tensao LM675]

Parts:
C1: 3.3uF; CP_Radial_D5.0mm_P2.50mm
C2: 22uF; CP_Radial_D5.0mm_P2.50mm
C4, C5, C8, C9: 1uF; CP_Radial_D5.0mm_P2.50mm
C7: 2.2uF; CP_Radial_D5.0mm_P2.50mm
C10, C11: 10uF; CP_Radial_D5.0mm_P2.50mm
D1, D2, D3, D4: 1N5819; D_DO-41_SOD81_P10.16mm_Horizontal
D5: LED; LED_D5.0mm
J1: Barrel_Jack; BarrelJack_GCT_DCJ200-10-A_Horizontal
J2: sinais analogicos; PinHeader_1x27_P2.54mm_Vertical
J3: comunicacao / sinais digitais; PinHeader_1x35_P2.54mm_Vertical
J4: tensoes; PinHeader_1x08_P2.54mm_Vertical
R1, R4: 1k; R_Axial_DIN0617_L17.0mm_D6.0mm_P20.32mm_Horizontal
R2, R3: 22k; R_Axial_DIN0617_L17.0mm_D6.0mm_P20.32mm_Horizontal
R5: 15k; R_Axial_DIN0617_L17.0mm_D6.0mm_P20.32mm_Horizontal
R6: 1; R_Axial_DIN0617_L17.0mm_D6.0mm_P20.32mm_Horizontal
SW_kcd1: chave_gangorra_2_pinos; chave gangorra 2 pinos
U1: L7809; TO-220-3_Vertical
U2: LM7909_TO220; TO-220-3_Vertical
U3: LM675; TO-220-5_P3.4x3.7mm_StaggerOdd_Lead3.8mm_Vertical
U4: L7805; TO-220-3_Vertical
U5: L7905; TO-220-3_Vertical
U6: LM1117T-3.3; TO-220-3_Vertical

Connections:
+3.3V: C11.1, J4.8, U6.2 (VO)
+5V: C8.1, D3.1 (K), J4.6, U4.3 (OUT)
+9V: C4.1, D1.1 (K), J4.4, U1.3 (OUT)
-5V: C9.2, D4.2 (A), J4.7, U5.3 (VO)
-9V: C5.2, D2.2 (A), J4.5, U2.3 (VO)
Ampl1: J2.22
Ampl2: J2.23
CS (AD9833): J3.5
CS (X9c10x): J3.6
Earth: C1.2, C2.1, C4.2, C5.1, C8.2, C9.1, C10.2, C11.2, D1.2 (A), D2.1 (K), D3.2 (A), D4.1 (K), J4.1, R5.2, R6.1, U1.2 (GND), U2.1 (GND), U3.4, U4.2 (GND), U5.1 (GND), U6.1 (GND)
GND: C2.2, C7.2, D5.1 (K), J1.2, J4.3, R3.2, U2.2 (VI), U3.3 (V-), U5.2 (VI)
I1: J2.20
I2: J2.21
unnamed: C7.1, R6.2
unnamed: D5.2 (A), R1.2
unnamed: J1.1, SW_kcd1.1
unnamed: R2.2, R3.1, R4.1, U3.1 (+)
unnamed: R4.2, R5.1, U3.2 (-)
SCL1: J3.34
SCL2: J3.32
SCL3: J3.30
SDA1: J3.35
SDA2: J3.33
SDA3: J3.31
SINC: J3.1
SPI_CIPO: J3.3
SPI_COPI: J3.2
SPI_clk: J3.4
Sin1: J2.24
Sin2: J2.25
SinA: J2.26
SinB: J2.27
VCC: C1.1, C10.1, J4.2, R1.1, R2.1, SW_kcd1.2, U1.1 (IN), U3.5 (V+), U4.1 (IN), U6.3 (VI)

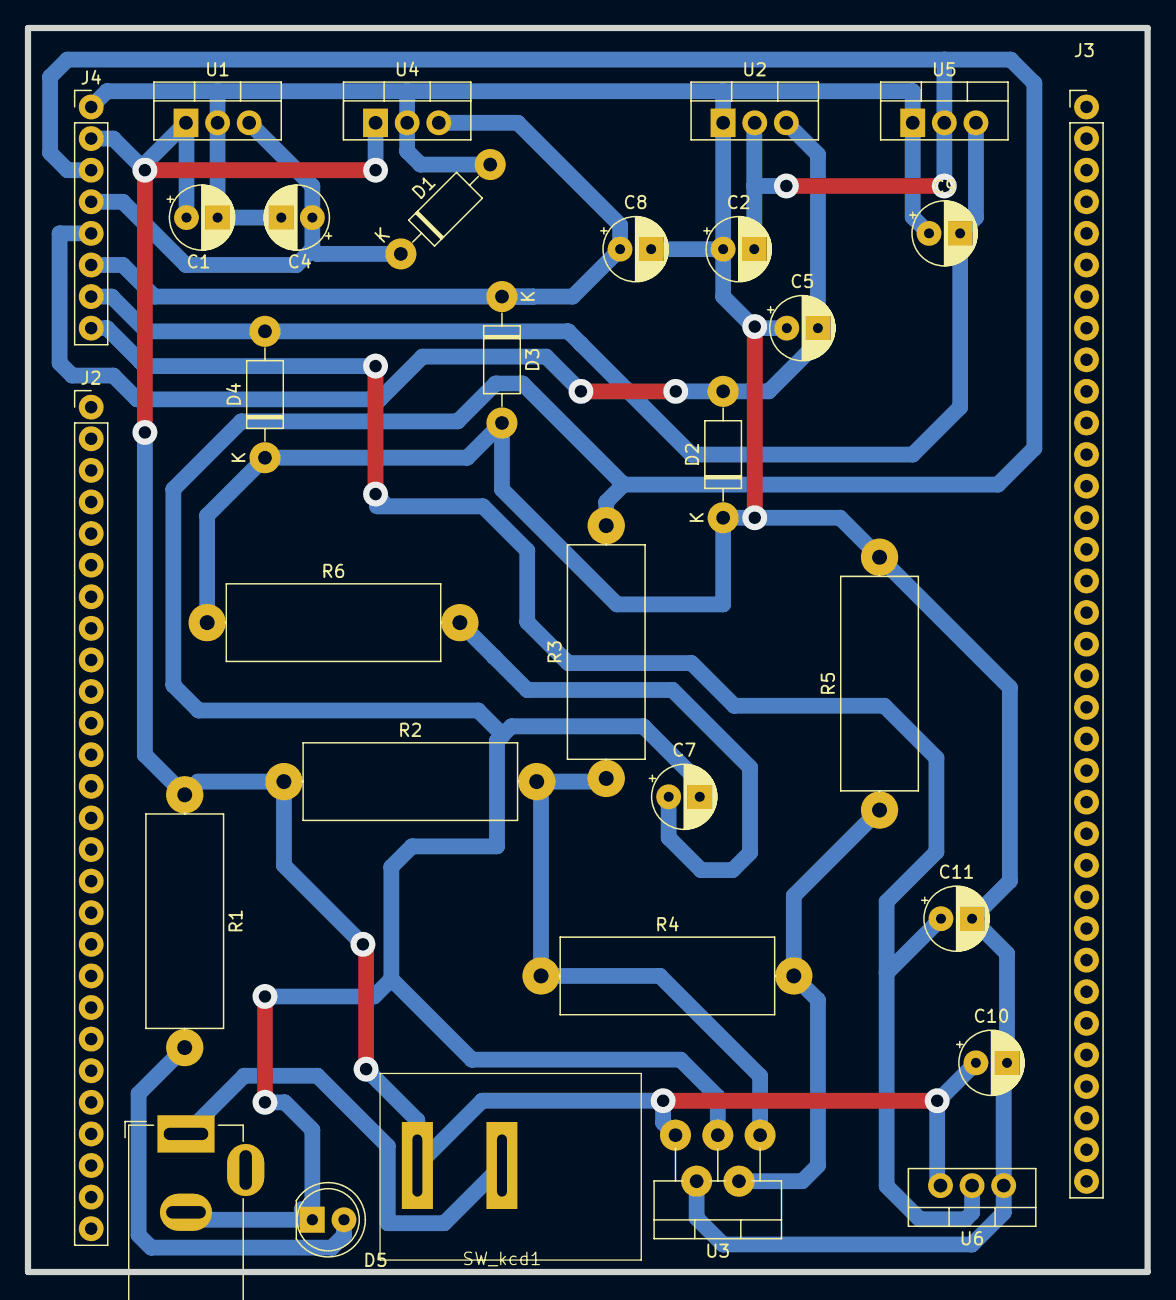
[picture p111: board Fonte_tensao_LM675_v03.kicad_pcb from above]

Board: 2 copper layers, 90.0 x 100.0 mm, 31 parts (0 on the bottom side), 13 nets.
