Pinheirogustavo/Gustavo_TG_biomedica/Projetos das placas de circuito impresso/Kicad/Fonte de tensão/Fonte_tensao_LM675_v01/Fonte_tensao_LM675.kicad_pcb

## KiCad design Projetos das placas de circuito impresso/Kicad/Fonte de tensão/Fonte_tensao_LM675_v01/Fonte_tensao_LM675.kicad_pcb (2023-11-22, an earlier design)

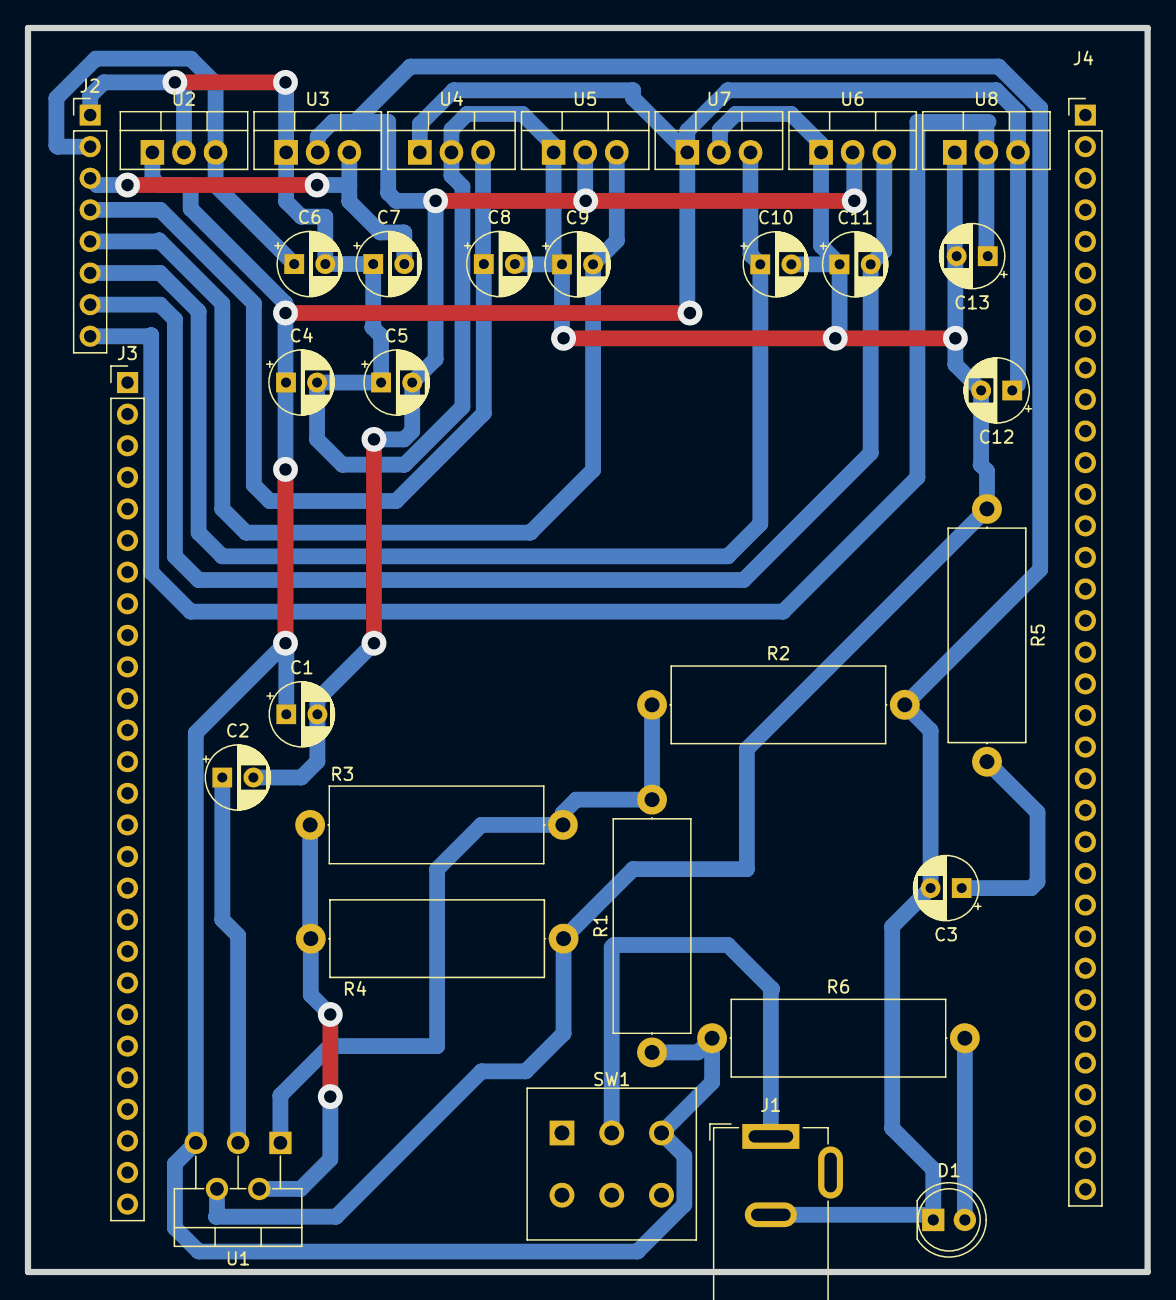
[picture p112: board Fonte_tensao_LM675.kicad_pcb from above]

Board: 2 copper layers, 90.0 x 100.0 mm, 33 parts (0 on the bottom side), 16 nets.

Parts:
C1: 0.1uf; CP_Radial_D5.0mm_P2.50mm
C2: 0.1uF; CP_Radial_D5.0mm_P2.50mm
C3: 0.22uF; CP_Radial_D5.0mm_P2.50mm
C4: 3.3uF; CP_Radial_D5.0mm_P2.50mm
C5: 22uF; CP_Radial_D5.0mm_P2.50mm
C6, C8, C10: 1uF; CP_Radial_D5.0mm_P2.50mm
C7, C9, C11, C12, C13: 10uF; CP_Radial_D5.0mm_P2.50mm
D1: LED; LED_D5.0mm
J1: Jack; BarrelJack_GCT_DCJ200-10-A_Horizontal
J2: tensoes; PinHeader_1x08_P2.54mm_Vertical
J3: sinais; PinHeader_1x27_P2.54mm_Vertical
J4: comunicacao; PinHeader_1x35_P2.54mm_Vertical
R1, R2: 22k; R_Axial_DIN0617_L17.0mm_D6.0mm_P20.32mm_Horizontal
R3: 1k; R_Axial_DIN0617_L17.0mm_D6.0mm_P20.32mm_Horizontal
R4: 15k; R_Axial_DIN0617_L17.0mm_D6.0mm_P20.32mm_Horizontal
R5: R; R_Axial_DIN0617_L17.0mm_D6.0mm_P20.32mm_Horizontal
R6: 1.5k; R_Axial_DIN0617_L17.0mm_D6.0mm_P20.32mm_Horizontal
SW1: SW_Push_DPDT; SW_PUSH_E-Switch_FS5700DP_DPDT
U1: LM675; TO-220-5_P3.4x3.7mm_StaggerOdd_Lead3.8mm_Vertical
U2: L7812; TO-220-3_Vertical
U3: L7912; TO-220-3_Vertical
U4: L7809; TO-220-3_Vertical
U5: LM7909_TO220; TO-220-3_Vertical
U6: L7905; TO-220-3_Vertical
U7: L7805; TO-220-3_Vertical
U8: LM1117T-3.3; TO-220-3_Vertical

Connections:
+3.3V: C13.1, J2.8, U8.2 (VO)
+5V: C10.1, J2.6, U7.3 (OUT)
+9V: C8.1, J2.4, U4.3 (OUT)
+12V: C6.1, J2.2, U2.3 (OUT)
-5V: C11.2, J2.7, U6.3 (VO)
-9V: C9.2, J2.5, U5.3 (VO)
-12V: C7.2, J2.3, U3.3 (VO)
Earth: C4.2, C5.1, C6.2, C7.1, C8.2, C9.1, C10.2, C11.1, C12.2, C13.2, J2.1, R4.2, R5.1, U1.4, U2.2 (GND), U3.1 (GND), U4.2 (GND), U5.1 (GND), U6.1 (GND), U7.2 (GND), U8.1 (GND)
GND: C1.2, C2.2, C3.2, C5.2, D1.1 (K), J1.2, R2.2, U3.2 (VI), U5.2 (VI), U6.2 (VI)
unnamed: C3.1, R5.2
unnamed: D1.2 (A), R6.2
unnamed: J1.1, SW1.2 (B)
unnamed: R1.2, R2.1, R3.1, U1.1 (+)
unnamed: R3.2, R4.1, U1.2 (-)
unnamed: C2.1, U1.3 (V-)
VCC: C1.1, C4.1, C12.1, R1.1, R6.1, SW1.3 (C), U1.5 (V+), U2.1 (IN), U4.1 (IN), U7.1 (IN), U8.3 (VI)
