Pinheirogustavo/Gustavo_TG_biomedica/Projetos das placas de circuito impresso/Kicad/Gerador de sinais/Gerador_sinais_AD9833.kicad_pcb

## KiCad design Projetos das placas de circuito impresso/Kicad/Gerador de sinais/Gerador_sinais_AD9833.kicad_pcb (2023-11-22)

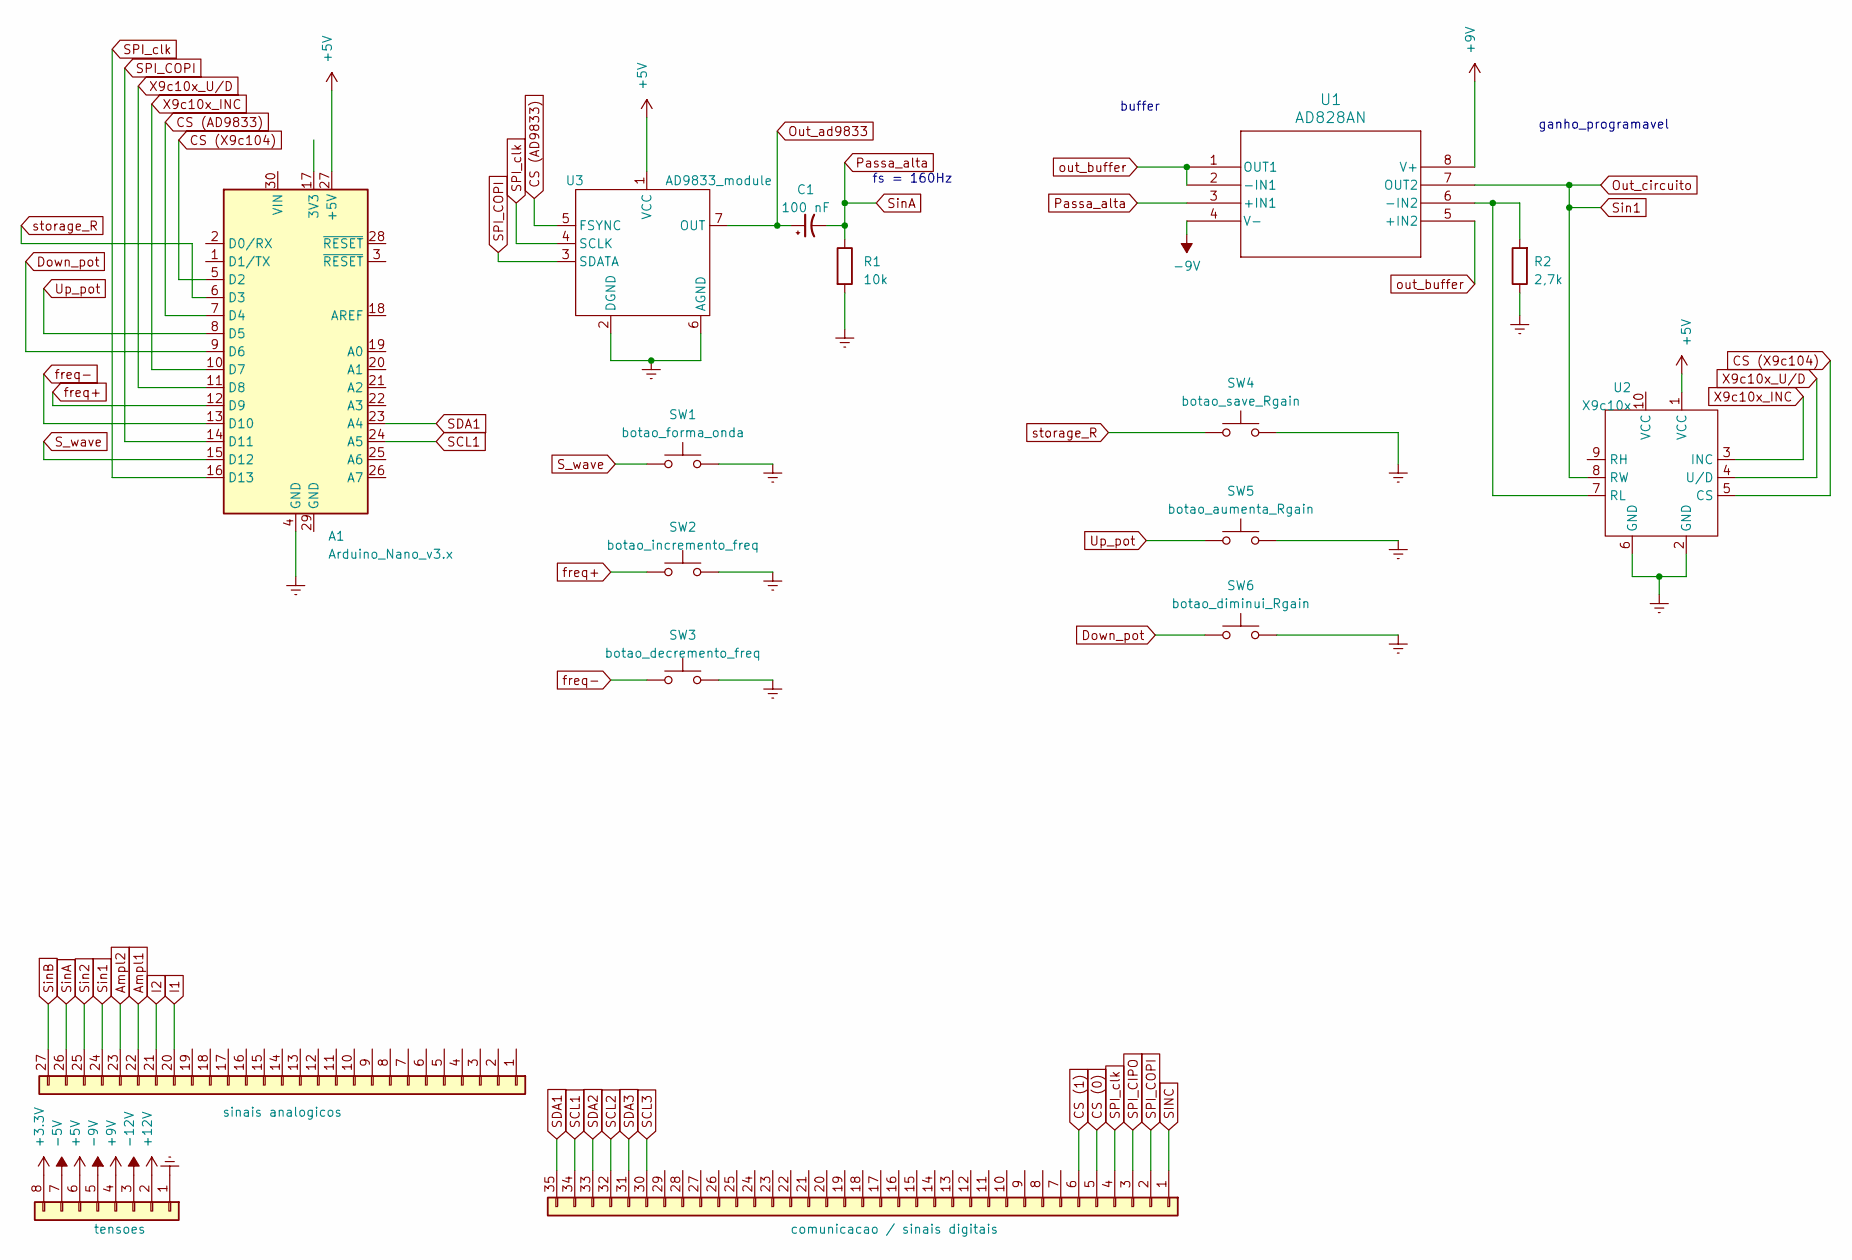
[picture p113: schematic Gerador_sinais_AD9833.kicad_sch, Gerador de sinais AD9833]

Parts:
A1: Arduino_Nano_v3.x; Arduino_Nano
C1: 100 nF; CP_Radial_D5.0mm_P2.50mm
J1: tensoes; PinHeader_1x08_P2.54mm_Vertical
J3: sinais analogicos; PinHeader_1x27_P2.54mm_Vertical
J4: comunicacao / sinais digitais; PinHeader_1x35_P2.54mm_Vertical
R1: 10k; R_Axial_DIN0204_L3.6mm_D1.6mm_P5.08mm_Horizontal
R2: 2,7k; R_Axial_DIN0204_L3.6mm_D1.6mm_P5.08mm_Horizontal
SW1: botao_forma_onda; SW_BUTT-2
SW2: botao_incremento_freq; SW_BUTT-2
SW3: botao_decremento_freq; SW_BUTT-2
SW4: botao_save_Rgain; SW_BUTT-2
SW5: botao_aumenta_Rgain; SW_BUTT-2
SW6: botao_diminui_Rgain; SW_BUTT-2
U1: AD828AN; N_8_ADI
U2: X9c10x; X9c10X_module
U3: AD9833_module

Connections:
+3.3V: J1.8
+5V: A1.27 (+5V), J1.6, U2.1 (VCC), U3.1 (VCC)
+9V: J1.4, U1.8 (V+)
+12V: J1.2
-5V: J1.7
-9V: J1.5, U1.4 (V-)
-12V: J1.3
Ampl1: J3.22
Ampl2: J3.23
CS (0): J4.5
CS (1): J4.6
CS (AD9833): A1.7 (D4), U3.5 (FSYNC)
CS (X9c104): A1.5 (D2), U2.5 (CS)
Down_pot: A1.9 (D6), SW6.1
Earth: A1.4 (GND), J1.1, R1.2, R2.1, SW1.2, SW2.2, SW3.2, SW4.2, SW5.2, SW6.2, U2.2 (GND), U2.6 (GND), U3.2 (DGND), U3.6 (AGND)
I1: J3.20
I2: J3.21
unnamed: R2.2, U1.6 (-IN2), U2.7 (RL)
Out_ad9833: C1.1, U3.7 (OUT)
Out_circuito: J3.24, U1.7 (OUT2), U2.8 (RW)
Passa_alta: C1.2, J3.26, R1.1, U1.3 (+IN1)
SCL1: A1.24 (A5), J4.34
SCL2: J4.32
SCL3: J4.30
SDA1: A1.23 (A4), J4.35
SDA2: J4.33
SDA3: J4.31
SINC: J4.1
SPI_CIPO: J4.3
SPI_COPI: A1.14 (D11), J4.2, U3.3 (SDATA)
SPI_clk: A1.16 (D13), J4.4, U3.4 (SCLK)
S_wave: A1.15 (D12), SW1.1
Sin2: J3.25
SinB: J3.27
Up_pot: A1.8 (D5), SW5.1
X9c10x_INC: A1.10 (D7), U2.3 (INC)
X9c10x_U/D: A1.11 (D8), U2.4 (U/D)
freq+: A1.12 (D9), SW2.1
freq-: A1.13 (D10), SW3.1
out_buffer: U1.1 (OUT1), U1.2 (-IN1), U1.5 (+IN2)
storage_R: A1.6 (D3), SW4.1

Notes on the sheet:
ganho_programavel
fs = 160Hz
buffer

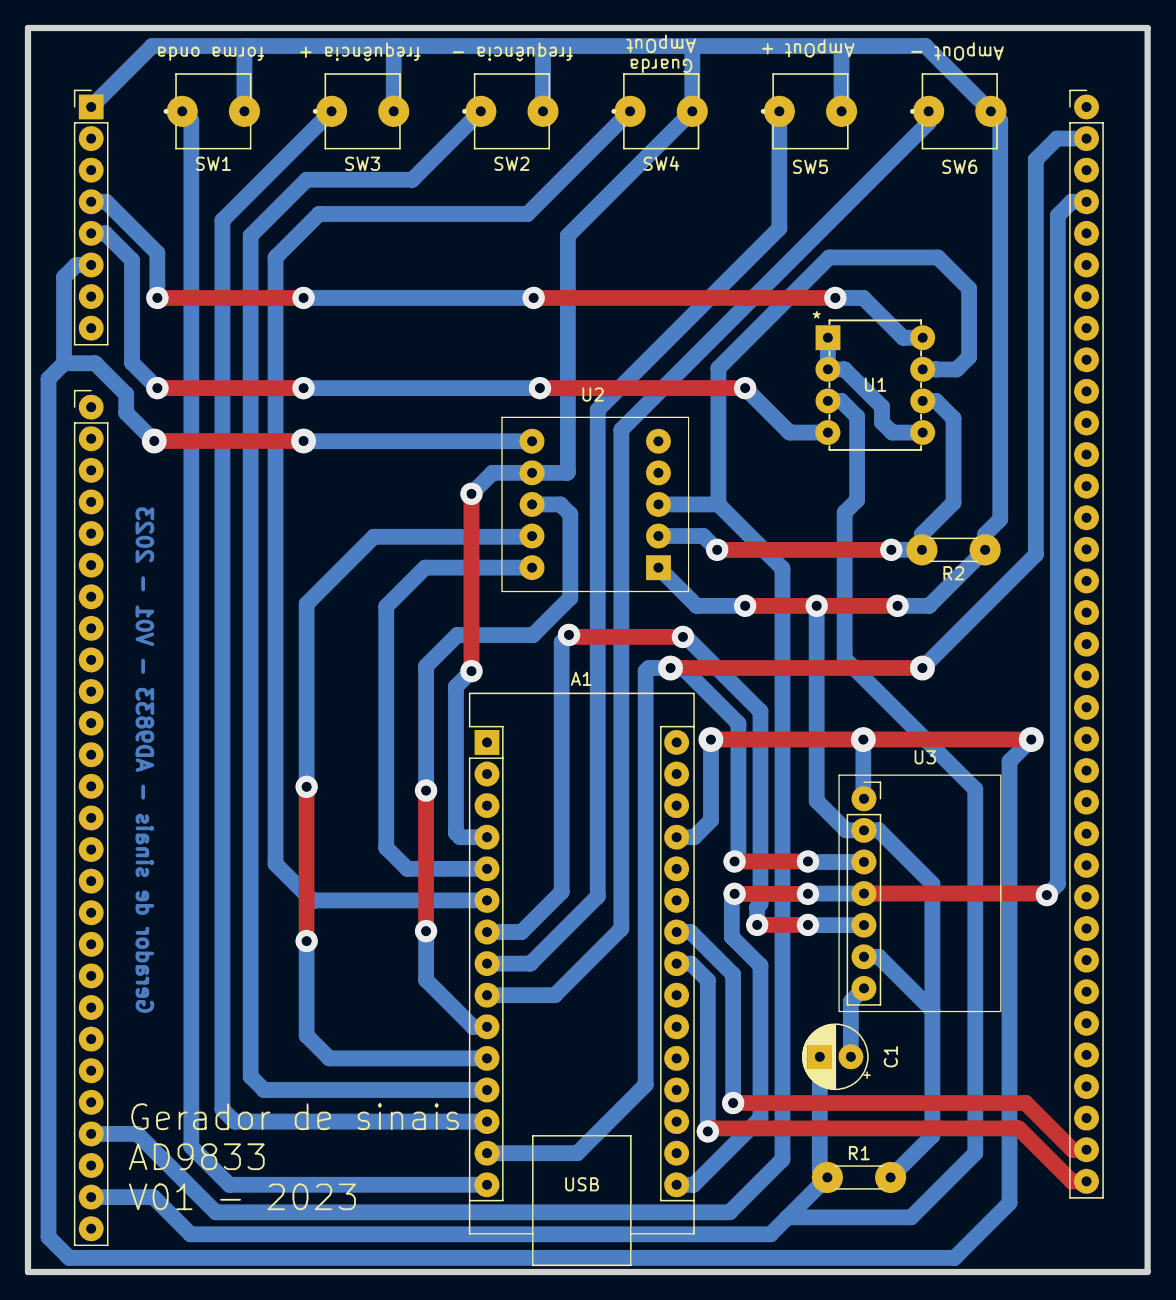
[picture p114: board Gerador_sinais_AD9833.kicad_pcb from above]

Board: 2 copper layers, 90.0 x 100.0 mm, 16 parts (0 on the bottom side), 23 nets.
