Pinheirogustavo/Gustavo_TG_biomedica/(commit log)

2020-10-09 tentativas de aquisicao
2021-08-20 novas versões pcb
    [circuito_condicionamento.sch, condicionamento_pcb(copy).fzz, condicionamento_pcb_V2.fzz, fonte_corrente (copy).fzz, fonte_corrente.sch, fonte_corrente_V2.fzz, fonte_tensao_V2.fzz, fonte_tensão (copy).fzz]
2022-06-30 incluindo os esquemas de PCB para a fonte de tensao que utiliza o transformador externo, do resistor sentinela e do Gerador de onda baseado em ad9833
    [ResistorSentinela.fzz, entrada.fzz, entrada_compacto.fzz, gerador_ad9833.fzz]
2022-07-14 nova placa de condicionamento, agora com duas entradas e baseado em AD826
    [condicionamento_pcb_baseado_ad826.fzz, gerador_ad9833.fzz]
2022-07-18 atualizacoes de PCB
    [condicionamento_pcb_baseado_ad826.fzz, gerador_ad9833.fzz]
2022-07-21 fonte tensao baseada em lm675 e suporte da bluepill
    [SMT32.fzz, tensao_baseado_lm675.fzz]
2022-07-25 revisao das placas PCB
    [SMT32.fzz, tensao_baseado_lm675.fzz]
2022-08-08 Segunda versao do gerador de sinais baseado no modulo ad9833
    [gerador_ad9833_versao_2.fzz]
2022-08-08 Segunda versao do gerador de sinais baseado em ad9833
    [gerador_ad9833_versao_2.fzz]
2022-08-16 correcao do gerador de sinais para usinagem
    [gerador_ad9833_versao_2.fzz]
2022-08-16 tutorial de resolucoes kicad
2022-08-16 mudanca seguidores gerador baseado em ad9833
    [gerador_ad9833_versao_2_Erick.fzz]
2022-08-16 Gerador_AD9833_ganho_controlavel_v2 16/08/2022
    [Gerador_AD9833_ganho_controlavel_v2.fzz, gerador_ad9833_versao_2_Erick.fzz]
2022-08-16 Gerador_AD9833_v2 16/08/2022
    [Gerador_AD9833_ganho_controlavel_v2.fzz, Gerador_AD9833_v2.fzz]
2022-08-18 Gerber Gerador_AD9833_v2
    [Gerador_AD9833_v2_contour.gm1, Gerador_AD9833_v2_copperBottom.gbl, Gerador_AD9833_v2_copperTop.gtl, Gerador_AD9833_v2_maskBottom.gbs, Gerador_AD9833_v2_maskTop.gts, Gerador_AD9833_v2_silkBottom.gbo, Gerador_AD9833_v2_silkTop.gto]
2023-03-16 Incluindos versões definitivas dos hardwares
    [Condicionamento_entrada_dupla_AD826.fzz, Condicionamento_entrada_unica_741.fzz, Fonte_tensao_baseado_lm675.fzz, Gerador_AD9833_ganho_trimpot.fzz, Gerador_AD9833_v2.fzz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]
2023-03-30 pcb sentinela
    [ResistorSentinela.fzz, resistor_sentinela.fzz]
2023-11-22 versao final TG
    [Condicionamento_entrada_dupla_AD826.fzz, Condicionamento_entrada_unica_741.fzz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]
2023-11-28 versao final
    [eqs_ffm.csv, eqs_ffm_transposta.csv, ffm.csv]
2023-12-06 Dados de bioimpedancia obtidos com o prototipo
    [dados_bioimpedancia.ods]
2023-12-06 Dados bioimpedancia balanca comercial e dados antropometricos
    [voluntarios.ods]
2023-12-06 dados backup todos volun
    [dados_bioimpedancia_todos.ods]
